feroxes/pytaichenko/site/assets/photo.jpg

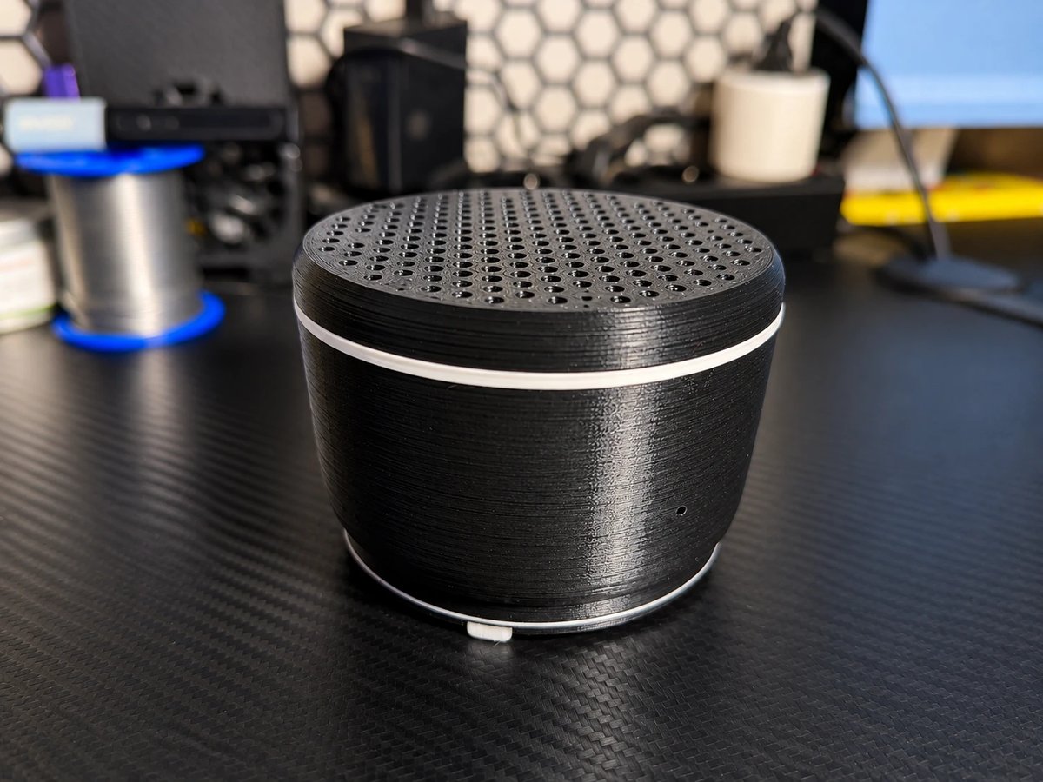
site/assets/photo.jpg
