feroxes/pytaichenko/site/assets/photos-v2/inside.jpg

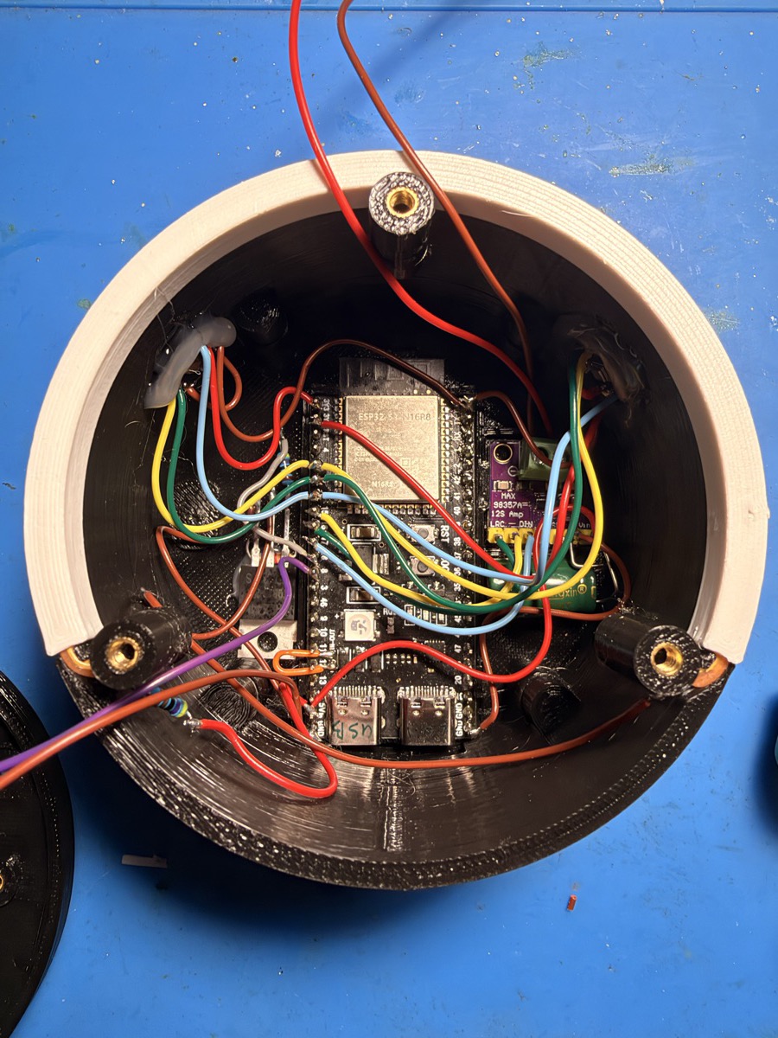
site/assets/photos-v2/inside.jpg
