feroxes/pytaichenko/site/assets/photos-v2/pytaichenko.jpg

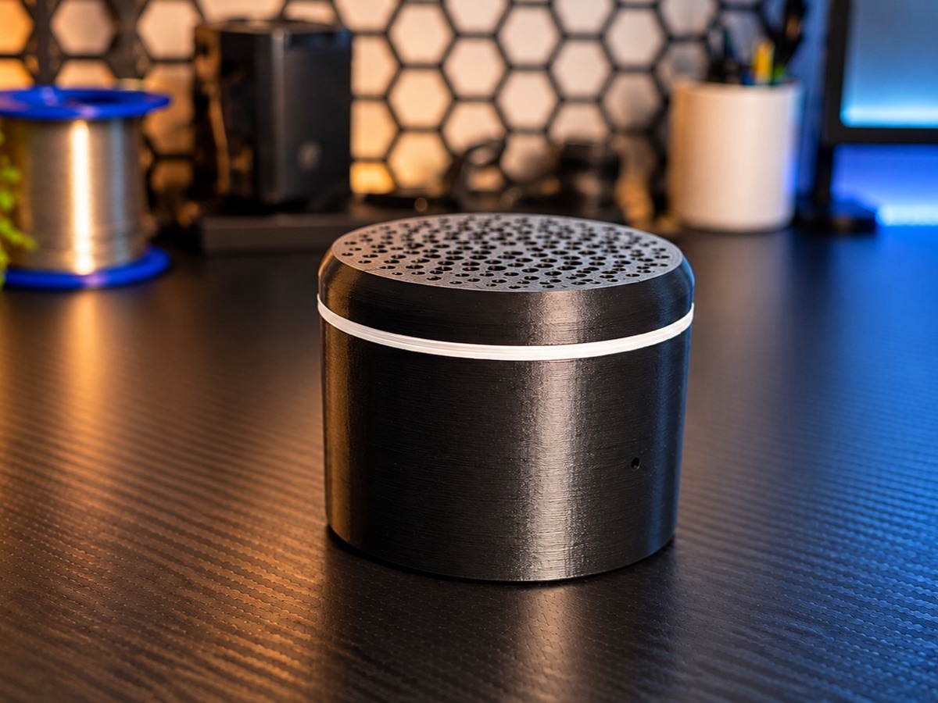
site/assets/photos-v2/pytaichenko.jpg
