feroxes/pytaichenko/site/assets/renders/v2/hero.png

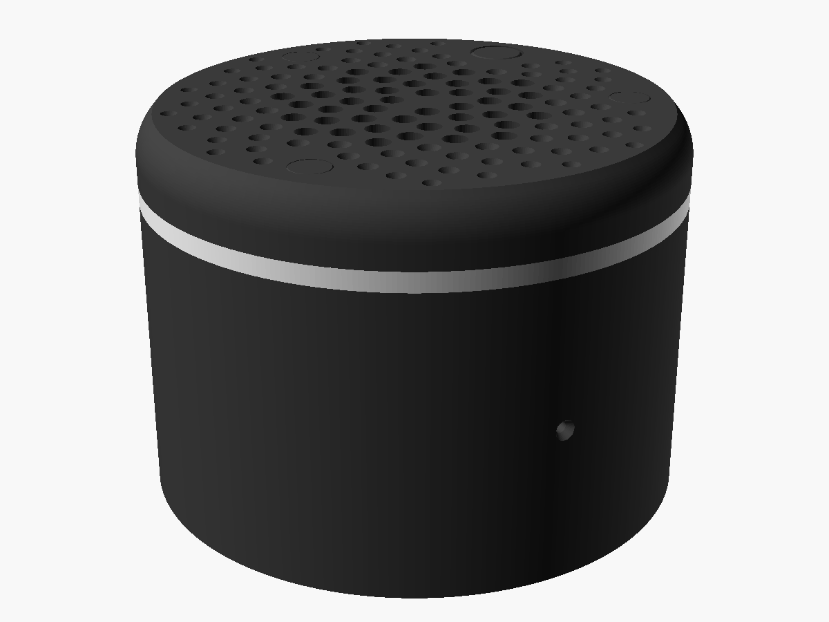
site/assets/renders/v2/hero.png
