feroxes/pytaichenko/v2/case/stl/PETG-black_tray.stl

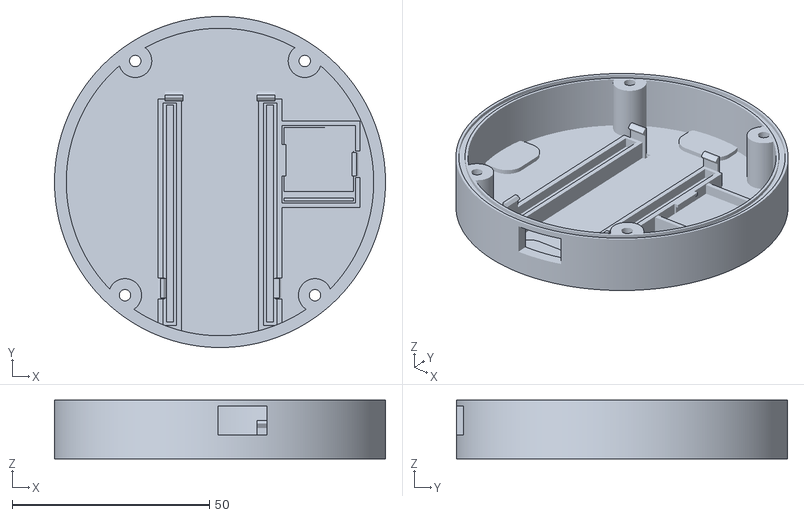
[picture p6: CAD file, 2026-11-10]
v2/case/stl/PETG-black_tray.stl
84.0 x 84.0 x 14.9
