feroxes/pytaichenko/v2/case/stl/TPU_top_gasket.stl

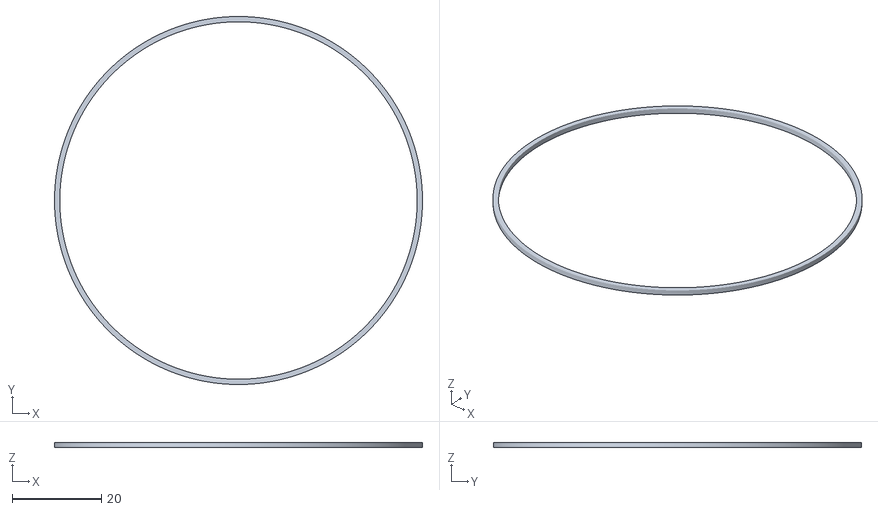
[picture p7: CAD file, 2026-11-10]
v2/case/stl/TPU_top_gasket.stl
82.5 x 82.5 x 1.20
