feroxes/pytaichenko/v2/case/stl/TPU_com_bushing.stl

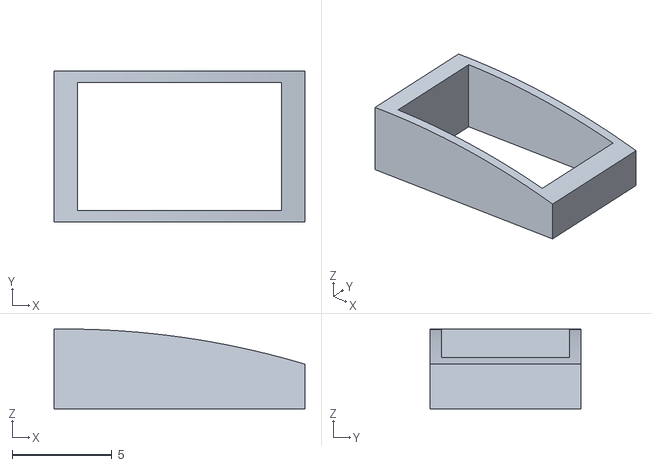
[picture p8: CAD file, 2026-11-10]
v2/case/stl/TPU_com_bushing.stl
12.6 x 7.55 x 4.00
