feroxes/pytaichenko/v2/case/stl/PETG-white_ring_arc.stl

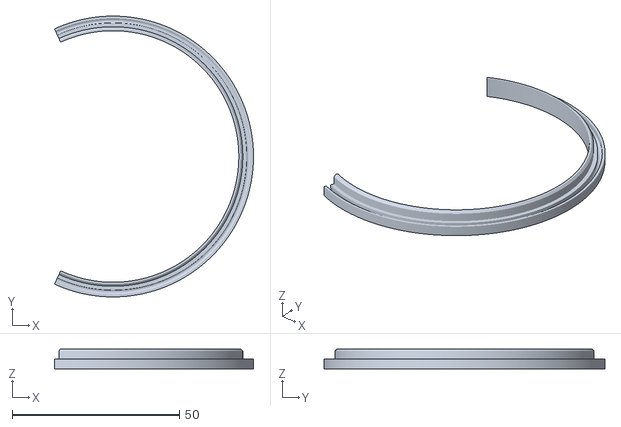
[picture p9: CAD file, 2026-11-10]
v2/case/stl/PETG-white_ring_arc.stl
59.5 x 84.0 x 5.88
