feroxes/pytaichenko/v2/case/stl/PETG-black_body.stl

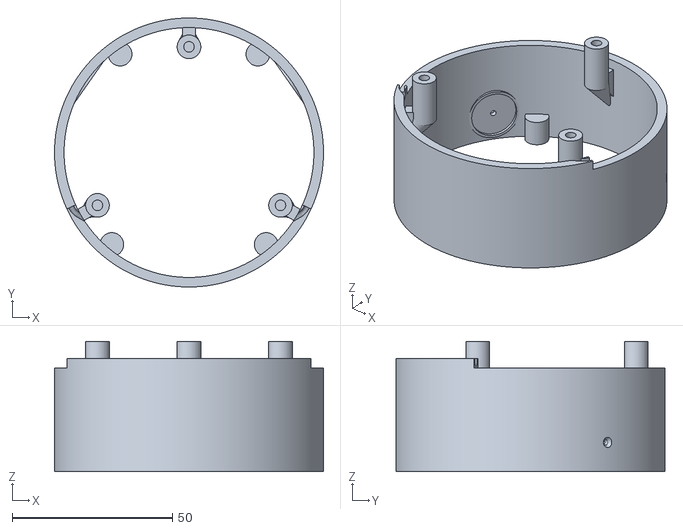
[picture p10: CAD file, 2026-11-10]
v2/case/stl/PETG-black_body.stl
84.0 x 84.0 x 40.6
