feroxes/pytaichenko/v2/case/stl/PETG-black_top.stl

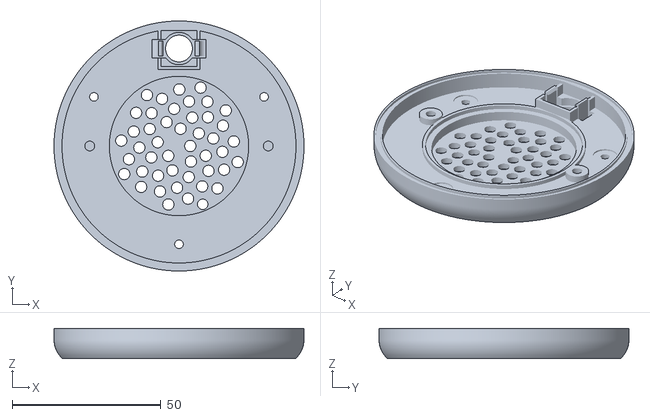
[picture p11: CAD file, 2026-11-10]
v2/case/stl/PETG-black_top.stl
84.0 x 84.0 x 10.2
