feroxes/pytaichenko/v2/case/stl/PETG-black_top_plug_x3.stl

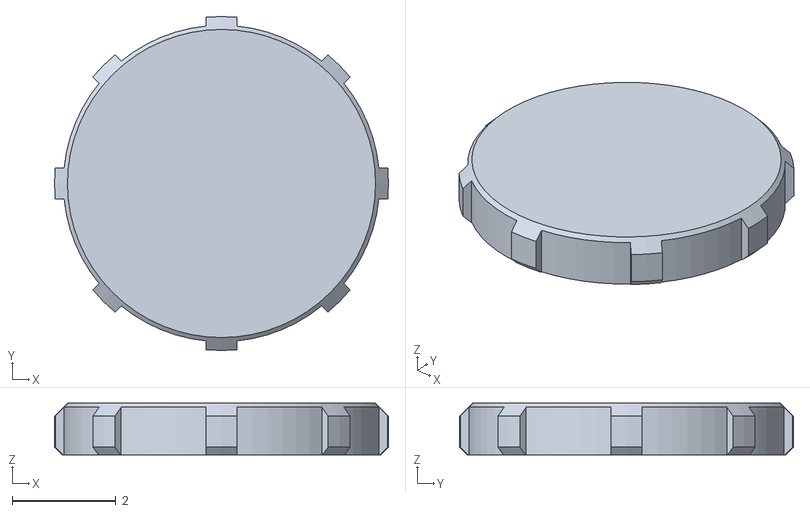
[picture p12: CAD file, 2026-11-10]
v2/case/stl/PETG-black_top_plug_x3.stl
6.44 x 6.44 x 1.00
