feroxes/pytaichenko/v2/case/stl/TPU_speaker_gasket.stl

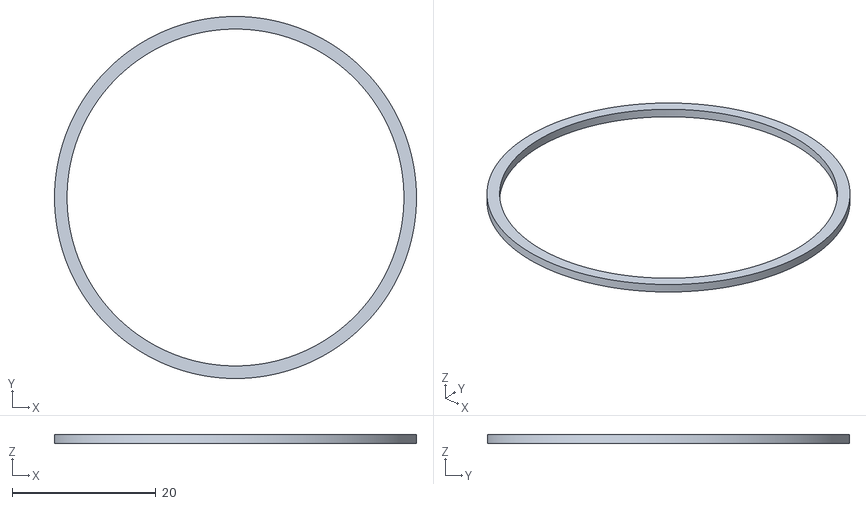
[picture p13: CAD file, 2026-11-10]
v2/case/stl/TPU_speaker_gasket.stl
50.3 x 50.3 x 1.20
