feroxes/pytaichenko/v2/case/stl/PETG-black_button_cap.stl

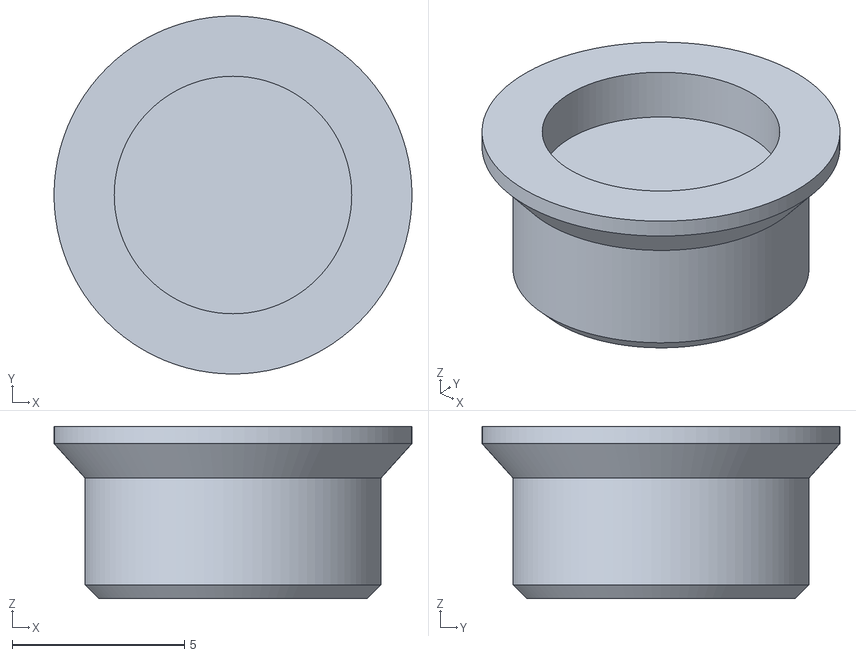
[picture p14: CAD file, 2026-11-10]
v2/case/stl/PETG-black_button_cap.stl
10.4 x 10.4 x 5.00
