feroxes/pytaichenko/v2/case/stl/TPU_foot_x4.stl

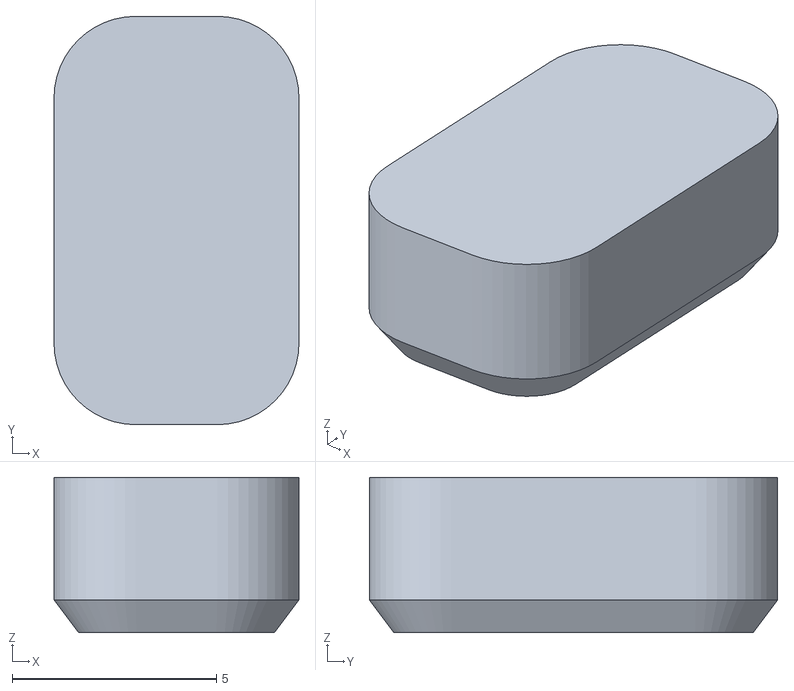
[picture p15: CAD file, 2026-11-02]
v2/case/stl/TPU_foot_x4.stl
6.00 x 10.0 x 3.80
