feroxes/pytaichenko/v1/case/stl/PETG-black_body.stl

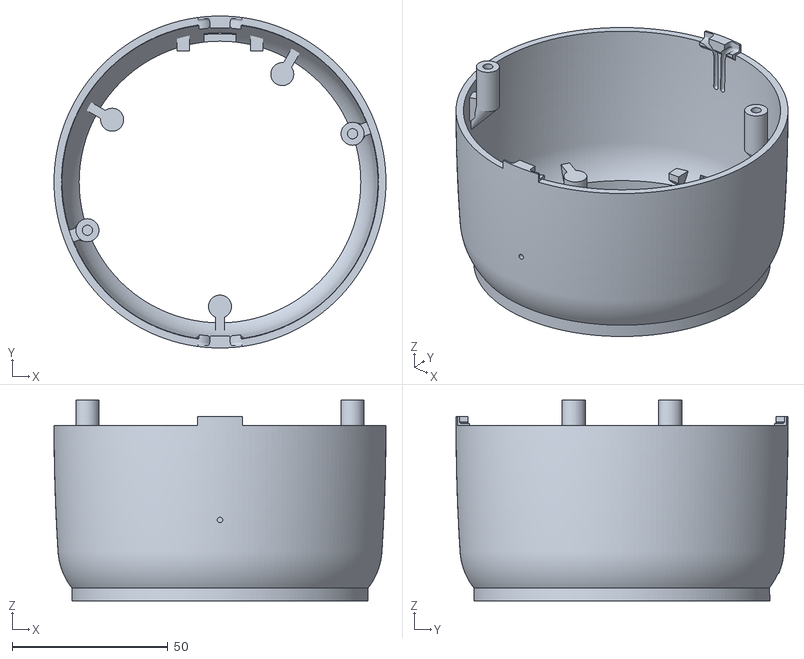
[picture p16: CAD file, 2026-11-02, an earlier design]
v1/case/stl/PETG-black_body.stl
106.6 x 106.6 x 64.5
