feroxes/pytaichenko/v1/case/stl/TPU_top_plug_x2.stl

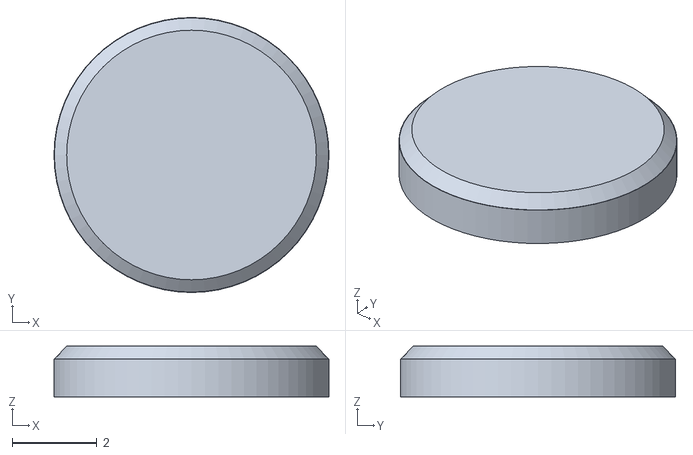
[picture p17: CAD file, 2026-11-02, an earlier design]
v1/case/stl/TPU_top_plug_x2.stl
6.50 x 6.50 x 1.20
