feroxes/pytaichenko/v1/case/stl/PETG-black_top.stl

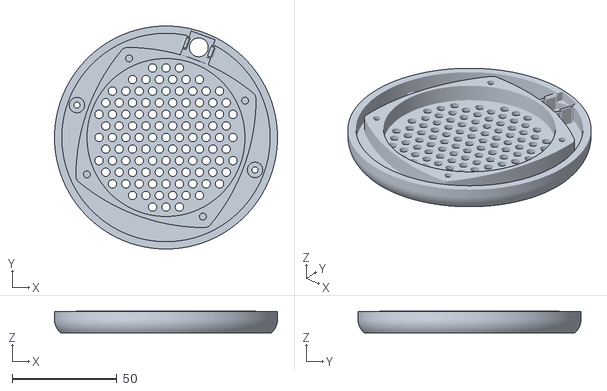
[picture p18: CAD file, 2026-11-02, an earlier design]
v1/case/stl/PETG-black_top.stl
106.6 x 106.6 x 10.3
