feroxes/pytaichenko/v1/case/stl/PETG-black_tray.stl

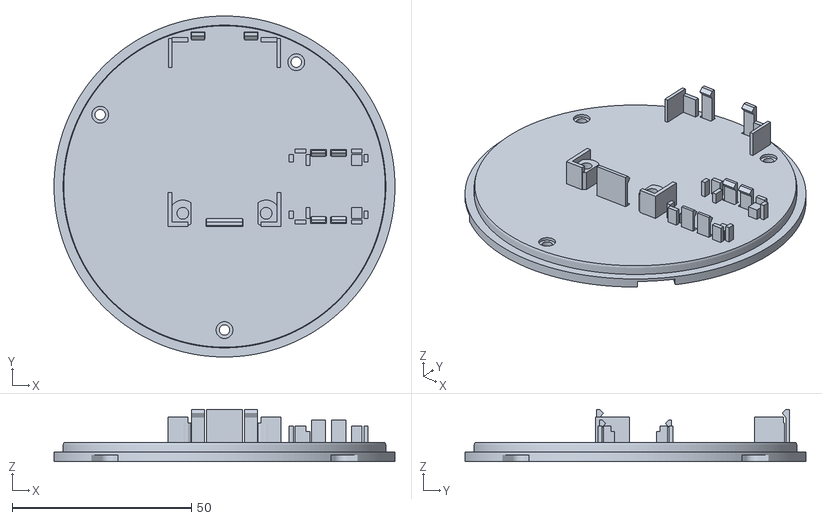
[picture p19: CAD file, 2026-11-02, an earlier design]
v1/case/stl/PETG-black_tray.stl
95.0 x 95.0 x 14.5
