feroxes/pytaichenko/v1/case/stl/TPU_tray_gasket.stl

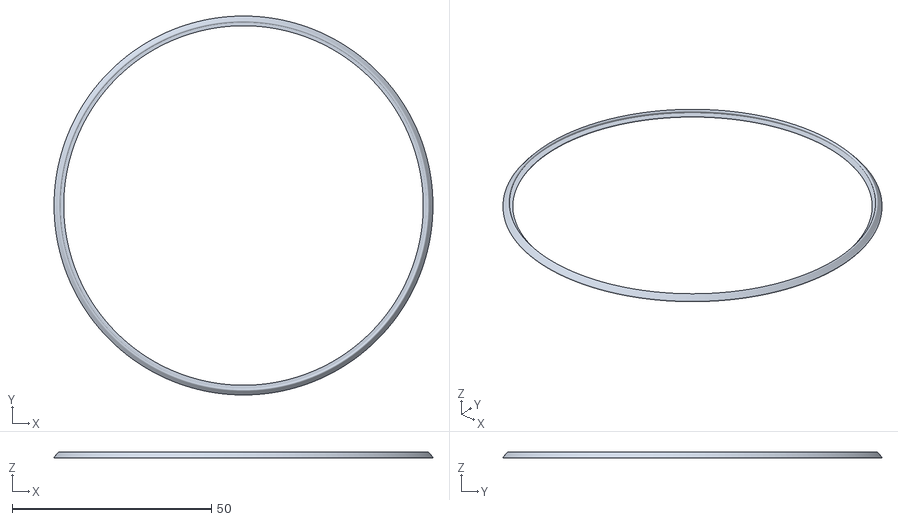
[picture p20: CAD file, 2026-11-02, an earlier design]
v1/case/stl/TPU_tray_gasket.stl
95.0 x 95.0 x 1.50
