feroxes/pytaichenko/v1/case/stl/PETG-white_ring_arc_x2.stl

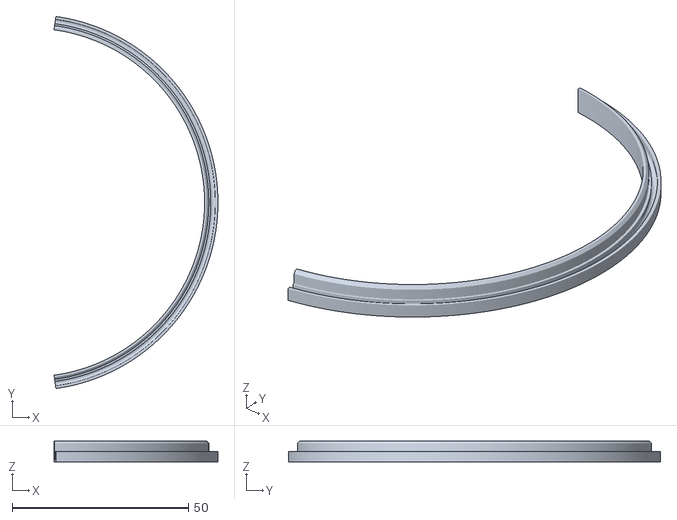
[picture p21: CAD file, 2026-11-02, an earlier design]
v1/case/stl/PETG-white_ring_arc_x2.stl
46.5 x 105.6 x 5.88
