feroxes/pytaichenko/(list of files, cad)

Other CAD files:
v2/case/stl/TPU_tray_gasket.stl
v1/case/stl/PETG-black_button_cap.stl
v1/case/body.scad
v1/case/dummies.scad
v1/case/lib.scad
v1/case/params.scad
v1/case/ring.scad
v1/case/small.scad
v1/case/steps.scad
v1/case/stl/TPU_speaker_gasket.stl
v1/case/top.scad
v1/case/tray.scad
v1/case/voice-case.scad
