feroxes/pytaichenko/site/assets/renders/assembly-27.png

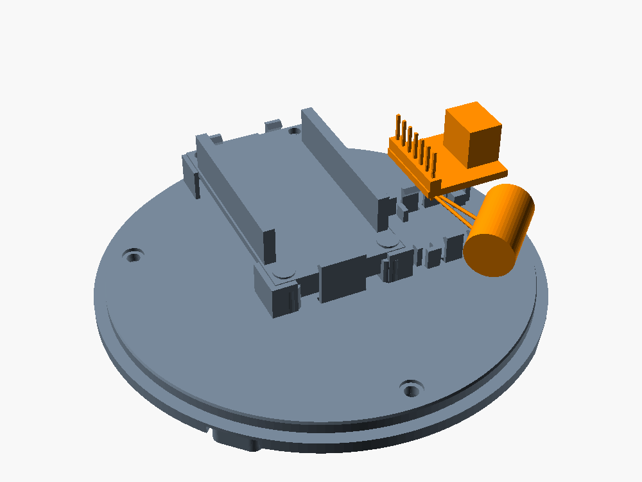
site/assets/renders/assembly-27.png
