feroxes/pytaichenko/site/assets/renders/assembly-28.png

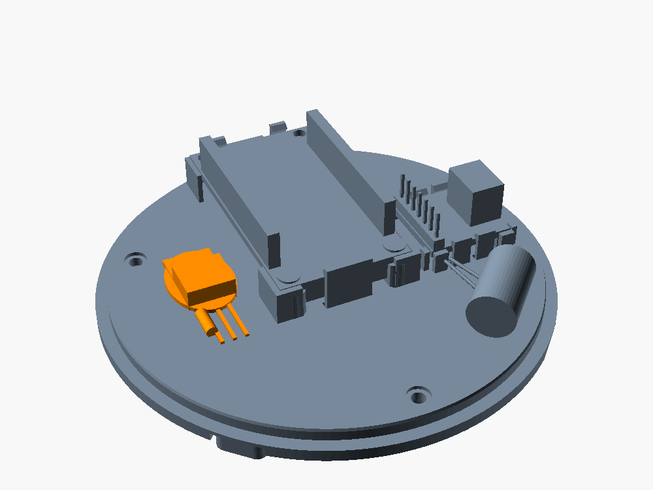
site/assets/renders/assembly-28.png
