feroxes/pytaichenko/site/assets/renders/assembly-32.png

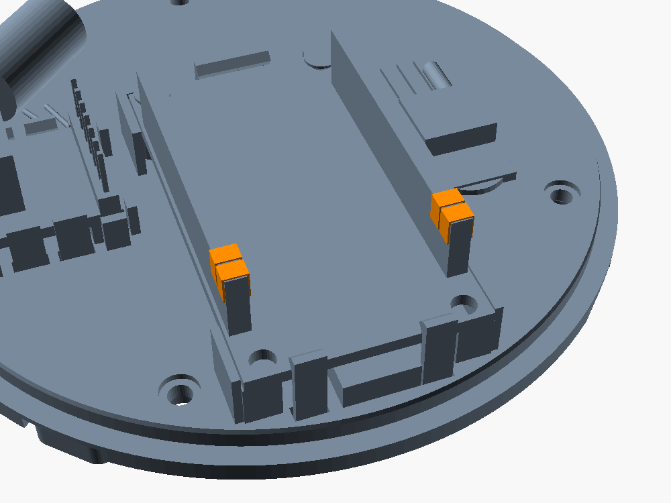
site/assets/renders/assembly-32.png
