feroxes/pytaichenko/site/assets/renders/assembly-33.png

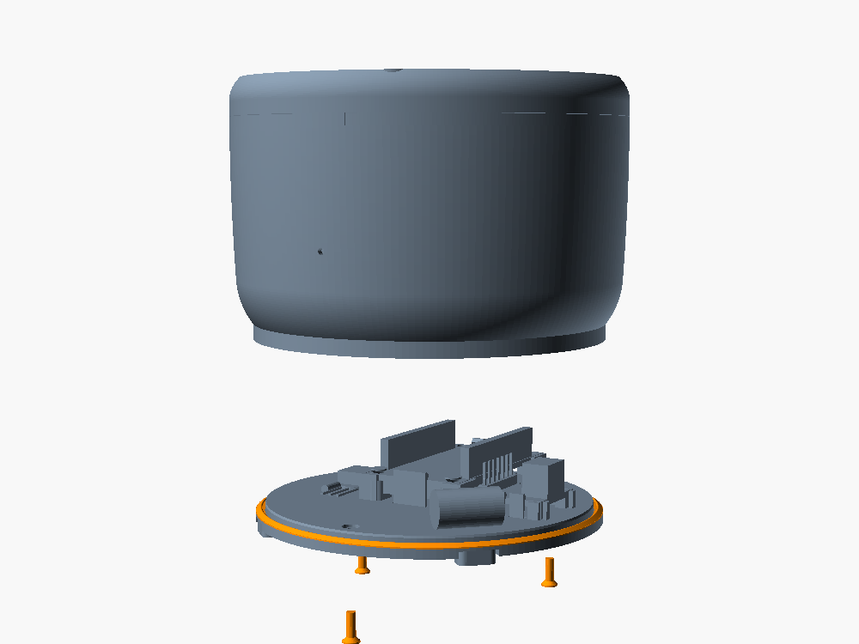
site/assets/renders/assembly-33.png
