feroxes/pytaichenko/site/assets/renders/v2/assembly-01.png

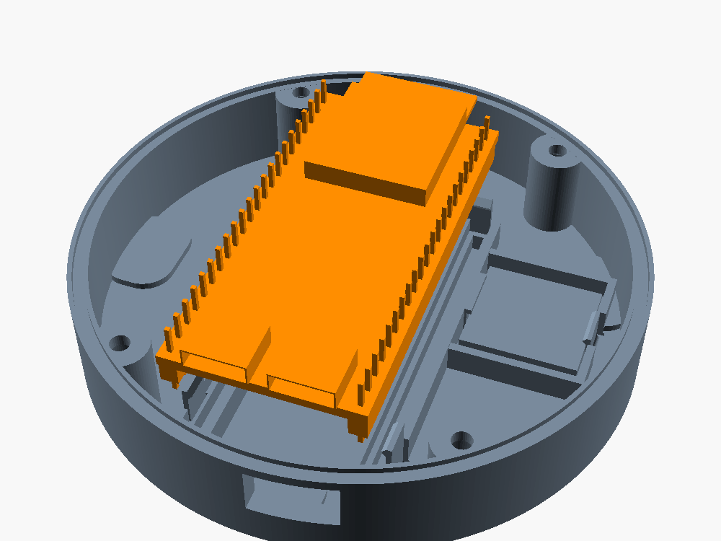
site/assets/renders/v2/assembly-01.png
