feroxes/pytaichenko/site/assets/renders/v2/assembly-02.png

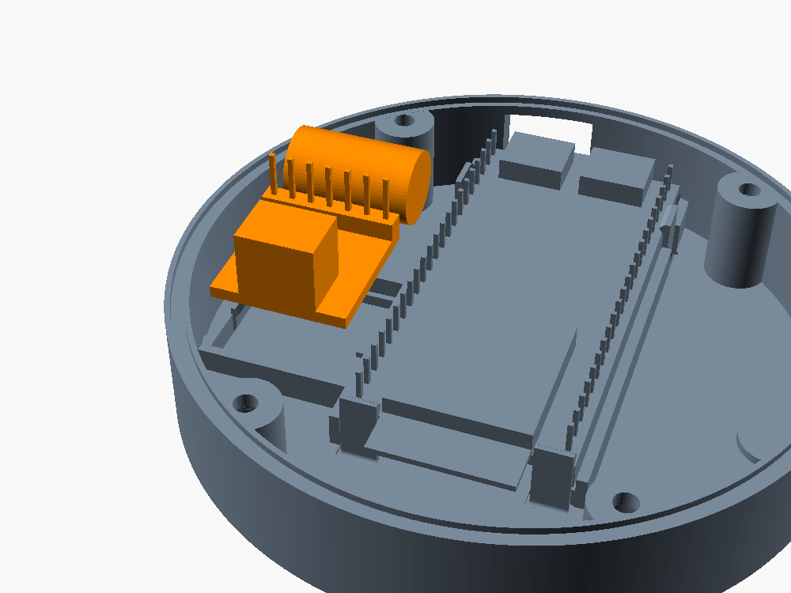
site/assets/renders/v2/assembly-02.png
