feroxes/pytaichenko/site/assets/renders/v2/assembly-03.png

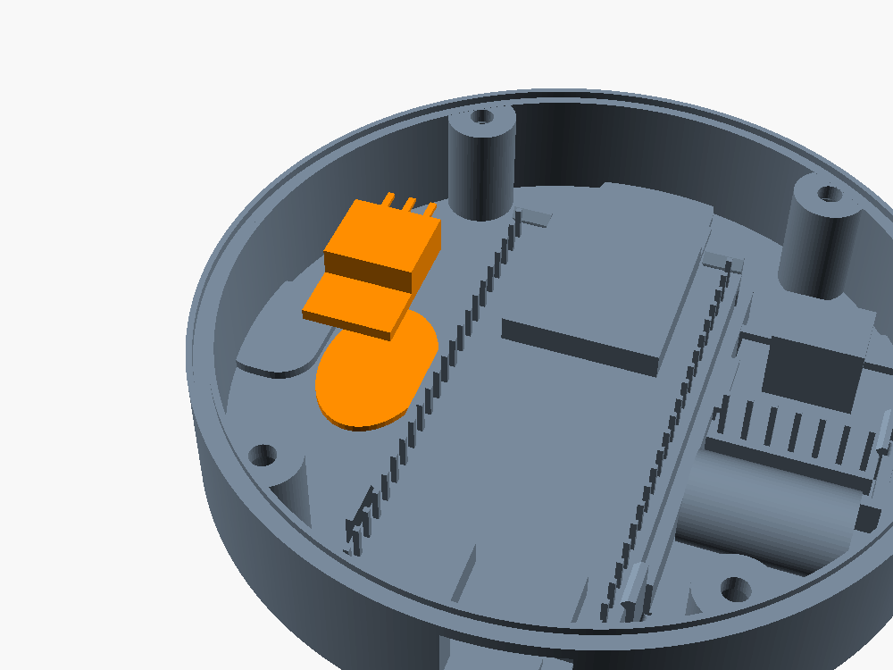
site/assets/renders/v2/assembly-03.png
