feroxes/pytaichenko/site/assets/renders/v2/assembly-04.png

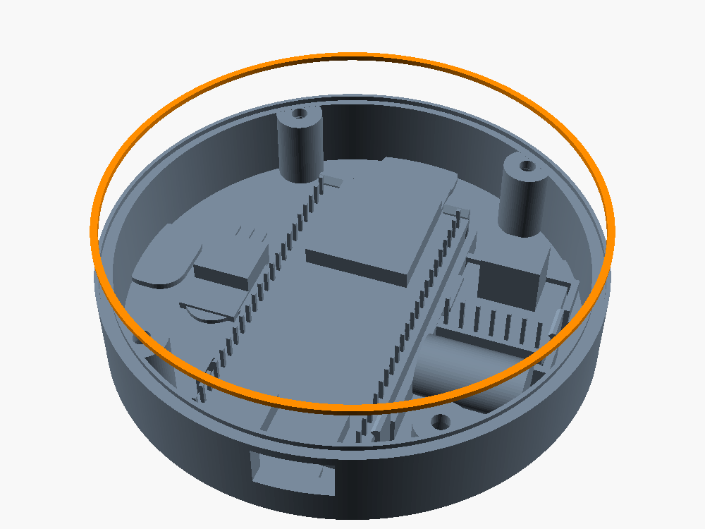
site/assets/renders/v2/assembly-04.png
