feroxes/pytaichenko/site/assets/renders/v2/assembly-05.png

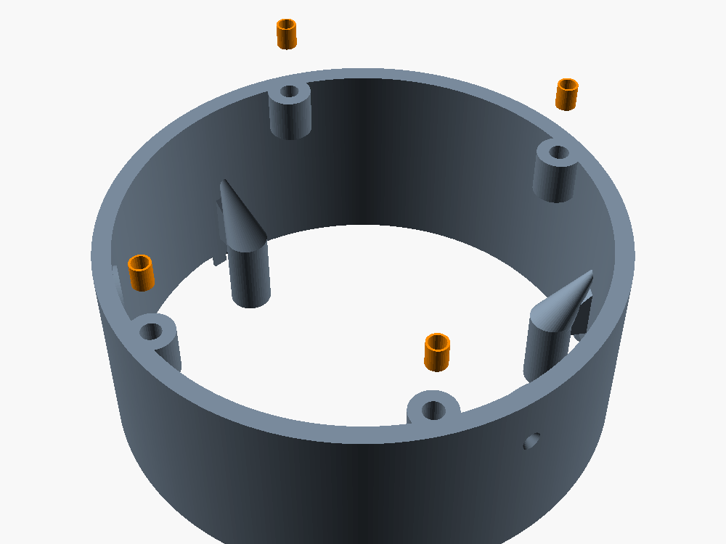
site/assets/renders/v2/assembly-05.png
