feroxes/pytaichenko/site/assets/renders/v2/assembly-06.png

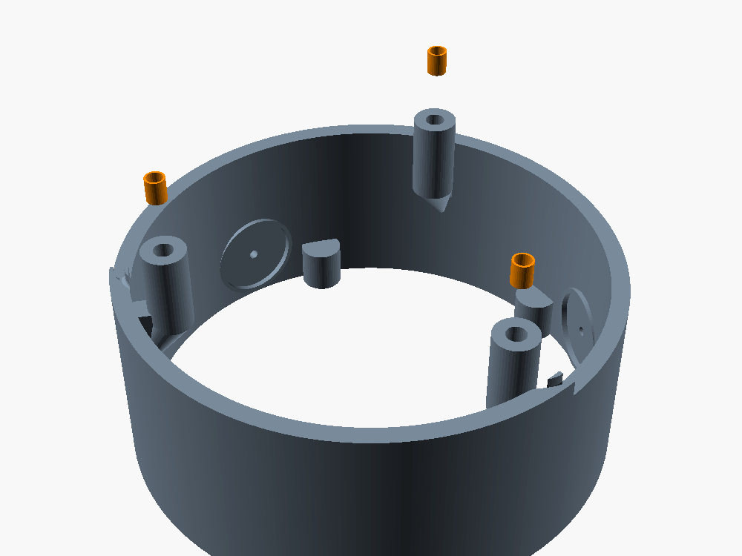
site/assets/renders/v2/assembly-06.png
