feroxes/pytaichenko/site/assets/renders/v2/assembly-07.png

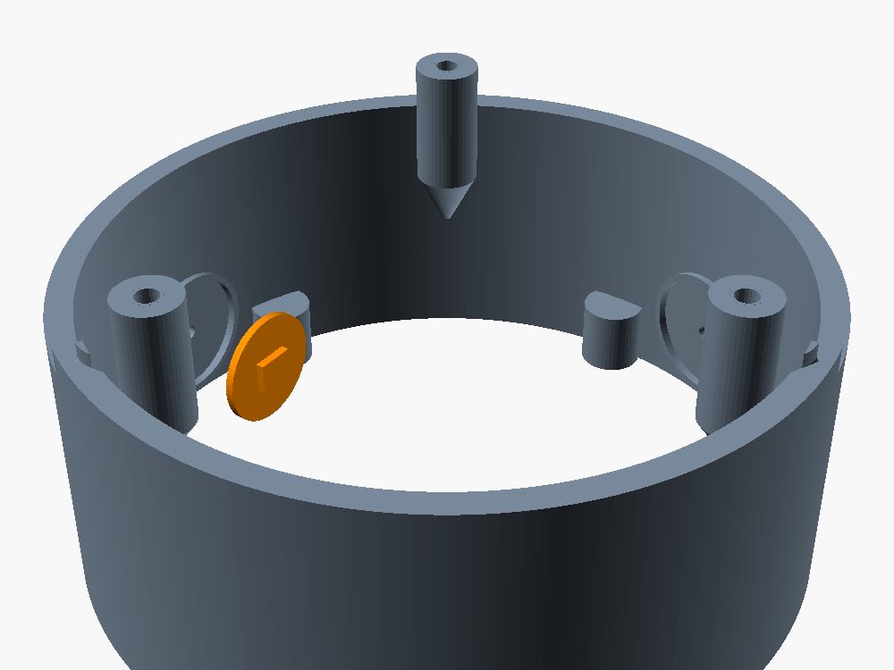
site/assets/renders/v2/assembly-07.png
