feroxes/pytaichenko/site/assets/renders/v2/assembly-09.png

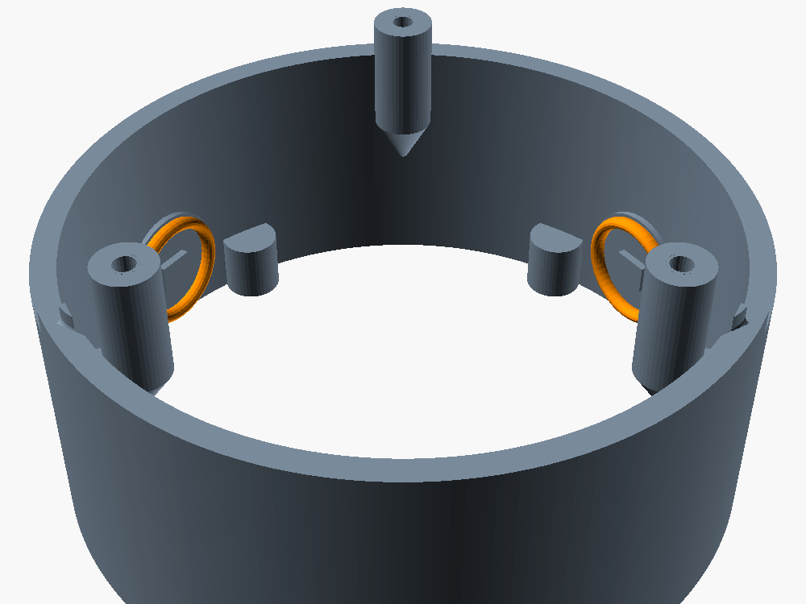
site/assets/renders/v2/assembly-09.png
