feroxes/pytaichenko/site/assets/renders/v2/assembly-10.png

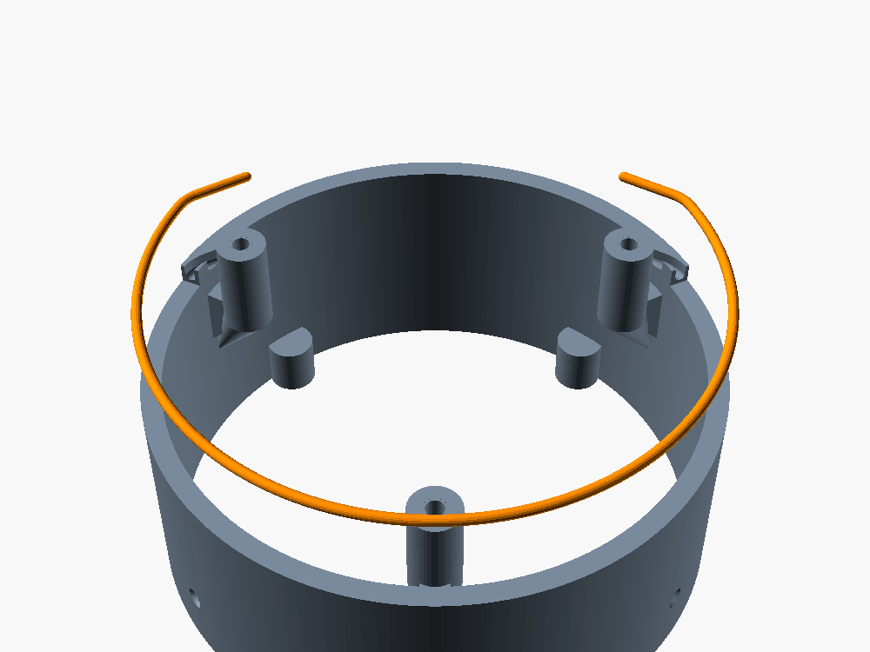
site/assets/renders/v2/assembly-10.png
