feroxes/pytaichenko/site/assets/renders/v2/assembly-11.png

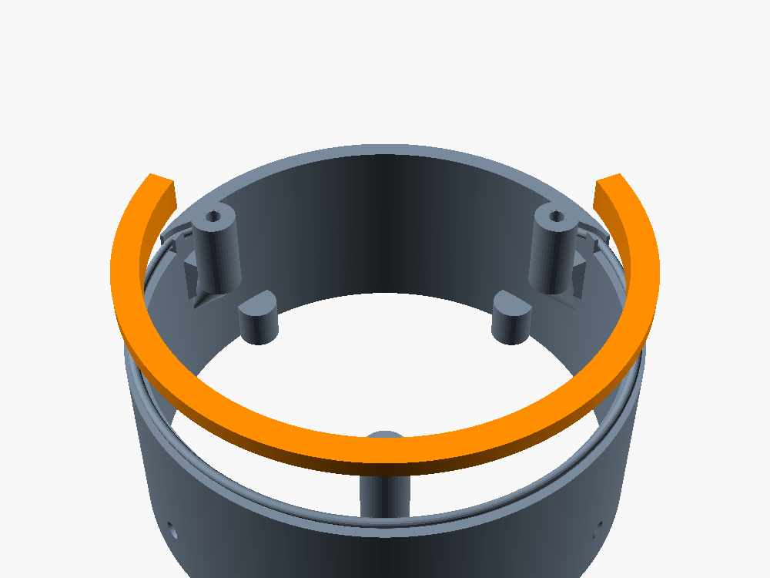
site/assets/renders/v2/assembly-11.png
