feroxes/pytaichenko/site/assets/renders/v2/assembly-12.png

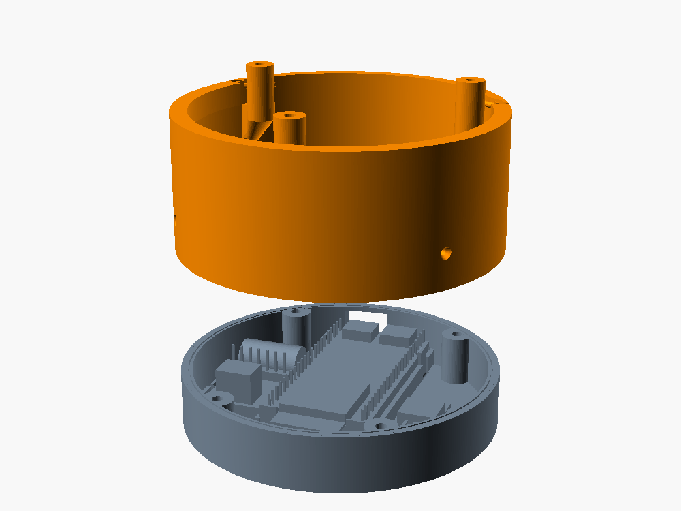
site/assets/renders/v2/assembly-12.png
