feroxes/pytaichenko/site/assets/renders/v2/assembly-13.png

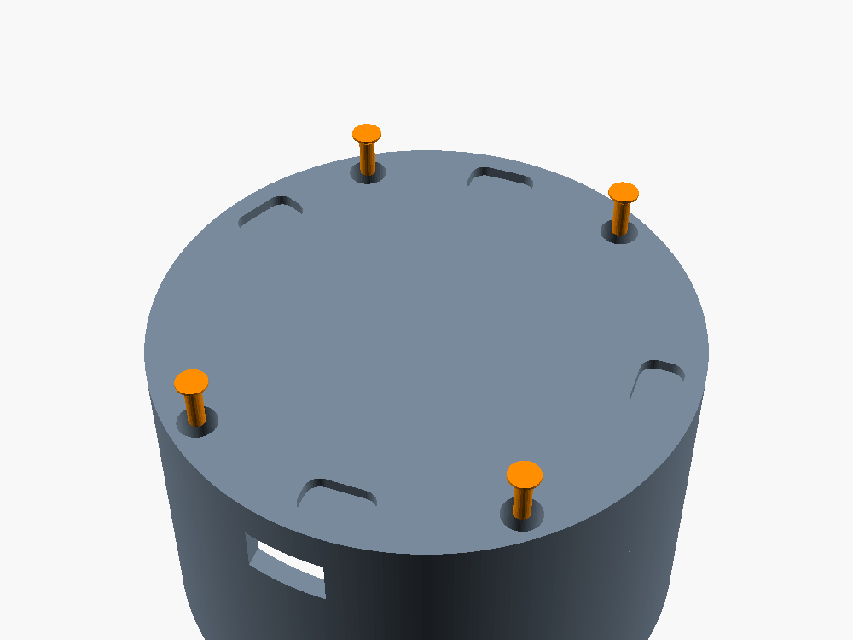
site/assets/renders/v2/assembly-13.png
