feroxes/pytaichenko/site/assets/renders/v2/assembly-14.png

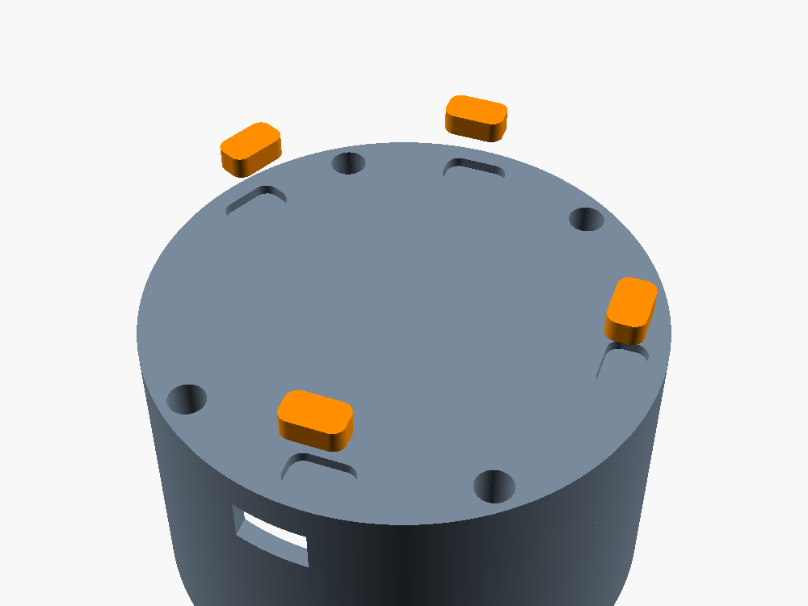
site/assets/renders/v2/assembly-14.png
