feroxes/pytaichenko/site/assets/renders/v2/assembly-15.png

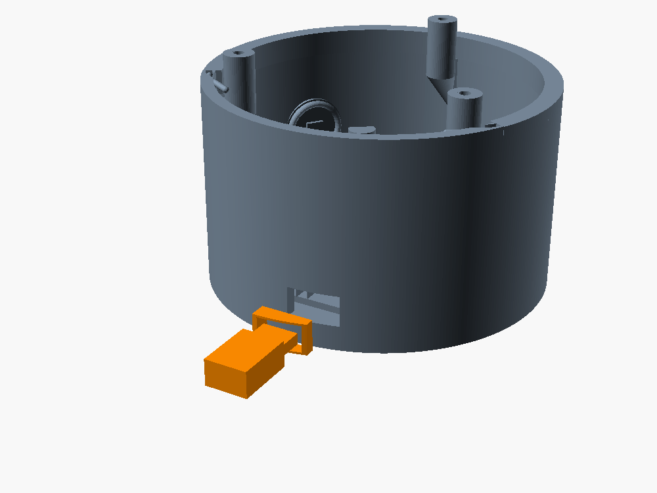
site/assets/renders/v2/assembly-15.png
