feroxes/pytaichenko/site/assets/renders/v2/assembly-16.png

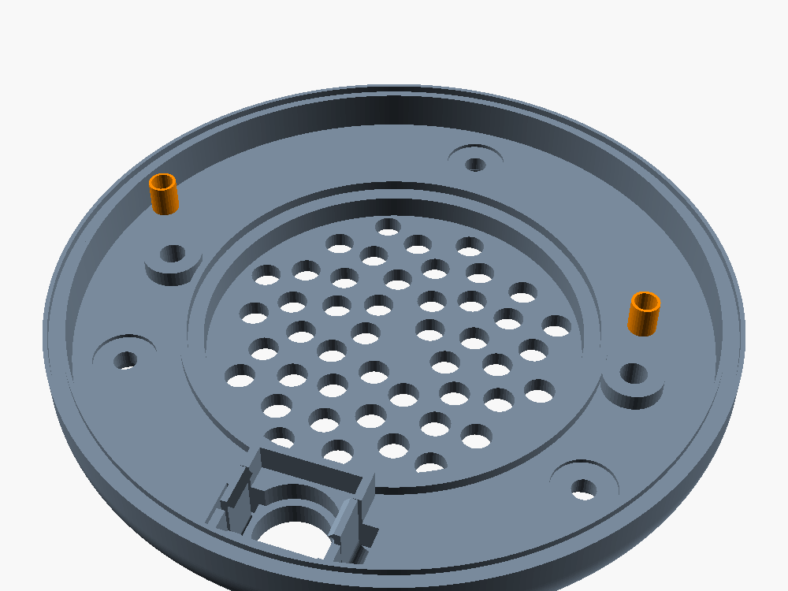
site/assets/renders/v2/assembly-16.png
