feroxes/pytaichenko/site/assets/renders/v2/assembly-17.png

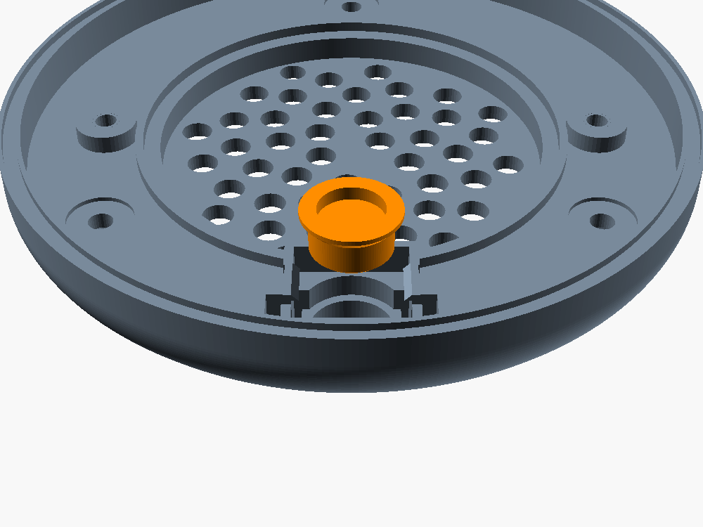
site/assets/renders/v2/assembly-17.png
