feroxes/pytaichenko/site/assets/renders/v2/assembly-18.png

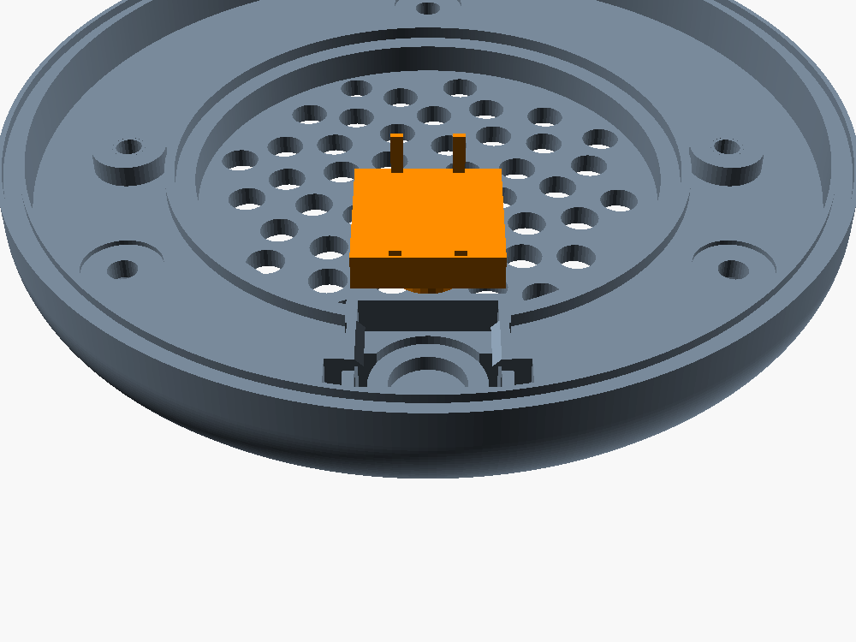
site/assets/renders/v2/assembly-18.png
