feroxes/pytaichenko/site/assets/renders/v2/assembly-19.png

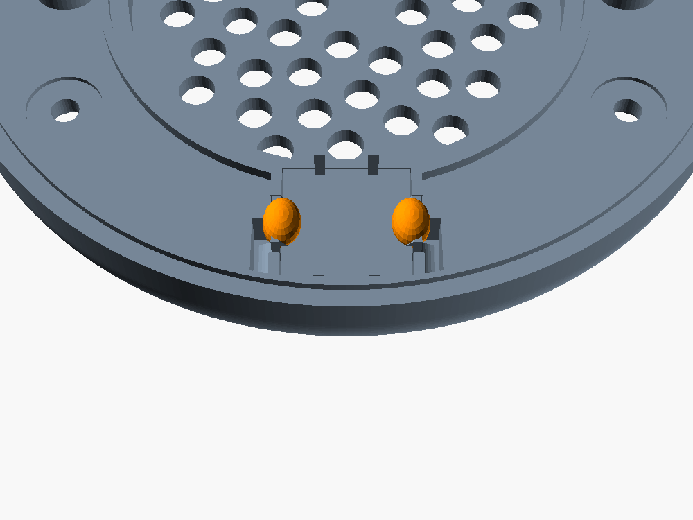
site/assets/renders/v2/assembly-19.png
