feroxes/pytaichenko/site/assets/renders/v2/assembly-20.png

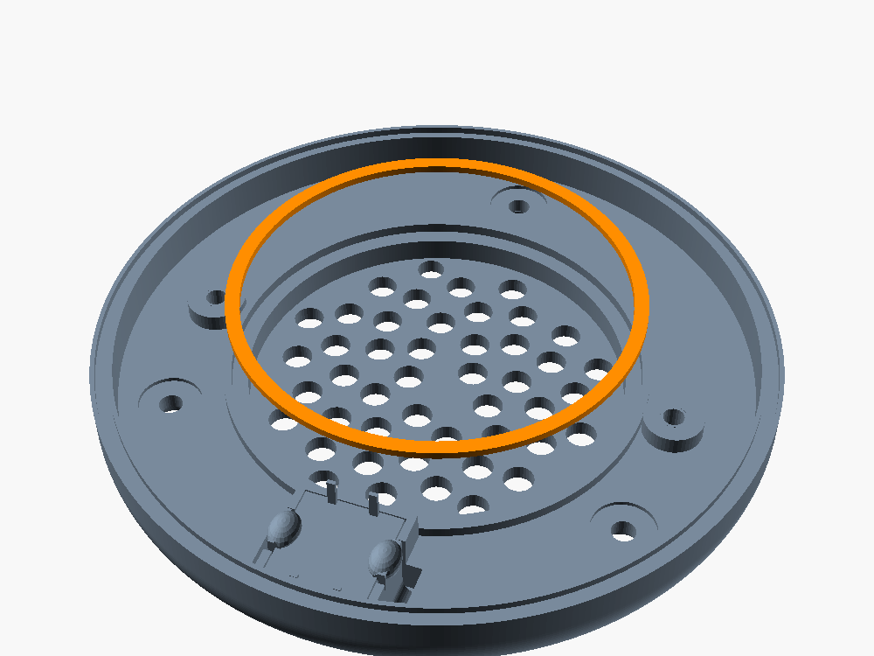
site/assets/renders/v2/assembly-20.png
