feroxes/pytaichenko/site/assets/renders/v2/assembly-21.png

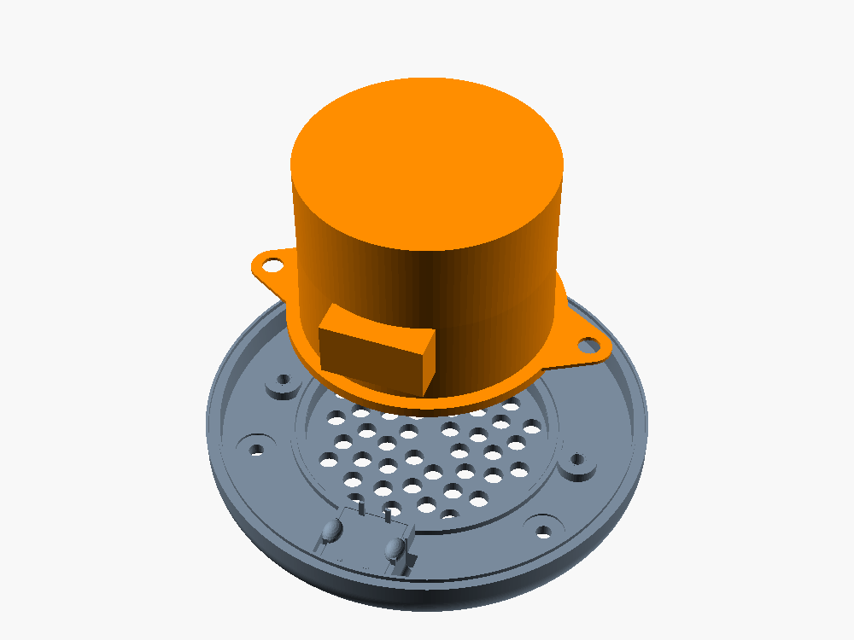
site/assets/renders/v2/assembly-21.png
