feroxes/pytaichenko/site/assets/renders/v2/assembly-22.png

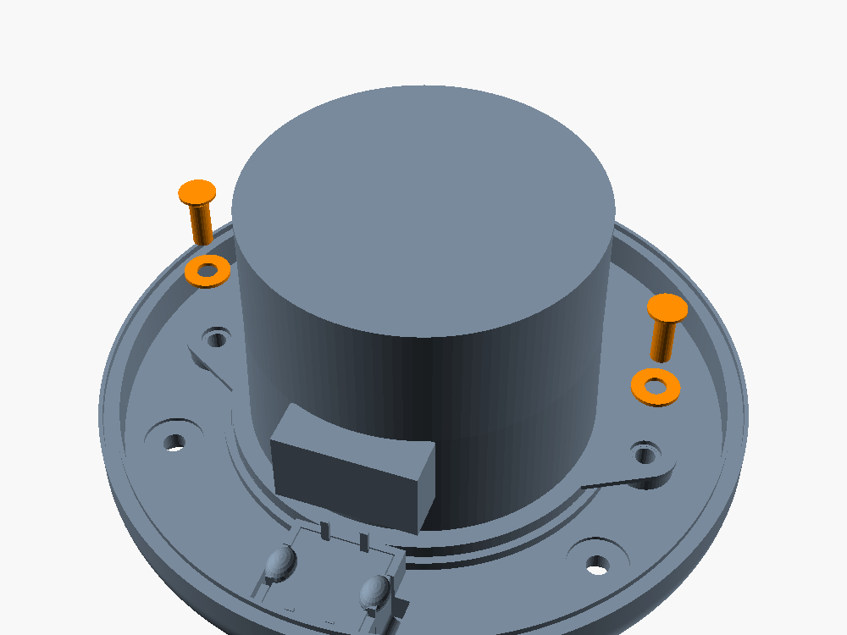
site/assets/renders/v2/assembly-22.png
