feroxes/pytaichenko/site/assets/renders/v2/assembly-23.png

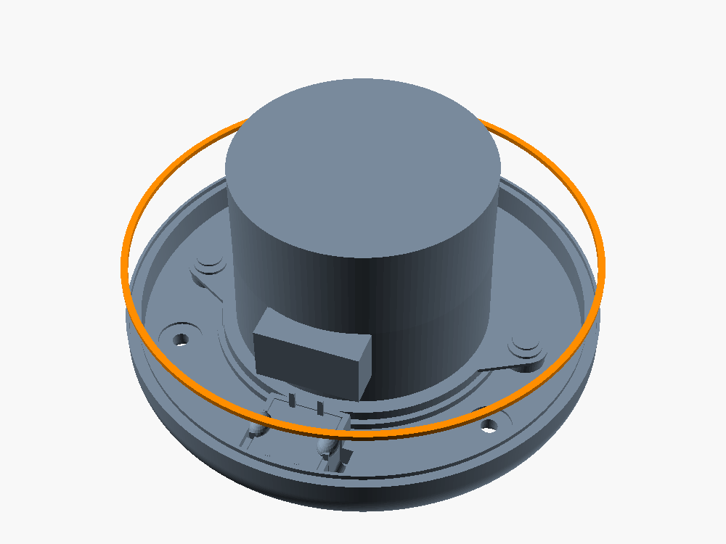
site/assets/renders/v2/assembly-23.png
