feroxes/pytaichenko/site/assets/renders/v2/assembly-24.png

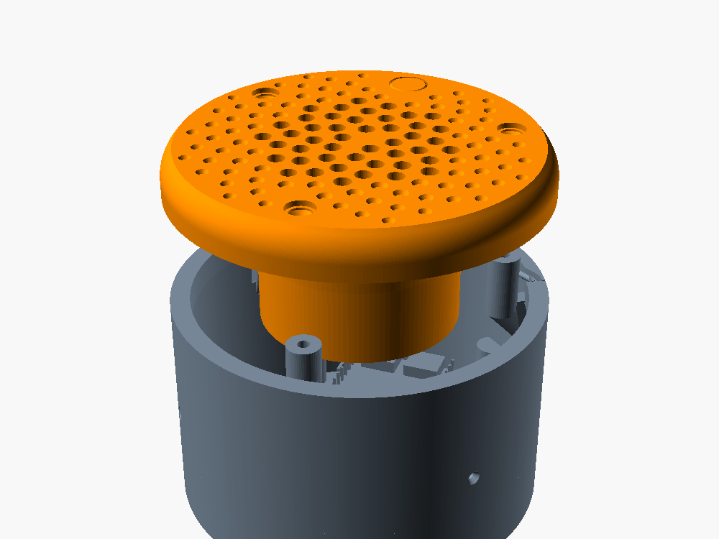
site/assets/renders/v2/assembly-24.png
