feroxes/pytaichenko/site/assets/renders/v2/assembly-25.png

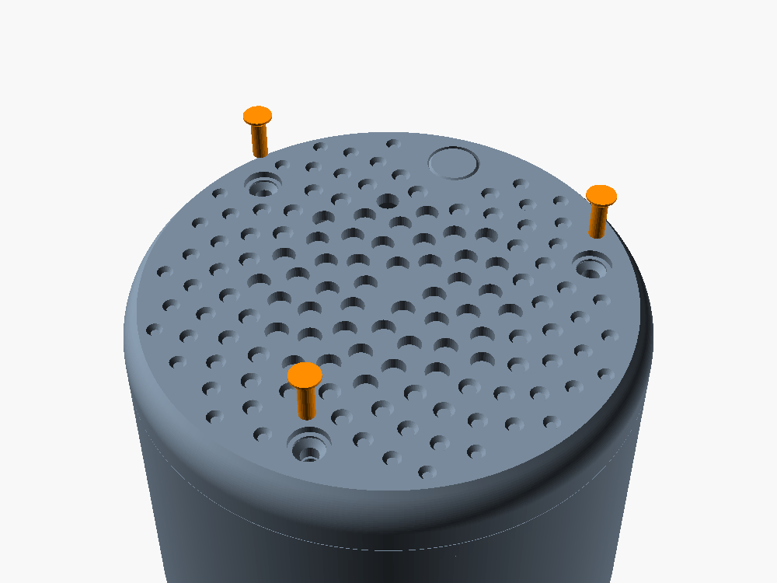
site/assets/renders/v2/assembly-25.png
