feroxes/pytaichenko/CHANGELOG.md

# Changelog

Notable changes to Pytaichenko, newest first. The format follows [Keep a Changelog](https://keepachangelog.com/en/1.1.0/). There are two speakers, each with its own line of versions: 1.x is version 1 (with a home server), 2.x is version 2 (on its own). Within a line, a new middle number means new features and a new last number fixes.

Помітні зміни «Питайченка», найновіші зверху. Колонок дві, у кожної своя лінія версій: 1.x — версія 1 (з домашнім сервером), 2.x — версія 2 (сама по собі). У межах лінії нове середнє число означає нові можливості, останнє — виправлення.

## [2.1.0] - 2026-11-13

### Added

- Speaker: it can now talk through OpenAI GPT-Live (`gpt-live-1`). Choose it in the “Model” field on the speaker's settings page: the conversation is faster and more natural. GPT-Live is billed at $0.05 per minute of conversation plus a small charge for the helper model that carries out actions such as changing the volume or ending the conversation. The realtime models (`gpt-realtime-2.1-mini`, the default, and `gpt-realtime-2.1`) work as before.
- With GPT-Live the speaker keeps a ready connection to OpenAI between conversations (it costs nothing until you speak), so the start of your question is not lost and the first answer comes sooner. If GPT-Live stays silent after you speak, for example after “thank you, that's all”, the conversation ends after 3 seconds.

### Changed

- The connection to OpenAI is steadier: the speaker uses larger network buffers and sends the microphone sound in fewer, larger pieces.
- The default instructions allow fuller answers: one sentence for a simple question, usually three to five sentences when an explanation or advice is needed (before, the limit was one or two short sentences). A speaker that already has instructions keeps them: to get the new text, press “Restore defaults” under the instructions on its settings page.

### Українською

- Колонка тепер може говорити через OpenAI GPT-Live (`gpt-live-1`). Оберіть його в полі «Модель» на сторінці налаштувань колонки: розмова швидша й природніша. GPT-Live оплачується по 0,05 $ за хвилину розмови плюс невелика плата за допоміжну модель, яка виконує дії, як-от зміну гучності чи завершення розмови. Моделі реального часу (`gpt-realtime-2.1-mini`, типова, і `gpt-realtime-2.1`) працюють як і раніше.
- З GPT-Live колонка між розмовами тримає готове з'єднання з OpenAI (поки ви не заговорите, воно нічого не коштує), тож початок питання не губиться, а перша відповідь приходить швидше. Якщо після ваших слів GPT-Live мовчить, наприклад після «дякую, все», розмова закінчується за 3 секунди.
- З'єднання з OpenAI стабільніше: колонка використовує більші мережеві буфери й надсилає звук мікрофона рідше, більшими шматками.
- Типові інструкції дозволяють повніші відповіді: на просте питання — одне речення, а коли потрібні пояснення чи порада — зазвичай три-п'ять речень (раніше межа була одне-два коротких речення). Колонка, у якої інструкції вже є, зберігає їх: щоб отримати новий текст, натисніть «Повернути типові» під інструкціями на її сторінці налаштувань.

## [2.0.1] - 2026-11-10

### Fixed

- Updates from GitHub on the speaker's settings page stopped with “the firmware file could not be downloaded”: GitHub hands the file out from a long address that did not fit into the speaker's request. A speaker on 2.0.0 cannot update itself from GitHub, so install 2.0.1 once by hand: on its settings page under “Firmware from a file” with `pytaichenko-2.0.1.ota.bin` from this release, or with “Update” in the installer on the site. Later updates from GitHub work again.

### Changed

- Site: counts page views with Cloudflare Web Analytics, which sets no cookies.

### Українською

- Оновлення з GitHub на сторінці налаштувань колонки зупинялось з «the firmware file could not be downloaded»: GitHub віддає файл із довгої адреси, яка не вміщалась у запит колонки. Колонка на 2.0.0 не може сама оновитися з GitHub, тож 2.0.1 треба один раз встановити вручну: на її сторінці налаштувань у «Прошивка з файлу» з `pytaichenko-2.0.1.ota.bin` з цього релізу або кнопкою «Update» в установнику на сайті. Далі оновлення з GitHub знову працюють.
- Сайт рахує перегляди сторінок через Cloudflare Web Analytics, яка не ставить cookies.

## [2.0.0] - 2026-11-10

Version 2: a new speaker that talks with OpenAI by itself. Version 1 stays as it is.

### Added

- Speaker: an ESP32-S3-DevKitC N16R8 board, two INMP441 microphones, a MAX98357A amplifier with a Visaton FRS 5 X driver, a light ring of one LED filament and a button on top. The wiring, step-by-step soldering with the wire lengths and the pin map are on the site.
- Firmware: written for ESP-IDF. The speaker hears the wake phrase itself (Hey Jarvis, Okay Nabu or Hey Mycroft), cleans the sound of its two microphones and holds the conversation with the OpenAI Realtime API using your own key. It answers in one of ten languages, keeps listening for a follow-up, ends on “thank you, that’s all” and changes the volume by voice.
- Settings page on the speaker itself, in Ukrainian and English: password, OpenAI key and connection check, conversation language and instructions, wake phrase, volume with a sound test, timings, log and updates from GitHub or from a file. Holding the top button for 10 seconds resets the page password.
- Case: a compact round case (Ø84 mm) for 3D printing, with the OpenSCAD model, ready STL files for PETG and TPU and step-by-step assembly pictures.
- Site: a version switch; the version 2 pages cover the parts, printing, soldering, assembly, installing the firmware from the browser and troubleshooting.

### Українською

Версія 2: нова колонка, яка сама розмовляє з OpenAI. Версія 1 лишається як є.

- Колонка: плата ESP32-S3-DevKitC N16R8, два мікрофони INMP441, підсилювач MAX98357A з динаміком Visaton FRS 5 X, кільце світла з однієї світлодіодної нитки й кнопка зверху. Схема підключення, покрокова пайка з довжинами дротів і карта виводів — на сайті.
- Прошивка: написана на ESP-IDF. Колонка сама чує ключову фразу (Hey Jarvis, Okay Nabu або Hey Mycroft), очищує звук двох мікрофонів і веде розмову через OpenAI Realtime API з вашим власним ключем. Відповідає однією з десяти мов, після відповіді слухає продовження, завершує розмову на «дякую, все» й міняє гучність голосом.
- Сторінка налаштувань на самій колонці, українською й англійською: пароль, ключ OpenAI і перевірка з'єднання, мова й інструкції розмови, ключова фраза, гучність із тестом звуку, часи, журнал і оновлення з GitHub або з файлу. Якщо затиснути верхню кнопку на 10 секунд, пароль сторінки скидається.
- Корпус: компактний круглий корпус (Ø84 мм) для 3D-друку — модель OpenSCAD, готові STL-файли для PETG і TPU та покрокові малюнки збирання.
- Сайт: перемикач версій; сторінки версії 2 — деталі, друк, пайка, збирання, встановлення прошивки з браузера й «Якщо щось не так».

## [1.0.0] - 2026-11-02

The first public release: everything needed to build the speaker and run it at home.

### Added

- Speaker: an ESP32 DevKit V1 board with an INMP441 microphone, a MAX98357A amplifier and a speaker, a light ring of two LED filaments and a button on top. The wiring, the soldering steps and the wire lengths are on the site.
- Case: a round case for 3D printing, with the OpenSCAD model, ready STL files for PETG and TPU and step-by-step assembly pictures.
- Firmware: the speaker hears the wake phrase by itself (Hey Jarvis, Okay Nabu or Hey Mycroft), keeps listening for a follow-up after an answer and shows what it is doing with the light ring and short sounds. It installs from the browser on the site, and later versions install the same way without erasing the speaker.
- Server: `voice-hub` runs in Docker on a computer in the home network and holds the conversation with the OpenAI Realtime API using your own key. Its settings page, in Ukrainian and English, sets the password, the OpenAI key, the conversation language and instructions and the timings, finds and adopts speakers and picks their wake phrase.
- Site: the project page in Ukrainian and English with the parts and where to buy them, tools, printing, soldering, assembly, firmware install, server setup and troubleshooting.

### Українською

Перший публічний випуск: усе, що потрібно, щоб зібрати колонку й запустити її вдома.

- Колонка: плата ESP32 DevKit V1, мікрофон INMP441, підсилювач MAX98357A і динамік, кільце світла з двох світлодіодних ниток і кнопка зверху. Схема підключення, кроки пайки й довжини дротів — на сайті.
- Корпус: круглий корпус для 3D-друку — модель OpenSCAD, готові STL-файли для PETG і TPU та покрокові малюнки збирання.
- Прошивка: колонка сама чує ключову фразу (Hey Jarvis, Okay Nabu або Hey Mycroft), після відповіді слухає продовження без фрази й показує, що робить, кільцем світла й короткими звуками. Її ставлять з браузера на сайті, а наступні версії ставляться так само, без стирання колонки.
- Сервер: `voice-hub` працює в Docker на комп'ютері в домашній мережі й веде розмову через OpenAI Realtime API з вашим власним ключем. На його сторінці налаштувань, українською й англійською, задають пароль, ключ OpenAI, мову й інструкції розмови та часи, знаходять і забирають колонки, обирають їм ключову фразу.
- Сайт: сторінка проєкту українською й англійською — деталі й де їх купити, інструменти, друк, пайка, збирання, встановлення прошивки, запуск сервера й «Якщо щось не так».

[2.1.0]: https://github.com/feroxes/pytaichenko/releases/tag/v2.1.0
[2.0.1]: https://github.com/feroxes/pytaichenko/releases/tag/v2.0.1
[2.0.0]: https://github.com/feroxes/pytaichenko/releases/tag/v2.0.0
[1.0.0]: https://github.com/feroxes/pytaichenko/releases/tag/v1.0.0
