feroxes/pytaichenko/site/assets/text.js

(function (window) {
  'use strict';

  var P = (window.PYTAICHENKO = window.PYTAICHENKO || {});

  P.TEXT = {
    uk: {
      'meta.title': 'Питайченко — голосова колонка для розмови з GPT',
      'meta.description': 'Питайченко — голосова колонка з готових плат у надрукованому корпусі: як її зроблено і як повторити.',

      'header.name': 'Питайченко',
      'header.repo': 'GitHub',
      'header.donate': 'Donate',
      'header.repo_soon': 'посилання ще не додано',
      'header.lang_label': 'Мова',
      'header.theme_label': 'Світла тема',
      'header.version_label': 'Версія колонки',
      'header.version_2': 'Версія 2',
      'header.version_1': 'Версія 1',

      'hero.title': 'Голосова колонка для розмови з GPT',
      'hero.lead': 'Колонка зібрана з готових плат, а корпус надрукований на 3D-принтері. Ця версія працює разом із домашнім сервером, який веде розмову з OpenAI. Тут описано, як вона зроблена і як її повторити.',
      'hero.image': 'Питайченко на столі: круглий чорний корпус із решіткою динаміка зверху й білою смужкою кільця під кришкою',

      'toc.title': 'Зміст',
      'toc.about': 'Про колонку',
      'can.title': 'Що вміє',
      'can.item1': 'Вмикається ключовою фразою або кнопкою',
      'can.wake': 'Ключову фразу можна обрати з трьох: Hey Jarvis, Okay Nabu або Hey Mycroft',
      'can.item2': 'Відповідає голосом',
      'can.item3': 'Кільце світлом показує стан',
      'can.item4': 'Після відповіді можна питати далі без фрази',
      'can.item5': '«Дякую, все» завершує розмову',
      'can.item6': 'Гучність змінюється голосом',

      'need.title': 'Перед початком',
      'need.v1_server': 'Для цієї версії потрібен домашній сервер: комп\'ютер у домашній мережі, який працює постійно, з Docker. На ньому працює служба voice-hub, що веде розмову з OpenAI; як її запустити, описано в розділі «Сервер».',
      'need.time_label': 'Орієнтовний час друку',
      'need.time_value': 'близько 7–8 годин',
      'need.cost_label': 'Орієнтовна вартість деталей',
      'need.cost_pending': 'Уточнюється',

      'parts.title': 'Деталі',
      'parts.col.part': 'Деталь',
      'parts.col.qty': 'К-сть',
      'parts.col.price': 'Ціна',
      'parts.col.link': 'Де взяти',
      'parts.caption': 'Кількість вказано на один пристрій.',
      'parts.footnote': 'Ціни — як їх показано на сторінках магазинів {date}; вони можуть змінитися. Ціну в доларах переведено в гривні за курсом НБУ на {rate_date}: 1 $ = {rate} ₴.',
      'parts.no_link': 'посилання ще не додано',
      'parts.generic': 'будь-який постачальник',
      'parts.price_missing': 'ціни ще немає',
      'parts.per_pack': 'за {n} шт.',
      'parts.qty_set': 'набір',
      'parts.qty_kit': '{n} набір',
      'parts.shop.arduino': 'arduino.ua',
      'parts.shop.menstudio': 'MENstudio',
      'parts.shop.rcs': 'RCS Components',
      'parts.shop.aliexpress': 'AliExpress',
      'parts.shop.imrad': 'IMRAD',
      'parts.name.devkit': 'Плата ESP32 DevKit V1, 30 виводів, USB-C',
      'parts.name.mic': 'Модуль мікрофона INMP441',
      'parts.name.amp': 'Модуль підсилювача MAX98357A',
      'parts.name.speaker': 'Динамік 3″ широкосмуговий, 78 мм, 4 Ом, 10 Вт',
      'parts.name.filament': 'Світлодіодна нитка (LED filament)',
      'parts.name.mosfet': 'Транзистор IRLZ44N',
      'parts.name.res47': 'Резистор 47 Ом',
      'parts.name.res62k': 'Резистор 6,2 кОм',
      'parts.name.cap': 'Конденсатор 1000 мкФ, 16 В',
      'parts.name.button': 'Тактова кнопка 12×12 мм',
      'parts.name.inserts': 'Латунні різьбові вставки M2.5',
      'parts.name.screws': 'Гвинти M2.5×8 мм з потайною головкою',
      'parts.name.washers': 'Металеві шайби M2.5 (DIN 125, Ø6 мм)',
      'parts.name.wires': 'Монтажні дроти',
      'parts.name.charger': 'Зарядний пристрій USB-C 5 В 2 А з кабелем',
      'parts.name.petg_black': 'PETG чорний',
      'parts.name.petg_white': 'PETG білий',
      'parts.name.tpu': 'TPU',
      'parts.note.devkit': 'Потрібна плата ESP32 DevKit V1 на 30 виводів саме з роз\'ємом USB-C (Type-C): проріз у корпусі намальований під USB-C. Перед замовленням звірте роз\'єм на сторінці товару.',
      'parts.note.mic': 'Потрібен круглий модуль INMP441 діаметром близько 14 мм: ложе в корпусі зроблене саме під нього. Перед замовленням звірте форму плати на сторінці товару.',
      'parts.note.amp': 'Корпус розрахований на плату 18,7 × 17,7 мм, гребінка вгору, клемник на протилежному краю. Перед замовленням звірте розмір і розташування виводів зі сторінкою товару.',
      'parts.note.speaker': 'Корпус підігнано під цей динамік: квадратний фланець 78 мм, магніт Ø60 мм.',
      'parts.note.filament': 'Потрібні дві нитки Ø1,5 мм у такому варіанті: 3 В, близько 185 мм, 100 мА. Колір світіння — на ваш смак. Резистор 47 Ом від 5 В розраховано саме на нитку на 3 В, тож звірте варіант на сторінці товару.',
      'parts.note.res47': 'Три штуки: по одному на кожну нитку й один на затворі транзистора.',
      'parts.note.inserts': 'Потрібно 11 вставок M2.5 (довжина 4 мм, Ø3,5 мм): 3 у тіло, 2 у стійки тіла, 4 у верх, 2 у лоток. Вплавляються звичайним жалом паяльника. За посиланням продається набір M2–M5 на 220 шт., з нього знадобляться лише M2.5.',
      'parts.note.screws': 'Потрібно 11 гвинтів: 3 для лотка, 2 для верху, 4 для динаміка й 2 для DevKit. За посиланням продається набір M2 і M2.5 на 500 шт., з нього знадобляться лише M2.5×8.',
      'parts.note.washers': 'Під головки гвинтів динаміка.',
      'parts.note.wires': 'Кілька кольорів. Підійдуть і жили мережевого кабелю „кручена пара“. Довжини в таблиці розділу «Пайка».',
      'parts.note.charger': 'Кабель із передаванням даних, не лише для заряджання. Корпус штекера USB-C має бути тонким, не більше приблизно 10 × 6,2 мм, інакше він не пройде в проріз корпусу.',
      'parts.note.petg_black': 'Тіло, верх, лоток, ковпачок кнопки. Іде частина котушки.',
      'parts.note.petg_white': 'Дві дуги кільця.',
      'parts.note.tpu': 'Ніжки, дві прокладки, заглушки.',
      'tools.title': 'Інструменти',
      'tools.item.printer': '3D-принтер, що друкує PETG і TPU',
      'tools.item.iron': 'Паяльник',
      'tools.item.solder': 'Припій і флюс',
      'tools.item.insert_tip': 'Насадка до паяльника для вплавлення вставок (бажано, але можна й звичайним жалом)',
      'tools.item.multimeter': 'Мультиметр із прозвонкою',
      'tools.item.cutters': 'Бокорізи',
      'tools.item.glue_gun': 'Термоклеєвий пістолет',
      'tools.item.feet_glue': 'Суперклей або двосторонній скотч для ніжок',
      'tools.item.screwdriver': 'Хрестова викрутка для гвинтів M2.5',
      'tools.item.flat_screwdriver': 'Маленька пласка викрутка для клемника підсилювача',
      'tools.item.battery': 'Батарейка CR2032 для перевірки полярності ниток',
      'tools.item.marker': 'Маркер',
      'tools.item.tape': 'Малярний скотч',
      'cost.value': 'від {uah} ₴ без {left}',
      'cost.exact': 'близько {uah} ₴',
      'cost.left.devkit': 'плати DevKit',
      'cost.left.mic': 'мікрофона',
      'cost.left.filament': 'ниток',
      'cost.left.charger': 'зарядки',
      'cost.left.small': 'дрібниць',
      'cost.left.plastic': 'пластику',
      'cost.and': ' і ',
      'cost.and_vowel': ' й ',
      'print.title': 'Друк корпусу',
      'print.intro': 'Корпус друкується з PETG і TPU. Назва деталі — посилання на її STL-файл; у кожному файлі одна деталь, а число в назві файлу (_x2, _x4) показує, скільки копій друкувати.',
      'print.common': 'Деталі надруковано на Bambu Lab X1 Carbon (стіл 256 × 256 мм): сопло 0,4 мм, перший шар 0,2 мм, стінки Arachne. Підійде будь-який принтер, що друкує PETG і TPU.',
      'print.archive': 'Усі файли одним архівом (ZIP)',
      'print.archive_note': 'Архів збирається під час публікації сайту, тож у клонованому репозиторії його немає: там ці самі файли лежать у папці v1/case/stl.',
      'print.col.part': 'Деталь',
      'print.col.qty': 'К-сть',
      'print.name.body': 'Тіло',
      'print.name.top': 'Верх (решітка, кнопка, бобишки під гвинти)',
      'print.name.tray': 'Лоток (дно з електронікою)',
      'print.name.ring_arc': 'Дуга кільця',
      'print.name.button_cap': 'Ковпачок кнопки',
      'print.name.top_plug': 'Заглушка над гвинтом верху',
      'print.name.foot': 'Ніжка',
      'print.name.tray_gasket': 'Прокладка лотка',
      'print.name.speaker_gasket': 'Прокладка під динамік',
      'print.plastic.petg_black': 'PETG чорний',
      'print.plastic.petg_white': 'PETG білий',
      'print.plastic.tpu': 'TPU',
      'print.settings.petg': 'шар 0,16 мм, стінки 4–5, без опор, крім тіла',
      'print.settings.arc': 'шар 0,16 мм, від 2 стінок, без опор',
      'print.settings.tpu': 'шар 0,1 мм, заповнення 100 %, без опор',
      'print.note.body': 'опори лише під трьома бобишками всередині',
      'print.optional': 'не обов\'язково',
      'print.download_label': '{name}: завантажити {file}',
      'print.estimate': 'Оцінка слайсера Bambu Studio на X1 Carbon з цими налаштуваннями, без опор під трьома бобишками тіла: PETG близько 7 годин і 120 г, TPU близько пів години і 4 г. Справжній час залежить від принтера й швидкостей.',
      'print.how.title': 'Як друкувати',
      'print.how.orient': 'Усі файли вже лежать у правильному положенні, у слайсері нічого повертати не треба: дугу друкують пласким боком на столі, ковпачок кнопки догори дном, верх лицем на стіл.',
      'print.how.supports': 'Опори (підтримки) потрібні лише в тілі. У Bambu Studio намалюйте їх вручну («Paint-on supports») під трьома бобишками для гвинтів дна: це виступи на внутрішній стінці біля дна. Місця, які принтер перекриває «мостами», підпирати не треба.',
      'print.how.layer': 'PETG-деталі друкуйте шаром 0,16 мм: висоту дуг кільця підігнано під тіло, надруковане таким шаром. З тоншим шаром (наприклад, 0,12 мм) дуги вийдуть нижчими за перемички на 0,04 мм: верх ляже на перемички, а дуги матимуть люфт.',
      'print.how.walls': 'Arachne — режим генерації стінок у Bambu Studio, у стандартному профілі стоїть Classic. Для дуги перемкніть на Arachne: стінка перед ниткою лише 0,6 мм, і слайсер має покласти її однією-двома лініями.',
      'print.how.tpu': 'TPU-деталі друкуйте шаром 0,1 мм із заповненням 100 %: основа прокладки лотка завтовшки 0,3 мм виходить рівно у два шари.',
      'solder.title': 'Пайка',
      'solder.intro': 'Мікрофон, підсилювач із конденсатором, джгут транзистора з нитками кільця й кнопку паяють на столі, лишаючи другі кінці дротів вільними, а дроти на DevKit паяють уже на етапі 4 збирання, коли плати лежать у лотку.',
      'assembly.title': 'Збирання',
      'firmware.title': 'Прошивка',
      'server.title': 'Сервер',
      'trouble.title': 'Якщо щось не так',
      'firmware.intro': 'Кнопка нижче записує прошивку в колонку прямо з браузера через кабель USB, а в тому ж вікні ви передаєте колонці назву й пароль своєї мережі Wi-Fi.',
      'firmware.button': 'Встановити прошивку',
      'firmware.unsupported': 'Цей браузер не вміє працювати з USB-портами, тож встановити прошивку з нього не вийде. Відкрийте цю сторінку в Chrome або Edge на комп\'ютері.',
      'firmware.not_allowed': 'Браузер дозволяє встановлювати прошивку лише зі сторінки, адреса якої починається з https://, або з localhost. Відкрийте цю сторінку за такою адресою.',
      'firmware.load_failed': 'Не вдалося завантажити кнопку встановлення: вона приходить із сайту unpkg.com. Перевірте, чи є з\'єднання з інтернетом і чи не блокує цей сайт розширення браузера, а потім оновіть сторінку.',
      'firmware.need.title': 'Що потрібно',
      'firmware.need.browser': 'Комп\'ютер (Windows, macOS чи Linux) із браузером Chrome або Edge.',
      'firmware.need.cable': 'Кабель USB-C, що передає дані: кабель лише для заряджання не підійде.',
      'firmware.need.wifi': 'Мережа Wi-Fi на 2,4 ГГц: мереж на 5 ГГц плата не бачить.',
      'firmware.need.driver': 'На Windows, можливо, знадобиться драйвер для USB-чипа плати DevKit: CH340 або CP210x, залежно від плати. Якщо не знаєте, який чип на вашій, встановіть обидва.',
      'firmware.need.ch340': 'Драйвер CH340 (сайт WCH)',
      'firmware.need.cp210x': 'Драйвер CP210x (сайт Silicon Labs)',
      'firmware.steps.title': 'Як встановити',
      'firmware.step1': 'Під\'єднайте колонку до комп\'ютера кабелем USB-C: роз\'єм ззаду корпусу. Колонка живиться від цього ж кабелю, окремий блок живлення не потрібен.',
      'firmware.step2': 'Натисніть «Встановити прошивку». Браузер покаже список портів: виберіть той, що з\'явився після під\'єднання колонки, і підтвердіть вибір.',
      'firmware.step3': 'Відкриється англомовне вікно встановлення. Натисніть у ньому «Install Pytaichenko.Speaker», поставте галочку «Erase device», щоб стерти з плати старі дані, і натисніть «Next», а потім «Install».',
      'firmware.step4': 'Дочекайтеся кінця запису: це триває близько двох хвилин. Тим часом не закривайте сторінку й не перемикайтеся на іншу вкладку. Коли з\'явиться «Installation complete!», натисніть «Next».',
      'firmware.step5': 'У вікні «Configure Wi-Fi» виберіть свою мережу в списку «Network», впишіть пароль у поле «Password» і натисніть «Connect». Якщо мережі немає в списку, виберіть «Join other…» і впишіть її назву. Коли з\'явиться «Device connected to the network!», натисніть «Continue» і закрийте вікно. Якщо замість цього вікна відкрилося меню, виберіть у ньому «Connect to Wi-Fi». Якщо такого пункту в меню немає, закрийте вікно, натисніть «Встановити прошивку» ще раз і виберіть порт: тепер він з\'явиться.',
      'firmware.next.title': 'Що далі',
      'firmware.next.ring': 'Поки колонка не з\'єднана із сервером, кільце повільно «дихає»: розгоряється й гасне раз на 4 с. Так і має бути: колонка працює й чекає на сервер.',
      'firmware.next.server': 'З\'єднайте колонку із сервером одразу після прошивки, як описано в розділі «Сервер»: доти колонка не має власного ключа шифрування, і під\'єднатися до неї може будь-який пристрій у вашій мережі.',
      'firmware.next.window': 'Перше з\'єднання із сервером колонка приймає протягом доби після ввімкнення. Якщо доба минула, а колонку ще не з\'єднано, від\'єднайте її від живлення й під\'єднайте знову. Уже з\'єднана колонка, яка цілу добу після ввімкнення не могла під\'єднатися до Wi-Fi, перезапускається сама.',
      'firmware.update.title': 'Оновлення прошивки',
      'firmware.update.text': 'Нову версію ставлять тією ж кнопкою «Встановити прошивку»: під\'єднайте колонку кабелем, натисніть кнопку й виберіть порт. У вікні натисніть «Update Pytaichenko.Speaker», а потім «Install». Коли з\'явиться «Installation complete!», натисніть «Next» і закрийте вікно. Колонка збереже ключ сервера, мережу Wi-Fi, вибрану фразу й гучність.',
      'firmware.update.erase': 'Якщо замість «Update Pytaichenko.Speaker» у вікні є лише «Install Pytaichenko.Speaker» і далі воно питає про «Erase device», галочку не ставте: стирання видаляє ключ сервера, Wi-Fi і фразу. Якщо немає жодного з цих пунктів, на колонці вже ця версія й оновлювати нічого не треба: просто закрийте вікно. Червоний пункт «Erase User Data» тоді не натискайте, якщо не хочете з\'єднувати колонку із сервером заново: він стирає ключ, Wi-Fi і фразу, а наступне вікно має лише кнопку підтвердження.',
      'firmware.trouble.title': 'Якщо не вийшло',
      'firmware.trouble.port.symptom': 'Колонки немає в списку портів',
      'firmware.trouble.port.fix': 'Спробуйте інший кабель: чимало кабелів USB-C лише заряджають і не передають даних. На Windows встановіть драйвер CH340 або CP210x з посилань вище, а потім від\'єднайте й знову під\'єднайте колонку. На Linux, якщо порт у списку є, але не відкривається, додайте свого користувача до групи dialout командою нижче, а потім вийдіть із системи й увійдіть знову.',
      'firmware.trouble.boot.symptom': 'Встановлення зависає на «Preparing installation» або пише «Failed to initialize»',
      'firmware.trouble.boot.fix': 'Деякі плати DevKit не переходять у режим запису самі, і тоді допомагає кнопка BOOT біля роз\'єму USB-C на платі. Від\'єднайте кабель, відкрутіть три гвинти лотка й вийміть лоток із корпусу, не від\'єднуючи дротів. DevKit лежить у лотку деталями донизу, тож кнопка BOOT на нижньому боці плати: відкрутіть два гвинти біля антени й обережно підніміть плату із защіпок. Під\'єднайте кабель просто до DevKit, тримайте кнопку BOOT натиснутою, коли натискаєте «Install», і відпустіть її, коли з\'явиться відсоток запису. Потім поверніть плату й лоток на місце.',
      'firmware.trouble.wifi.symptom': 'Треба змінити мережу Wi-Fi або пароль',
      'firmware.trouble.wifi.fix': 'Прошивку вдруге записувати не треба. Під\'єднайте колонку кабелем, натисніть «Встановити прошивку», виберіть порт, а у вікні виберіть «Change Wi-Fi» (або «Connect to Wi-Fi», якщо колонка зараз не в мережі).',
      'server.intro': 'Сервер — це служба розмови на комп\'ютері у вашій домашній мережі: колонка надсилає їй ваше питання, а служба розмовляє з OpenAI й повертає колонці відповідь голосом.',
      'server.need.title': 'Що потрібно',
      'server.need.computer': 'Комп\'ютер на Linux, що працює постійно, у тій самій мережі, що й колонки: міні-ПК, Raspberry Pi 4 чи 5 із 64-бітною системою або NAS, який уміє запускати Docker.',
      'server.need.docker': 'Docker із Docker Compose і git на цьому комп\'ютері.',
      'server.need.key': 'Ключ API OpenAI. Розмови оплачуються окремо, за тарифами OpenAI.',
      'server.need.key_link': 'Ключі API на сайті OpenAI',
      'server.run.title': 'Як запустити',
      'server.run.text': 'На сервері відкрийте термінал і виконайте три команди: перша завантажує проєкт, друга переходить у його папку, третя збирає й запускає службу.',
      'server.run.perm': 'Якщо Docker відповідає «permission denied», вашого користувача ще немає в групі docker: додайте його командою нижче, вийдіть із системи, увійдіть знову й повторіть три команди. Або виконайте ці команди з sudo.',
      'server.run.after': 'Перший запуск триває кілька хвилин, поки Docker збирає службу. Далі вона запускається сама разом із комп\'ютером, а все, що ви налаштуєте, зберігається в папці data всередині папки проєкту.',
      'server.setup.title': 'Як налаштувати',
      'server.setup.open': 'На будь-якому пристрої у вашій мережі відкрийте в браузері сторінку налаштувань за адресою нижче. Адресу сервера видно в налаштуваннях роутера, у списку пристроїв.',
      'server.setup.address': 'адреса сервера',
      'server.setup.password': 'Сторінка попросить створити пароль: придумайте його, впишіть двічі й натисніть «Створити пароль». Далі налаштування відкриваються лише з цим паролем.',
      'server.setup.key': 'У розділі «Розмова» вставте ключ у поле «Ключ OpenAI» і натисніть «Зберегти». Ключ зберігається лише на сервері, і сторінка його назад не показує.',
      'server.setup.adopt': 'Одразу після прошивки відкрийте розділ «Колонки»: увімкнена колонка приблизно за хвилину з\'явиться в списку «Знайдено в мережі». Натисніть «Забрати»: сервер видасть колонці її власний ключ шифрування й під\'єднається до неї. Коли колонка на зв\'язку, кільце гасне й колонка чекає ключову фразу.',
      'server.setup.wake': 'У картці колонки оберіть фразу в полі «Ключова фраза»: Hey Jarvis, Okay Nabu або Hey Mycroft. Колонка запам\'ятовує вибір і одразу слухає нову фразу.',
      'server.setup.language': 'Асистент слухає й відповідає мовою, якою була сторінка налаштувань, коли ви створили пароль. Щоб обрати іншу, у розділі «Розмова» змініть поле «Мова розмови» й натисніть «Зберегти» в тому ж блоці. Після цього колонка готова до розмови.',
      'server.first.title': 'Перша розмова',
      'server.first.say': 'Скажіть обрану ключову фразу або коротко натисніть кнопку зверху. Колонка подасть м\'який сигнал із двох нот угору, а кільце засвітиться повністю: вона вас слухає.',
      'server.first.ask': 'Почніть говорити трохи після сигналу й задайте питання вголос. Коли ви замовкли, кільце «дихає», то яскравіше, то тьмяніше: колонка думає. Коли вона відповідає, кільце світиться трохи тьмяніше, ніж під час слухання.',
      'server.first.more': 'Після відповіді кілька секунд можна питати далі без ключової фрази: кільце тоді світиться слабко.',
      'server.first.stop': 'Щоб завершити, скажіть «Дякую, все»: прозвучить сигнал із двох нот униз, і кільце згасне. Кнопка зверху так само зупиняє розмову, коли колонка слухає чи відповідає, а коли колонка мовчить, кнопка її починає.',
      'server.first.ring.caption': 'Що показує кільце',
      'server.first.col.ring': 'Кільце',
      'server.first.col.meaning': 'Що це означає',
      'server.first.r1.look': 'повільно «дихає», раз на 4 с',
      'server.first.r1.mean': 'сервер не під\'єднаний до колонки: див. «Якщо не вийшло» нижче',
      'server.first.r2.look': 'не світиться',
      'server.first.r2.mean': 'колонка чекає ключову фразу',
      'server.first.r3.look': 'світиться повністю',
      'server.first.r3.mean': 'колонка вас слухає',
      'server.first.r4.look': '«дихає» швидше й яскравіше',
      'server.first.r4.mean': 'колонка думає над відповіддю',
      'server.first.r5.look': 'світиться трохи тьмяніше',
      'server.first.r5.mean': 'колонка відповідає',
      'server.first.r6.look': 'світиться слабко',
      'server.first.r6.mean': 'колонка чекає продовження без ключової фрази',
      'server.first.r7.look': 'три м\'які спалахи',
      'server.first.r7.mean': 'сталася помилка; за мить колонка знову чекає ключову фразу',
      'server.update.title': 'Оновлення сервера',
      'server.update.text': 'Щоб поставити нову версію сервера, у папці проєкту виконайте команду нижче: вона завантажить зміни, збере службу заново й перезапустить її. Усе, що ви налаштували, лишається в папці data.',
      'server.env.title': 'Змінні середовища',
      'server.env.text': 'Усі вони необов\'язкові. Їх пишуть у файл .env у папці проєкту, кожну окремим рядком у вигляді НАЗВА=значення. Значення, у якому є $, #, пробіли чи лапки, беріть в одинарні лапки; самої одинарної лапки в ньому бути не може.',
      'server.env.key': 'Ключ OpenAI лише для першого запуску; далі його міняють на сторінці налаштувань.',
      'server.env.password': 'Пароль сторінки налаштувань. Тоді сторінка не просить створити пароль, а змінити його можна лише цією змінною; так само відновлюють доступ, якщо пароль забули. Мова розмови тоді спершу українська, іншу обирають у розділі «Розмова».',
      'server.env.hosts': 'Інші імена, за якими відкривають сторінку налаштувань, через кому; див. «Якщо не вийшло».',
      'server.env.port': 'Інший порт сторінки й звуку, від 1024 до 65535, коли 8080 зайнятий; він має перевагу над портом зі сторінки налаштувань.',
      'server.env.restart': 'Після зміни файлу .env перезапустіть службу командою нижче.',
      'server.trouble.title': 'Якщо не вийшло',
      'server.trouble.found.symptom': 'Колонки немає в списку «Знайдено в мережі»',
      'server.trouble.found.fix': 'Додайте її за адресою. Знайдіть колонку в налаштуваннях роутера, у списку пристроїв: її ім\'я починається з pytaichenko. На сторінці налаштувань у блоці «Додати вручну» впишіть цю адресу в поле «Адреса колонки», поле ключа залиште порожнім і натисніть «Додати».',
      'server.trouble.desktop.symptom': 'Сервер працює в Docker Desktop на macOS чи Windows',
      'server.trouble.desktop.fix': 'Сервер розраховано на мережу хоста (host), а Docker Desktop її повноцінно не підтримує: сторінка може не відкритися, а пошук колонок може не спрацювати. Щоб запустити сервер без неї, створіть у папці проєкту файл compose.override.yaml із текстом нижче (сам compose.yaml не міняйте) і знову запустіть службу.',
      'server.trouble.desktop.after': 'Далі на сторінці налаштувань у розділі «Доступ» впишіть у поле «Адреса сервера для колонок» адресу комп\'ютера в домашній мережі, лише ім\'я або IP без http:// і порту, натисніть «Зберегти» й перезапустіть службу командою нижче. Колонку тоді додають вручну за адресою, як описано вище. Порт у такому режимі міняють лише рядком VOICE_HUB_PORT у файлі .env, а не на сторінці.',
      'server.trouble.hosts.symptom': 'Сторінка пише «Сервер не приймає цю адресу»',
      'server.trouble.hosts.fix': 'Сторінка налаштувань відкривається лише за IP-адресою сервера або за домашнім ім\'ям, наприклад із закінченням .local чи .lan. Щоб відкривати її за іншим ім\'ям, наприклад за власним доменом, допишіть це ім\'я у файл .env у папці проєкту й перезапустіть службу командами нижче. Кілька імен пишуть в одному рядку через кому, тож якщо рядок VOICE_HUB_HOSTS у .env уже є, допишіть нове ім\'я в нього, а не додавайте ще один.',
      'server.trouble.port.symptom': 'Служба не запускається, бо порт 8080 зайнятий',
      'server.trouble.port.fix': 'Оберіть інший порт: впишіть його в рядок VOICE_HUB_PORT у файлі .env у папці проєкту (від 1024 до 65535) і перезапустіть службу командами нижче. Порт із .env має перевагу над портом, збереженим на сторінці налаштувань, а сторінка далі відкривається за новим портом. Якщо рядок VOICE_HUB_PORT у .env уже є, змініть його, а не додавайте ще один.',
      'server.trouble.firewall.symptom': 'Сторінка налаштувань відкривається на самому сервері, а з інших пристроїв ні, або колонка вас чує й кільце «дихає», але відповіді не чути',
      'server.trouble.firewall.fix': 'Найімовірніше, брандмауер сервера не пускає до порту служби: за замовчуванням це 8080 (TCP), а якщо ви задали VOICE_HUB_PORT, то ваш порт. Через цей порт відкривається сторінка налаштувань, і через нього ж колонка бере звук відповіді. Дозвольте цей порт для домашньої мережі: нижче спершу команда для ufw, а потім дві команди для firewalld. У них замініть 192.168.1.0/24 на адреси вашої мережі, а 8080 — на ваш порт, якщо він інший. Не відкривайте порт для всього інтернету.',
      'server.trouble.ring.symptom': 'Кільце й далі повільно «дихає» раз на 4 с',
      'server.trouble.ring.fix': 'Так колонка показує, що сервер до неї не під\'єднаний. Перевірте, що колонку забрано і вона є в розділі «Колонки», що сервер і колонка в одній мережі (а не, наприклад, колонка в гостьовій мережі Wi-Fi) і що служба працює: у папці проєкту її стан показує команда нижче. Якщо роутер видав колонці нову адресу, змініть її кнопкою «Змінити адресу» в картці колонки.',
      'server.trouble.removed.symptom': 'Колонку прибрали, а тепер її треба додати знову',
      'server.trouble.removed.fix': 'Прибираючи колонку, сервер забуває її ключ, а колонка свій ключ пам\'ятає, тож забрати її вдруге не вийде. Зітріть колонку тією ж кнопкою, що в розділі «Прошивка»: під\'єднайте її кабелем, натисніть «Встановити прошивку» й виберіть порт. У вікні натисніть червоний пункт «Erase User Data» і підтвердіть кнопкою «Erase User Data». Якщо такого пункту немає, а є «Update Pytaichenko.Speaker», спершу оновіть прошивку: «Update Pytaichenko.Speaker», потім «Install», а коли запис закінчиться, «Next»; тоді «Erase User Data» з\'явиться в тому ж вікні. Якщо є лише «Install Pytaichenko.Speaker», натисніть його, поставте галочку «Erase device» і натисніть «Next», а потім «Install». Після стирання вікно попросить мережу Wi-Fi, як під час першого встановлення, а колонка знову з\'явиться в списку «Знайдено в мережі», і її можна забрати.',
      'trouble.mic.symptom': 'Перше слово після сигналу «слухаю» обрізається',
      'trouble.mic.fix': 'Мікрофон на старті щоразу дає короткий удар, тож служба розмови відкидає перші 0,4 с звуку, і слово, сказане в ту саму мить, губиться. Це не поломка: почніть говорити трохи після сигналу «слухаю».',
      'trouble.wake.symptom': 'Ключова фраза іноді не спрацьовує з першого разу',
      'trouble.wake.fix': 'Скажіть її ще раз: трохи ближче до колонки й чіткіше. Розмову можна почати й кнопкою зверху.',
      'trouble.volume.symptom': 'Звук занадто гучний або занадто тихий',
      'trouble.volume.fix': 'Нова колонка починається з гучності 70 %. Скажіть «гучніше» або «тихіше»: кожне слово змінює гучність на 15 %; точний рівень теж можна назвати, наприклад «гучність 80 відсотків». Шкала гучності лінійна в децибелах (дБ), тож навіть невеликий крок добре чутно, а зручний рівень залежить від динаміка й корпусу: підберіть його на слух.',
      'trouble.capacitor.symptom': 'Конденсатор біля підсилювача гріється',
      'trouble.capacitor.fix': 'Вимкніть живлення й гляньте на смужку з мінусами («−») на корпусі конденсатора: вона має бути з боку GND, а довга ніжка «+» на VIN. Якщо конденсатор увімкнено навпаки, перепаяйте його правильно; якщо він здувся чи потік, замініть його.',
      'trouble.button.symptom': 'Перемикач кнопки вискакує з верху, коли сильно натиснути',
      'trouble.button.fix': 'Без клею його тримають лише гачки, тож при сильному натиску він виходить. Приклейте перемикач краплею термоклею з двох боків, як у кроці збирання верху; клей не має потрапити на штовхач і в щілину ковпачка.',
      'trouble.arc.symptom': 'Над перемичками тіла видно щілину, або дуги кільця деренчать',
      'trouble.arc.fix': 'Дуги підігнано під тіло, надруковане шаром 0,16 мм: верх притискає дуги, і ледь помітна щілина над перемичками, до 0,04 мм, це нормально. Дуги, надруковані тоншим шаром (наприклад, 0,12 мм), виходять нижчими за перемички на 0,04 мм: верх лягає на перемички, а дуги можуть деренчати, тож передрукуйте їх шаром 0,16 мм.',

      'solder.ring.title': 'Транзистор кільця',
      'solder.button.title': 'Кнопка зверху',
      'solder.capacitor.title': 'Підсилювач і конденсатор',
      'solder.mic.title': 'Мікрофон',
      'solder.devkit.title': 'Дроти на DevKit (етап 4 збирання)',
      'solder.pinmap.title': 'Карта штирів DevKit',
      'solder.wires.title': 'Довжини дротів',

      'steps.prev': 'Назад',
      'steps.next': 'Далі',
      'steps.restart': 'Спочатку',
      'steps.count': 'Крок {n} з {m}',
      'steps.scroll_hint': 'Малюнок гортається вбік →',

      'steps.ring.alt': 'Покрокова пайка транзистора й ниток кільця: полярність ниток батарейкою CR2032, ніжки G, D, S, резистори 6,2 кОм і 47 Ом, дроти на D4, GND і VIN плати ESP32, сині дроти до контактів «−» і червоні з резисторами 47 Ом до контактів «+» обох ниток.',
      'steps.ring.1': 'Спершу знайдіть «+» кожної нитки: притисніть її кінці до двох боків батарейки CR2032. Нитка світиться лише в одному положенні, і кінець, що торкається «+» батарейки, позначте маркером «+».',
      'steps.ring.2': 'Візьміть транзистор написом до себе, ніжками донизу. Зліва направо: G, D, S.',
      'steps.ring.3': 'Між ніжками G і S припаяйте резистор 6,2 кОм. Мультиметр на ньому має показати близько 6,2 кОм.',
      'steps.ring.4': 'На кінець ніжки G припаяйте резистор 47 Ом (мультиметр: близько 47 Ом).',
      'steps.ring.5': 'Від вільного кінця цього резистора жовтий дріт іде на штир з написом D4 на платі ESP32.',
      'steps.ring.6': 'Від ніжки S сірий дріт іде на штир GND на платі ESP32 (будь-який з двох GND).',
      'steps.ring.7': 'До середньої ніжки D припаяйте два сині дроти, а їхні другі кінці — до контактів «−» обох ниток. Паяйте лише до металевого контакту 5 мм на кінці нитки, ніколи до світної частини, і швидко, бо нитка не любить нагрівання.',
      'steps.ring.8': 'У кожен із двох червоних дротів «+» впаяйте свій резистор 47 Ом і так само, швидко й лише до металу, припаяйте один кінець дроту до позначеного контакту «+» своєї нитки. Другі кінці обох червоних дротів разом підуть на штир VIN на платі ESP32 на етапі 4 збирання.',
      'steps.ring.9': 'Металева пластина транзистора з\'єднана з D, тож вона не має торкатися інших пайок і ніжок.',
      'steps.ring.res_gs': '6,2 кОм',
      'steps.ring.res_47': '47 Ом',
      'steps.ring.fil1': 'нитка 1',
      'steps.ring.fil2': 'нитка 2',
      'steps.ring.each_47': 'по 47 Ом',
      'steps.ring.tab': 'пластина з\'єднана з D',
      'steps.ring.battery': 'CR2032, «+» зверху',
      'steps.ring.lights': 'світиться лише так',
      'steps.ring.mark_plus': 'позначте «+» маркером',

      'steps.button.alt': 'Покрокова пайка кнопки 12 на 12: знайти внутрішні ніжки, перевірити мультиметром, обрізати зовнішні, припаяти дроти на D19 і GND плати ESP32.',
      'steps.button.1': 'Кнопка 12 × 12, вигляд згори. З двох боків по дві ніжки, 5 мм одна від одної. Внутрішні ніжки з того боку, що в корпусі буде ближче до центру.',
      'steps.button.2': 'Перевірка: мультиметр у режимі прозвонки на дві внутрішні ніжки. Не натиснуто — тиша, натиснули — пищить. Якщо пищить завжди або не пищить ніколи, нічого не обрізайте: знайдіть мультиметром пару ніжок, яка замикається лише під час натискання, і далі працюйте з нею.',
      'steps.button.3': 'Кусачками обріжте дві ніжки, які не входять до цієї пари, до 0,5 мм або коротше. Зазвичай це зовнішні ніжки, як на малюнку. Пара, що замикається, лишається цілою. Якщо замикається пара зовнішніх ніжок, нічого не обрізайте: розверніть перемикач на 180°, щоб ці ніжки стали внутрішніми, і перевірте ще раз. Якщо замикаються внутрішня й зовнішня ніжки, обріжте дві інші, а зовнішню ніжку з пари вкоротіть, наскільки дозволяє пайка: поруч металевий край фланця (крок 6).',
      'steps.button.4': 'До однієї ніжки з пари, що замикається (зазвичай внутрішньої), припаяйте жовтий дріт, він іде на штир D19 на платі ESP32.',
      'steps.button.5': 'До другої ніжки цієї пари припаяйте сірий дріт на штир GND на платі ESP32. Яку ніжку куди, неважливо.',
      'steps.button.6': 'Пайку тримайте маленькою й плоскою, а дроти відводьте вбік: у корпусі поруч із ніжками, лише за 1,15 мм, буде металевий край фланця динаміка.',
      'steps.button.outer': 'зовнішні',
      'steps.button.outer_note': '(до стінки)',
      'steps.button.inner': 'внутрішні',
      'steps.button.inner_note': '(до центру)',
      'steps.button.centre': 'центр корпусу',
      'steps.button.press': 'натисніть',
      'steps.button.beep': 'пік',
      'steps.button.cut': 'різати тут',
      'steps.button.flange': 'край фланця динаміка: 1,15 мм',

      'steps.capacitor.alt': 'Покрокова пайка підсилювача MAX98357A: гребінка й клемник, пропаяні знизу, хвости врівень з платою, конденсатор 1000 мкФ на штирі VIN і GND, дроти до кінчиків штирів і перевірка мультиметром.',
      'steps.capacitor.1': 'Семипінову гребінку вставте з верхнього боку вздовж краю з написами LRC … VIN: чорний пластик лежить на платі, довгі штирі дивляться вгору. Пропаяйте кожен штир знизу.',
      'steps.capacitor.2': 'Гвинтовий клемник поставте на той самий верхній бік уздовж протилежного краю, отворами для дротів назовні, і так само пропаяйте його знизу.',
      'steps.capacitor.3': 'Бокорізами зріжте хвости штирів і клемника під платою врівень з нею: у лотку плата має лягти у своє ложе рівно.',
      'steps.capacitor.4': 'Підсилювач лежить штирями вгору. За написами на платі знайдіть GND і VIN: вони поруч, на одному кінці гребінки.',
      'steps.capacitor.5': 'Конденсатор 1000 мкФ. Довга ніжка — «+». Коротка ніжка з боку світлої смужки з мінусами — «−».',
      'steps.capacitor.6': 'Довгу ніжку «+» припаяйте до VIN, коротку «−» до GND, ближче до основи штирів: кінчики лишаються для дротів на DevKit. Не переплутайте: перевернутий конденсатор гріється й може луснути.',
      'steps.capacitor.7': 'Ніжки загніть так, щоб вони не торкалися одна одної. Конденсатор лягає набік поруч із підсилювачем і тримається на ніжках, не вище кінчиків штирів. Клей не потрібен.',
      'steps.capacitor.8': 'До кінчиків штирів LRC, BCLK, DIN, GND і VIN припаяйте по дроту й одразу відведіть його вбік, довжини вказано на малюнку. Другі кінці лишаються вільними до етапу 4 збирання.',
      'steps.capacitor.9': 'Перевірка: прозвонка на VIN і GND. Має бути тиша; короткий писк на самому початку — теж нормально, так заряджається конденсатор. Безперервний писк означає замикання.',
      'steps.capacitor.to_speaker': 'до динаміка',
      'steps.capacitor.stripe': '−  −  −  −',
      'steps.capacitor.value': '1000 мкФ',
      'steps.capacitor.stripe_note': 'смужка = «−», коротка ніжка',
      'steps.capacitor.long_leg': 'довга ніжка = «+»',
      'steps.capacitor.on_side': 'лежить на боці, не вище штирів',
      'steps.capacitor.silence': 'тиша',
      'steps.capacitor.beep_ok': 'короткий пік на початку — теж норма',
      'steps.capacitor.side': 'підсилювач збоку',
      'steps.capacitor.labels_edge': 'край з написами LRC … VIN',
      'steps.capacitor.header': 'гребінка: пластик зверху, довгі штирі вгору',
      'steps.capacitor.solder_below': 'пайка знизу',
      'steps.capacitor.terminal': 'клемник: той самий бік, отвори назовні',
      'steps.capacitor.trim': 'хвости врівень з платою',
      'steps.capacitor.w_lrc': 'LRC · 7 см',
      'steps.capacitor.w_bclk': 'BCLK · 7 см',
      'steps.capacitor.w_din': 'DIN · 3,5 см',
      'steps.capacitor.w_gnd': 'GND · 7 см',
      'steps.capacitor.w_vin': 'VIN · 8 см',

      'steps.mic.alt': 'Покрокова пайка мікрофона INMP441: дротик L/R–GND, дроти VDD, GND, SD, WS і SCK з боку чипа, хвости зрізані з боку отвору для звуку.',
      'steps.mic.1': 'Плата INMP441 без впаяних штирів, вигляд з боку чипа: дроти паяються прямо на її шість контактів. Другий бік з отвором для звуку лишається рівним, бо піде до стінки корпусу.',
      'steps.mic.2': 'Спершу коротким відрізком дроту з\'єднайте L/R із GND з боку чипа: GND стоїть навпроти L/R, в іншому ряду. Не робіть цього краплею припою на боці з отвором: той бік має лишитися рівним.',
      'steps.mic.3': 'Припаяйте GND і VDD: вставте кінець дроту в отвір контакту з боку чипа й паяйте з цього ж боку. Довжини вказано на малюнку й у таблиці нижче.',
      'steps.mic.4': 'Так само припаяйте SD, WS і SCK. Кольори на малюнку умовні, головне не переплутати контакти.',
      'steps.mic.5': 'Переверніть плату й на боці з отвором зріжте виступи дротів врівень з платою. Нічим не тицяйте в отвір: під ним мембрана.',
      'steps.mic.chip': 'чип',
      'steps.mic.side_chip': 'з боку чипа',
      'steps.mic.order_note': 'так на поширеній платі; паяйте за написами на своїй',
      'steps.mic.jumper': 'дротик L/R — GND',
      'steps.mic.w_vdd': 'VDD · 11 см',
      'steps.mic.w_gnd': 'GND · 11,5 см',
      'steps.mic.w_sd': 'SD · 6,5 см',
      'steps.mic.w_ws': 'WS · 8 см',
      'steps.mic.w_sck': 'SCK · 6 см',
      'steps.mic.flip': 'переверніть',
      'steps.mic.flat_title': 'бік з отвором',
      'steps.mic.flat_hole': 'отвір для звуку',
      'steps.mic.flat_trim': 'хвости врівень з платою',
      'steps.mic.flat_poke': 'не тицяти в отвір',
      'steps.devkit.alt': 'Покрокові дроти на DevKit на етапі 4 збирання: паяти до кінчиків штирів, ще до лотка знайти потрібні штирі за написами й позначити їх маркером на гребінці з протилежного боку плати, плата в лотку штирями вгору, дроти підсилювача, мікрофона, кільця й кнопки, прозвонка VIN–GND і 3V3–GND.',
      'steps.devkit.1': 'Ці дроти паяють на етапі 4 збирання, коли DevKit і підсилювач уже в лотку: паяйте до кінчика штиря й відразу відводьте дріт убік, бо над кінчиками до дна динаміка лише 5 мм. Пайку тримайте маленькою.',
      'steps.devkit.2': 'Ще до лотка. Написи й модуль ESP32 лежать з одного боку плати, а чорна пластмасова гребінка штирів — з іншого. Знайдіть за написами дванадцять потрібних штирів: D4, D19, D22, D25, D26, D27, D32, D33, VIN, 3V3 і обидва GND. Переверніть плату гребінкою догори, антеною до себе, і маркером позначте ці самі штирі на чорній гребінці: ряд з D22, D4, D19 і 3V3 лишається праворуч, але порядок штирів у кожному ряду тепер іде з іншого кінця: VIN і 3V3 найдалі від вас, біля USB-C. Біля кожної позначки коротко підпишіть штир.',
      'steps.devkit.3': 'У лотку плата лежить штирями вгору, антеною до вас, USB-C ззаду. Написів не видно, тож працюйте за позначками: ряд з D22, D4, D19 і 3V3 з боку підсилювача, ряд з D26, D27 і VIN з боку транзистора.',
      'steps.devkit.4': 'Дроти підсилювача: DIN на D22, BCLK на D26, LRC на D27, GND і VIN на свої штирі. Довжини вказано біля кожного дроту.',
      'steps.devkit.5': 'Дроти мікрофона: VDD на 3V3, GND на штир GND поруч із 3V3, SD на D33, WS на D25, SCK на D32.',
      'steps.devkit.6': 'Дроти кільця: G (через резистор 47 Ом) на D4, S на GND (будь-який із двох), обидва «+» ниток (кожен через свій резистор 47 Ом) на VIN. Довжини «+» орієнтовні.',
      'steps.devkit.7': 'Дроти кнопки: одна ніжка на D19, друга на GND.',
      'steps.devkit.8': 'Перевірка без живлення, USB не підключайте: прозвонка між VIN і GND. Має бути тиша; короткий писк на самому початку — теж нормально, так заряджається конденсатор. Безперервний писк означає замикання.',
      'steps.devkit.9': 'Прозвонка між 3V3 і GND: має бути тиша. Якщо пищить, шукайте замикання між цими штирями.',
      'steps.devkit.board': 'ESP32 DevKit',
      'steps.devkit.t_antenna': 'антена',
      'steps.devkit.t_usb': 'USB-C',
      'steps.devkit.t_marker': 'позначка маркером',
      'steps.devkit.t_labels_up': 'написами догори',
      'steps.devkit.t_header_up': 'гребінкою догори',
      'steps.devkit.t_flip': 'переверніть',
      'steps.devkit.t_usb_back': 'USB-C, ззаду',
      'steps.devkit.t_antenna_front': 'антена, спереду',
      'steps.devkit.t_side_tr': 'бік транзистора',
      'steps.devkit.t_row_tr': 'ряд з D26, D27, VIN',
      'steps.devkit.t_side_amp': 'бік підсилювача',
      'steps.devkit.t_row_amp': 'ряд з D22, D4, D19, 3V3',
      'steps.devkit.t_speaker': 'дно динаміка',
      'steps.devkit.t_gap': 'лише 5 мм',
      'steps.devkit.t_tip': 'пайка на кінчику штиря',
      'steps.devkit.t_wire': 'дріт одразу вбік',
      'steps.devkit.t_wrong': 'не вгору: дріт упреться в динамік',
      'steps.devkit.t_board': 'плата, написами вниз',
      'steps.devkit.t_tray': 'лоток',
      'steps.devkit.w_amp_din': 'підсилювач DIN · 3,5 см',
      'steps.devkit.w_amp_bclk': 'підсилювач BCLK · 7 см',
      'steps.devkit.w_amp_lrc': 'підсилювач LRC · 7 см',
      'steps.devkit.w_amp_gnd': 'підсилювач GND · 7 см',
      'steps.devkit.w_amp_vin': 'підсилювач VIN · 8 см',
      'steps.devkit.w_mic_vdd': 'мікрофон VDD · 11 см',
      'steps.devkit.w_mic_gnd': 'мікрофон GND · 11,5 см',
      'steps.devkit.w_mic_sd': 'мікрофон SD · 6,5 см',
      'steps.devkit.w_mic_ws': 'мікрофон WS · 8 см',
      'steps.devkit.w_mic_sck': 'мікрофон SCK · 6 см',
      'steps.devkit.w_ring_g': 'кільце G (47 Ом) · 7 см',
      'steps.devkit.w_ring_s': 'кільце S · 8 см',
      'steps.devkit.w_ring_plus': 'кільце «+» ×2 · ≈9 см',
      'steps.devkit.w_btn_d19': 'кнопка, ніжка 1 · 8 см',
      'steps.devkit.w_btn_gnd': 'кнопка, ніжка 2 · 8 см',
      'steps.devkit.beep_ok': 'короткий пік на початку — теж норма',
      'steps.devkit.silence': 'тиша',

      'steps.common.irlz': 'IRLZ44N',
      'steps.common.g': 'G',
      'steps.common.d': 'D',
      'steps.common.s': 'S',
      'steps.common.d4_esp': 'D4 на ESP32',
      'steps.common.gnd_esp': 'GND на ESP32',
      'steps.common.vin_esp': 'VIN на ESP32',
      'steps.common.d19_esp': 'D19 на ESP32',
      'steps.common.minus': '−',
      'steps.common.plus': '+',
      'steps.common.max': 'MAX98357A',
      'steps.common.lrc': 'LRC',
      'steps.common.bclk': 'BCLK',
      'steps.common.din': 'DIN',
      'steps.common.gain': 'GAIN',
      'steps.common.sd': 'SD',
      'steps.common.gnd': 'GND',
      'steps.common.vin': 'VIN',
      'steps.common.vdd': 'VDD',
      'steps.common.lr': 'L/R',
      'steps.common.ws': 'WS',
      'steps.common.sck': 'SCK',

      'assembly.intro': 'Усе вже надруковане, а мікрофон, підсилювач, джгут транзистора з нитками кільця й кнопка спаяні з дротами за розділом «Пайка»; дроти на DevKit паяють на етапі 4. Малюнки — знімки 3D-моделі корпусу: деталь, яку ставлять на цьому кроці, виділено помаранчевим, решта сіра, а нитки жовті; лише на кроках, де нитка сама є новою деталлю, вона помаранчева. Деякі деталі для наочності підняті над своїм місцем. Збирання йде чотирма етапами: тіло, верх, верх на тіло й лоток.',
      'assembly.body.title': 'Тіло',
      'assembly.stage_1': 'Етап 1 з 4',
      'assembly.top.title': 'Верх',
      'assembly.stage_2': 'Етап 2 з 4',
      'assembly.join.title': 'Верх на тіло',
      'assembly.stage_3': 'Етап 3 з 4',
      'assembly.tray.title': 'Лоток',
      'assembly.stage_4': 'Етап 4 з 4',
      'steps.asm_body.1': 'Переверніть тіло відкритим низом догори й вплавте по вставці в кожну з трьох бобишок: нагрійте латунну вставку M2.5 паяльником з насадкою, поставте рівно над отвором і повільно вдавіть до рівня краю.',
      'steps.asm_body.2': 'Поставте тіло як зазвичай і так само вплавте по вставці зверху в дві стійки, праворуч і ліворуч, до рівня верху стійки.',
      'steps.asm_body.3': 'Плату мікрофона з припаяними дротами покладіть у ложе на передній стінці зсередини боком без чипа до отвору й притисніть: отвір плати має збігтися з отвором у стінці. Дроти лишіть довгими.',
      'steps.asm_body.4': 'Закріпіть плату термоклеєм лише по краю, навколо неї. Під плату й до отвору клей потрапити не має, бо закриє шлях звуку.',
      'steps.asm_body.5': 'Покладіть дугу на стіл так, як вона друкувалась, бортиком і пазом догори, і вдавіть нитку з уже припаяними дротами в паз до клацання; дроти вільно звисають з контактів, на малюнках їх показано лише з кроку 8. Нитка має виступати з обох кінців однаково: по 13 мм світної частини й по 5 мм контакту.',
      'steps.asm_body.6': 'Переверніть дугу з ниткою й поставте на обідок тіла між двома перемичками: бортик іде всередину стінки, плаский бік дивиться вгору, кінці «−» із синіми дротами біля передньої перемички, а позначені кінці «+» з червоними біля задньої. До етапу 3 дуги лише лежать на обідку, тож не штовхайте тіло й не перевертайте його.',
      'steps.asm_body.7': 'Відтягніть кінець дуги на 2–3 мм до центру, зігніть хвіст нитки вниз радіусом не менше 5 мм, покладіть його разом із дротом у жолоб каналу й відпустіть кінець дуги. Так з усіма чотирма кінцями; хвіст ніколи не гніть убік біля дуги.',
      'steps.asm_body.8': 'Проведіть дроти: у кожному з чотирьох каналів дріт виходить з контакту в жолоб, відкритий у бік центру, і йде далі вниз у корпус. Перевірте, що сині дроти («−») лежать біля передньої перемички, а червоні з резистором 47 Ом («+») біля задньої.',
      'steps.asm_body.9': 'Закріпіть дріт і метал контакту невеликою краплею термоклею до стінки в кожному з чотирьох каналів. Клей кладіть лише на дріт і контакт, ніколи на світну частину нитки.',
      'steps.asm_body.alt_1': 'Тіло корпусу, перевернуте відкритим низом догори: над трьома бобишками зависли помаранчеві вставки.',
      'steps.asm_body.alt_2': 'Тіло корпусу зверху: над двома стійками біля краю зависли помаранчеві вставки.',
      'steps.asm_body.alt_3': 'Тіло корпусу зсередини: помаранчева плата мікрофона відсунена від ложа на передній стінці.',
      'steps.asm_body.alt_4': 'Плата мікрофона в ложі, навколо її краю помаранчева смужка термоклею.',
      'steps.asm_body.alt_5': 'Дуга лежить пазом догори, над нею зависла помаранчева нитка, що виступає за кінець дуги.',
      'steps.asm_body.alt_6': 'Дві помаранчеві дуги з жовтими нитками підняті над обідком тіла, жовті хвости ниток звисають до каналів.',
      'steps.asm_body.alt_7': 'Помаранчеві хвости ниток лежать у двох каналах стінки під передньою перемичкою, над мікрофоном.',
      'steps.asm_body.alt_8': 'Від контактів двох ниток у каналах під передньою перемичкою помаранчеві дроти відходять до центру й ідуть униз у корпус повз мікрофон.',
      'steps.asm_body.alt_9': 'Помаранчева крапля термоклею накриває дроти й контакти ниток у каналах стінки.',
      'steps.asm_top.1': 'Покладіть верх лицем донизу й вплавте чотири вставки в бобишки під гвинти динаміка, до рівня краю бобишки.',
      'steps.asm_top.2': 'Вставте в отвір кнопки ковпачок з тильного боку верху, тобто зсередини.',
      'steps.asm_top.3': 'Підніміть перемикач із припаяними дротами з внутрішнього боку в тримач до упору й перевірте мультиметром на внутрішніх ніжках, що без натиску тиша. Якщо пищить, ковпачок постійно тисне на перемикач, і клеїти ще рано.',
      'steps.asm_top.4': 'Приклейте перемикач краплею термоклею з двох боків, де гачок сходиться з нижнім краєм; клей не має потрапити на штовхач і в щілину ковпачка. Коли клей застигне, натисніть ковпачок кілька разів, і сильно теж: мультиметр має пищати лише під час натиску.',
      'steps.asm_top.5': 'Покладіть у гніздо верху TPU-прокладку динаміка так, щоб вона лягла рівно по контуру гнізда.',
      'steps.asm_top.6': 'Покладіть на прокладку динамік лицем донизу, клемами навпроти кнопки, і відцентруйте його за зовнішнім краєм: опорне кільце верху має виступати за фланець скрізь однаково, приблизно на 0,8 мм.',
      'steps.asm_top.7': 'Покладіть на кожен із чотирьох кутових отворів фланця з тильного боку звичайну металеву шайбу M2.5 (DIN 125, Ø6 мм).',
      'steps.asm_top.8': 'Хрестовою викруткою закрутіть чотири гвинти M2.5 × 8 навхрест, по півоберта по діагоналі, притримуючи шайбу пальцем, поки гвинт не схопиться. Потім обережно натисніть на дифузор крізь вікна в кошику й перевірте, що підвіс ніде не шкрябає.',
      'steps.asm_top.9': 'Лише тепер підготуйте два дроти для динаміка: виміряйте відстань від клем динаміка через тіло до клемника підсилювача в лотку, що лежить поруч із тілом, додайте близько 3 см і відріжте дроти такої довжини. Припаяйте по дроту до кожної з двох клем динаміка, а другі кінці вставте в клемник підсилювача пізніше, у лотку.',
      'steps.asm_top.10': 'Пройдіть термоклеєм або нейтральним силіконом (не оцтовим) суцільним валиком по всьому периметру фланця, де він сходиться з опорним кільцем верху, включно з кутами й місцем біля клем. Дайте застигнути: щоб потім зняти динамік, цей валик доведеться розрізати ножем.',
      'steps.asm_top.alt_1': 'Верх лежить лицем донизу, над чотирма бобишками зависли помаранчеві вставки.',
      'steps.asm_top.alt_2': 'Верх лицем донизу, над отвором кнопки завис помаранчевий ковпачок.',
      'steps.asm_top.alt_3': 'Помаранчевий перемикач кнопки стоїть у тримачі верху, ніжки з припаяними дротами дивляться вгору.',
      'steps.asm_top.alt_4': 'Дві помаранчеві краплі клею по боках перемикача в тримачі верху.',
      'steps.asm_top.alt_5': 'Верх лицем донизу, над гніздом динаміка завис помаранчевий контур TPU-прокладки.',
      'steps.asm_top.alt_6': 'Помаранчевий динамік завис над прокладкою в гнізді верху, магнітом догори.',
      'steps.asm_top.alt_7': 'Динамік на місці, над кутовими отворами його фланця зависли помаранчеві металеві шайби.',
      'steps.asm_top.alt_8': 'Над чотирма шайбами зависли помаранчеві гвинти.',
      'steps.asm_top.alt_9': 'Два помаранчеві дроти відходять від клем динаміка.',
      'steps.asm_top.alt_10': 'Помаранчевий валик клею йде по всьому периметру фланця динаміка.',
      'steps.asm_join.1': 'Покладіть верх на дуги кнопкою на боці мікрофона, праворуч від нього, а дроти динаміка й кнопки пропустіть у корпус, щоб їх не защемило. Верх сідає й повернутим на 180°, тож звіртеся перед гвинтами.',
      'steps.asm_join.2': 'Закрутіть зверху хрестовою викруткою два гвинти M2.5 × 8 у вставки стійок, праворуч і ліворуч. Не перетягуйте: головки мають сісти нижче лиця.',
      'steps.asm_join.3': 'Вдавіть над головками дві TPU-заглушки фаскою вниз, щоб вони стали врівень з лицем. Щоб потім зняти верх, заглушку підчіпляють голкою.',
      'steps.asm_join.alt_1': 'Помаранчевий верх з динаміком завис над тілом з дугами.',
      'steps.asm_join.alt_2': 'Над зібраним корпусом, біля краю верху, зависли два помаранчеві гвинти.',
      'steps.asm_join.alt_3': 'Над головками гвинтів зависли дві помаранчеві TPU-заглушки.',
      'steps.asm_tray.1': 'Покладіть лоток дном догори й вклейте в чотири ніші чотири TPU-ніжки: ніжка ковзає в нішу з боку краю, плаский кінець у нішу, скошений до столу. Підійде суперклей або двосторонній скотч.',
      'steps.asm_tray.2': 'Покладіть лоток дном донизу й вплавте дві вставки зверху в стійки біля переднього, антенного кінця ложа DevKit, поки на лотку ще немає плати.',
      'steps.asm_tray.3': 'Покладіть DevKit, на якому вже позначено штирі (крок 2 «Дроти на DevKit»), деталями вниз, штирями вгору, USB-C до заднього краю лотка, де буде проріз, і натисніть донизу до клацання защіпок.',
      'steps.asm_tray.4': 'Хрестовою викруткою закрутіть два гвинти M2.5 × 8 просто крізь отвори плати біля антени у вставки стійок. Затягуйте помірно, щоб не тріснула плата.',
      'steps.asm_tray.5': 'Поставте підсилювач із напаяним конденсатором і дротами праворуч, якщо стати перед пристроєм: штирями роз\'єму догори, роз\'ємом до центру, клемником до стінки. Він тримається на друкованих фіксаторах, гвинтів не треба.',
      'steps.asm_tray.6': 'Приклейте термоклеєм джгут транзистора з резисторами до дна лотка ліворуч від DevKit, уздовж нього.',
      'steps.asm_tray.7': 'Перевірте конденсатор, напаяний на столі на штирі GND і VIN: він лежить набік, не вище кінчиків штирів, а ніжки не торкаються одна одної. Якщо треба, обережно підігніть ніжки.',
      'steps.asm_tray.8': 'Припаяйте вільні кінці дротів від підсилювача, мікрофона, транзистора, ниток і кнопки до кінчиків штирів DevKit, як у кроках 1 і 3–7 схеми «Дроти на DevKit» у розділі «Пайка».',
      'steps.asm_tray.9': 'Вставте дроти динаміка в гвинтовий клемник підсилювача, «+» до «+», і затягніть гвинти маленькою пласкою викруткою.',
      'steps.asm_tray.10': 'Поки лоток лежить поруч із тілом, а USB-C не вставлено, зробіть обидві перевірки мультиметром з кроків 8 і 9 схеми «Дроти на DevKit» і огляньте кожну пайку.',
      'steps.asm_tray.11': 'Покладіть на фланець лотка TPU-прокладку губою догори й притримайте краплями клею чи скотчем, вставте лоток знизу в тіло так, щоб USB-C стояв проти прорізу, і закрутіть хрестовою викруткою три гвинти. Не затягуйте до упору: губа прокладки має трохи зігнутися, а підлога лотка й так зупинить лоток.',
      'steps.asm_tray.alt_1': 'Лоток дном догори, над нішами зависли чотири помаранчеві TPU-ніжки.',
      'steps.asm_tray.alt_2': 'Лоток зверху, над двома стійками біля антенного кінця зависли помаранчеві вставки.',
      'steps.asm_tray.alt_3': 'Помаранчевий DevKit завис над ложем у лотку штирями вгору, USB-C до заднього краю.',
      'steps.asm_tray.alt_4': 'Над двома отворами DevKit біля антени зависли помаранчеві гвинти.',
      'steps.asm_tray.alt_5': 'Помаранчевий підсилювач із напаяним конденсатором завис над своїми фіксаторами праворуч у лотку.',
      'steps.asm_tray.alt_6': 'Помаранчевий транзистор лежить на краплі клею на дні лотка ліворуч від DevKit, уздовж нього.',
      'steps.asm_tray.alt_7': 'Помаранчевий конденсатор лежить набік на ніжках, що йдуть до штирів підсилювача.',
      'steps.asm_tray.alt_8': 'Лоток з платами: помаранчеві дроти відходять убік від кінчиків штирів DevKit.',
      'steps.asm_tray.alt_9': 'Лоток з платами: помаранчеві дроти динаміка йдуть від клемника підсилювача, а сірі дроти відходять убік від штирів DevKit.',
      'steps.asm_tray.alt_10': 'Лоток з платами крупним планом: помаранчевим виділено кінчики штирів VIN, GND і 3V3 на DevKit.',
      'steps.asm_tray.alt_11': 'Тіло з верхом, під ним лоток з помаранчевою прокладкою на фланці, а ще нижче три помаранчеві гвинти.',

      'solder.pinmap.alt': 'Карта штирів ESP32 DevKit V1, вигляд з боку написів (деталей), антена вгорі: зайняті штирі виділено й підписано, куди йде кожен дріт.',
      'solder.pinmap.caption': 'Вигляд з боку написів (деталей), антена вгорі. У лотку плата лежить навпаки, штирями вгору, тож написів там не видно: ряд з D22, D4, D19 і 3V3 лежить з боку підсилювача, ряд з D26, D27 і VIN з боку транзистора. Два штирі GND приймають чотири дроти, на VIN сходяться три.',
      'pinmap.board': 'ESP32 DevKit',
      'pinmap.usb': 'USB-C',
      'pinmap.antenna': 'антена',
      'pinmap.row_tr': 'бік транзистора в лотку',
      'pinmap.row_amp': 'бік підсилювача в лотку',
      'pinmap.mic_sck': 'мікрофон SCK',
      'pinmap.mic_sd': 'мікрофон SD',
      'pinmap.mic_ws': 'мікрофон WS',
      'pinmap.amp_bclk': 'підсилювач BCLK',
      'pinmap.amp_lrc': 'підсилювач LRC',
      'pinmap.amp_gnd': 'підсилювач GND',
      'pinmap.vin': 'підсилювач VIN, кільце «+» ×2',
      'pinmap.amp_din': 'підсилювач DIN',
      'pinmap.button': 'кнопка',
      'pinmap.ring_g': 'кільце G, через 47 Ом',
      'pinmap.mic_gnd': 'мікрофон GND',
      'pinmap.mic_vdd': 'мікрофон VDD',
      'pinmap.gnd_any': 'S кільця й GND кнопки: на будь-який GND',
      'wires.caption': 'Усі довжини рекомендовані й узяті із запасом. Позначка «≈» — орієнтовна довжина.',
      'wires.col.from': 'Звідки',
      'wires.col.to': 'Куди',
      'wires.col.len': 'Довжина',
      'wires.from.mic_vdd': 'мікрофон VDD',
      'wires.from.mic_gnd': 'мікрофон GND',
      'wires.from.mic_sd': 'мікрофон SD',
      'wires.from.mic_ws': 'мікрофон WS',
      'wires.from.mic_sck': 'мікрофон SCK',
      'wires.from.amp_vin': 'підсилювач VIN',
      'wires.from.amp_gnd': 'підсилювач GND',
      'wires.from.amp_din': 'підсилювач DIN',
      'wires.from.amp_bclk': 'підсилювач BCLK',
      'wires.from.amp_lrc': 'підсилювач LRC',
      'wires.from.ring_g': 'транзистор G (ліва ніжка), через 47 Ом',
      'wires.from.ring_d': 'транзистор D (середня ніжка), 2 дроти',
      'wires.from.ring_s': 'транзистор S (права ніжка)',
      'wires.from.ring_plus': '«+» кожної нитки, через 47 Ом',
      'wires.from.btn_1': 'кнопка, внутрішня ніжка 1',
      'wires.from.btn_2': 'кнопка, внутрішня ніжка 2',
      'wires.to.gnd_3v3': 'GND (ряд з 3V3)',
      'wires.to.fil_minus': '«−» нитки 1 і «−» нитки 2',
      'wires.to.gnd_any': 'GND (будь-який із двох)',
      'wires.len': '{n} см',
      'wires.len_each': 'по {n} см',
      'wires.len_approx': '≈{n} см, орієнтовно',
      'wires.decimal': ',',
      'pins.EN': 'EN',
      'pins.VP': 'VP',
      'pins.VN': 'VN',
      'pins.D34': 'D34',
      'pins.D35': 'D35',
      'pins.D32': 'D32',
      'pins.D33': 'D33',
      'pins.D25': 'D25',
      'pins.D26': 'D26',
      'pins.D27': 'D27',
      'pins.D14': 'D14',
      'pins.D12': 'D12',
      'pins.D13': 'D13',
      'pins.GND': 'GND',
      'pins.VIN': 'VIN',
      'pins.D23': 'D23',
      'pins.D22': 'D22',
      'pins.TX0': 'TX0',
      'pins.RX0': 'RX0',
      'pins.D21': 'D21',
      'pins.D19': 'D19',
      'pins.D18': 'D18',
      'pins.D5': 'D5',
      'pins.TX2': 'TX2',
      'pins.RX2': 'RX2',
      'pins.D4': 'D4',
      'pins.D2': 'D2',
      'pins.D15': 'D15',
      'pins.3V3': '3V3',

      'support.title': 'Підтримати проєкт',
      'support.text': 'Якщо проєкт став у пригоді, можна підтримати автора.',
      'support.donate': 'Donate',

      'footer.code': 'Код',
      'footer.case': 'корпус і тексти',
      'footer.version': 'Версія',

      'v2.hero.title': 'Голосова колонка для розмови з GPT',
      'v2.hero.lead': 'Колонка розмовляє з OpenAI через Wi-Fi, а тут описано, як вона зроблена і як її повторити.',
      'v2.hero.image': 'Питайченко на столі: невисокий круглий чорний корпус, верх у дрібних отворах, під ним тонка біла смужка кільця, збоку маленький отвір мікрофона',
      'v2.can.button': 'Вмикається ключовою фразою або кнопкою',
      'v2.can.wake': 'Ключову фразу можна обрати з трьох: Hey Jarvis, Okay Nabu або Hey Mycroft',
      'v2.can.voice': 'Відповідає голосом',
      'v2.can.ring': 'Кільце світлом показує стан',
      'v2.can.follow': 'Після відповіді можна питати далі без фрази',
      'v2.can.stop': '«Дякую, все» завершує розмову',
      'v2.can.volume': 'Гучність змінюється голосом',
      'v2.can.settings': 'Налаштування — на сторінці самої колонки, яку відкривають у браузері: ключ OpenAI, модель (звичайна розмова в реальному часі або GPT-Live), мова розмови, голос, гучність, ключова фраза',
      'v2.can.update': 'Оновлюється зі сторінки налаштувань, без кабелю: нову прошивку колонка бере з GitHub або з файлу на комп\'ютері',
      'v2.need.time_label': 'Орієнтовний час друку',
      'v2.need.time_value': 'близько 5–6 годин',
      'v2.need.cost_label': 'Орієнтовна вартість деталей',
      'v2.need.cost_pending': 'Уточнюється',
      'v2.parts.caption': 'Кількість вказано на один пристрій.',
      'v2.parts.col.part': 'Деталь',
      'v2.parts.col.qty': 'К-сть',
      'v2.parts.col.price': 'Ціна',
      'v2.parts.col.link': 'Де взяти',
      'v2.parts.name.devkit': 'Плата ESP32-S3-DevKitC N16R8, два роз\'єми USB-C',
      'v2.parts.name.mic': 'Модуль мікрофона INMP441',
      'v2.parts.name.amp': 'Модуль підсилювача MAX98357A',
      'v2.parts.name.speaker': 'Динамік Visaton FRS 5 X, 8 Ом',
      'v2.parts.name.filament': 'Світлодіодна нитка (LED filament)',
      'v2.parts.name.mosfet': 'Транзистор IRLZ44N',
      'v2.parts.name.res47': 'Резистор 47 Ом',
      'v2.parts.name.res62k': 'Резистор 6,2 кОм',
      'v2.parts.name.cap': 'Конденсатор 1000 мкФ, 16 В',
      'v2.parts.name.button': 'Тактова кнопка 12×12 мм',
      'v2.parts.name.inserts': 'Латунні різьбові вставки M2.5',
      'v2.parts.name.screws': 'Гвинти M2.5×8 мм з потайною головкою',
      'v2.parts.name.washers': 'Металеві шайби M2.5 (DIN 125, Ø6 мм)',
      'v2.parts.name.wires': 'Монтажні дроти',
      'v2.parts.name.charger': 'Зарядний пристрій USB-C 5 В 2 А з кабелем',
      'v2.parts.name.petg_black': 'PETG чорний',
      'v2.parts.name.petg_white': 'PETG білий',
      'v2.parts.name.tpu': 'TPU',
      'v2.parts.note.devkit': 'Потрібна саме версія N16R8 (16 МБ флеш-пам\'яті, 8 МБ PSRAM) з двома роз\'ємами USB-C: прошивка розрахована на цю пам\'ять, а лоток — на цю плату. Перед замовленням звірте плату на сторінці товару.',
      'v2.parts.note.mic': 'Два круглі модулі діаметром близько 14 мм, без впаяних штирів.',
      'v2.parts.note.amp': 'Плата з гребінкою на 7 виводів і гвинтовим клемником для динаміка.',
      'v2.parts.note.speaker': 'Корпус підігнано саме під цей динамік. Потрібен варіант на 8 Ом.',
      'v2.parts.note.filament': 'Потрібна одна нитка Ø1,5 мм у такому варіанті: 3 В, близько 185 мм, 100 мА. Колір світіння — на ваш смак. Резистор 47 Ом від 5 В розраховано саме на нитку на 3 В, тож звірте варіант на сторінці товару.',
      'v2.parts.note.inserts': 'Потрібно 9 вставок M2.5 (довжина 4 мм, Ø3,5 мм).',
      'v2.parts.note.screws': 'Потрібно 9 гвинтів під хрестову викрутку.',
      'v2.parts.note.wires': 'Тонкий багатожильний дріт 26–30 AWG дев\'яти кольорів.',
      'v2.parts.note.charger': 'Кабель із передаванням даних, не лише для заряджання. Втулка в отворі корпусу розрахована на штекер USB-C з корпусом 10 × 6,2 мм; для товщого штекера (до 12 × 7 мм) втулку не ставлять.',
      'v2.parts.note.petg_black': 'Тіло, верх, лоток, ковпачок кнопки, три заглушки. Іде частина котушки.',
      'v2.parts.note.petg_white': 'Дуга кільця.',
      'v2.parts.note.tpu': 'Три прокладки, чотири ніжки, втулка кабелю.',
      'v2.tools.item.printer': '3D-принтер, що друкує PETG і TPU',
      'v2.tools.item.iron': 'Паяльник',
      'v2.tools.item.solder': 'Припій і флюс',
      'v2.tools.item.insert_tip': 'Насадка до паяльника для вплавлення вставок (бажано, але можна й звичайним жалом)',
      'v2.tools.item.multimeter': 'Мультиметр із прозвонкою',
      'v2.tools.item.cutters': 'Бокорізи',
      'v2.tools.item.glue_gun': 'Термоклеєвий пістолет',
      'v2.tools.item.screwdriver': 'Хрестова викрутка для гвинтів M2.5',
      'v2.tools.item.flat_screwdriver': 'Маленька пласка викрутка для клемника підсилювача',
      'v2.tools.item.battery': 'Батарейка CR2032 для перевірки полярності нитки',
      'v2.tools.item.marker': 'Маркер',
      'v2.tools.item.tape': 'Малярний скотч для позначок L і R на дротах мікрофонів і для резистора нитки (або термоусадка)',
      'v2.print.intro': 'Корпус друкується з PETG і TPU. Назва деталі — посилання на її STL-файл; у кожному файлі одна деталь, а число в назві файлу (_x3, _x4) показує, скільки копій друкувати.',
      'v2.print.common': 'Деталі надруковано на Bambu Lab X1 Carbon: сопло 0,4 мм, перший шар 0,2 мм, стінки Arachne. Підійде будь-який принтер, що друкує PETG і TPU.',
      'v2.print.archive': 'Усі файли одним архівом (ZIP)',
      'v2.print.archive_note': 'Архів збирається під час публікації сайту, тож у клонованому репозиторії його немає: там ці самі файли лежать у папці v2/case/stl.',
      'v2.print.name.top': 'Верх (решітка-соняшник, тримач кнопки, стійки динаміка)',
      'v2.print.name.body': 'Тіло',
      'v2.print.name.ring_arc': 'Дуга кільця',
      'v2.print.name.tray': 'Лоток (дно з DevKitC і підсилювачем)',
      'v2.print.name.button_cap': 'Ковпачок кнопки',
      'v2.print.name.speaker_gasket': 'Прокладка під динамік',
      'v2.print.name.top_gasket': 'Прокладка верху',
      'v2.print.name.tray_gasket': 'Прокладка лотка',
      'v2.print.name.top_plug': 'Заглушка над гвинтом верху',
      'v2.print.name.foot': 'Ніжка',
      'v2.print.name.com_bushing': 'Втулка під кабель USB-C',
      'v2.print.plastic.petg_black': 'PETG чорний',
      'v2.print.plastic.petg_white': 'PETG білий',
      'v2.print.plastic.tpu': 'TPU',
      'v2.print.settings.petg': 'шар 0,16 мм, стінки 4–5, зовнішня стінка 60 мм/с, внутрішня 100 мм/с при 5000 мм/с², без опор',
      'v2.print.settings.arc': 'шар 0,16 мм, від 2 стінок, без опор',
      'v2.print.settings.tpu': 'шар 0,16 мм, заповнення 100 % (zig-zag), без опор',
      'v2.print.note.body': 'у слайсері поверніть на 180°',
      'v2.print.note.tray': 'у слайсері поверніть на 180°',
      'v2.print.how.title': 'Як друкувати',
      'v2.print.how.orient': 'Усі файли вже лежать у правильному положенні: верх друкують лицем на стіл, ковпачок кнопки догори дном, дугу на її пласкому верхньому боці, заглушки лицем на стіл.',
      'v2.print.how.seam': 'Шов поставте ззаду («Back»). У слайсері тіло й лоток з\'являються передом (бік мікрофонів і антени) до заднього краю столу, тож перед нарізкою поверніть обидва на 180°: тоді шов ляже ззаду колонки, з боку кнопки й USB-C. Верх уже лежить правильно.',
      'v2.print.how.supports': 'Опори (підтримки) не потрібні ніде. Короткі «мости» так і задумані: над отвором USB-C у лотку, над нішами ніжок, на полицях гнізд заглушок і в гніздах під голівки гвинтів верху. Щоб вони не провисали волосінням, увімкніть у Bambu Studio «Thick bridges» (Якість → Мости) і висушіть PETG перед друком: 65 °C, 6–8 годин.',
      'v2.print.how.layer': 'Тіло й дугу друкуйте шаром 0,16 мм: висоту дуги (2,88 мм) підігнано під перемичку тіла, надруковану таким шаром. Дуга виходить на 0,04 мм вищою за перемичку, тож верх її злегка притискає й вона не бряжчить. Для іншого шару висоту треба перерахувати в моделі й заново зібрати файли.',
      'v2.print.how.walls': 'Arachne — режим генерації стінок у Bambu Studio; у стандартному профілі стоїть Classic, тож для всіх деталей увімкніть Arachne.',
      'v2.print.how.tpu': 'TPU-деталі друкуйте шаром 0,16 мм із заповненням 100 % (візерунок zig-zag), без опор.',
      'v2.solder.intro': 'Усе паяють на столі, ще до збирання: мікрофони, підсилювач із конденсатором, нитку кільця з транзистором, кнопку й динамік, а потім і всі дроти на DevKitC. Біля кожного дроту на малюнку підписано, куди він іде, і його довжину: відріжте дріт саме такої довжини, разом із зачищеними кінцями (близько 3 мм з кожного боку). Довжини взято з моделі корпусу із запасом. Порада: якщо спершу вставити DevKitC і підсилювач у лоток і приклеїти транзистор (етап «Лоток» розділу «Збирання», кроки 1–3), паяти зручніше, бо лоток тримає їх нерухомо.',
      'v2.solder.pinmap.title': 'Карта штирів DevKitC',
      'v2.solder.pinmap.intro': 'Плата лежить у лотку написами догори, антеною вперед, роз\'ємами USB-C назад. Перед колонки — бік з мікрофонами й антеною, зад — бік з роз\'ємом USB-C, а ліво й право — як видно ззаду. Ряд 1 — той, що з боку роз\'єму COM (праворуч), ряд 2 — з боку другого роз\'єму USB (ліворуч). Штирі рахують від кінця з антеною, від 1 до 22. Кожен дріт паяють до кінчика довгого штиря, на 4 мм над платою.',
      'v2.solder.pinmap.caption': 'Зайняті штирі: ряд, номер від антени, напис на платі, що робить штир і які дроти на нього йдуть.',
      'v2.solder.pinmap.col.row': 'Ряд',
      'v2.solder.pinmap.col.pin': 'Штир',
      'v2.solder.pinmap.col.label': 'Напис',
      'v2.solder.pinmap.col.fn': 'Що робить',
      'v2.solder.pinmap.col.wires': 'Звідки дроти',
      'v2.solder.pinmap.fn.mic_l_power': 'живлення мікрофона L',
      'v2.solder.pinmap.fn.mic_r_power': 'живлення мікрофона R',
      'v2.solder.pinmap.fn.mic_sck': 'тактовий сигнал мікрофонів (SCK)',
      'v2.solder.pinmap.fn.mic_ws': 'вибір каналу мікрофонів (WS)',
      'v2.solder.pinmap.fn.mic_sd': 'дані мікрофонів (SD)',
      'v2.solder.pinmap.fn.amp_bclk': 'тактовий сигнал підсилювача (BCLK)',
      'v2.solder.pinmap.fn.amp_lrc': 'вибір каналу підсилювача (LRC)',
      'v2.solder.pinmap.fn.amp_din': 'дані підсилювача (DIN)',
      'v2.solder.pinmap.fn.ring': 'кільце (затвор транзистора, через 47 Ом)',
      'v2.solder.pinmap.fn.button': 'кнопка зверху (натиснута — з\'єднана з GND)',
      'v2.solder.pinmap.fn.power': '5 В для підсилювача й нитки',
      'v2.solder.pinmap.fn.gnd_ring_button': 'земля кільця й кнопки',
      'v2.solder.pinmap.fn.gnd_mics': 'земля обох мікрофонів',
      'v2.solder.pinmap.fn.gnd_amp': 'земля підсилювача',
      'v2.solder.pinmap.button': 'Кнопка працює через внутрішню підтяжку чипа, тож їй потрібні лише два дроти: на GPIO8 і на GND.',
      'v2.solder.pinmap.apart': 'Живлення й земля мікрофонів ідуть на власні штирі, окремо від дротів підсилювача й кільця: так у звук мікрофонів менше потрапляє гул.',
      'v2.wires.from.mic_l_vdd': 'мікрофон L, VDD',
      'v2.wires.from.mic_l_gnd': 'мікрофон L, GND',
      'v2.wires.from.mic_l_sck': 'мікрофон L, SCK',
      'v2.wires.from.mic_l_ws': 'мікрофон L, WS',
      'v2.wires.from.mic_l_sd': 'мікрофон L, SD',
      'v2.wires.from.mic_r_vdd': 'мікрофон R, VDD',
      'v2.wires.from.mic_r_gnd': 'мікрофон R, GND',
      'v2.wires.from.mic_r_sck': 'мікрофон R, SCK',
      'v2.wires.from.mic_r_ws': 'мікрофон R, WS',
      'v2.wires.from.mic_r_sd': 'мікрофон R, SD',
      'v2.wires.from.amp_lrc': 'підсилювач, LRC',
      'v2.wires.from.amp_bclk': 'підсилювач, BCLK',
      'v2.wires.from.amp_din': 'підсилювач, DIN',
      'v2.wires.from.amp_gnd': 'підсилювач, GND',
      'v2.wires.from.amp_vin': 'підсилювач, Vin',
      'v2.wires.from.spk_plus': 'динамік, «+»',
      'v2.wires.from.spk_minus': 'динамік, «−»',
      'v2.wires.from.tr_g': 'транзистор, G (на ньому резистор 47 Ом)',
      'v2.wires.from.tr_s': 'транзистор, S',
      'v2.wires.from.fil_minus': 'нитка, «−» (правий кінець)',
      'v2.wires.from.fil_plus': 'нитка, «+» (лівий кінець, на ньому резистор 47 Ом)',
      'v2.wires.from.btn_a': 'кнопка, ніжка A',
      'v2.wires.from.btn_b': 'кнопка, ніжка B',
      'v2.wires.to.amp_plus': 'клема «+» підсилювача',
      'v2.wires.to.amp_minus': 'клема «−» підсилювача',
      'v2.wires.to.tr_d': 'транзистор, D (середня ніжка)',
      'v2.wires.colour.red': 'червоний',
      'v2.wires.colour.brown': 'коричневий',
      'v2.wires.colour.black': 'чорний',
      'v2.wires.colour.yellow': 'жовтий',
      'v2.wires.colour.green': 'зелений',
      'v2.wires.colour.blue': 'синій',
      'v2.wires.colour.white': 'білий',
      'v2.wires.colour.grey': 'сірий',
      'v2.wires.colour.purple': 'фіолетовий',
      'steps.v2_wire.M1': 'на 3V3 DevKitC · 4,5 см',
      'steps.v2_from.M1': 'мікрофон L · VDD · 4,5 см',
      'steps.v2_wire.M2': 'на GND DevKitC · 7 см',
      'steps.v2_from.M2': 'мікрофон L · GND · 7 см',
      'steps.v2_wire.M3': 'на GPIO5 DevKitC · 5 см',
      'steps.v2_from.M3': 'мікрофон L · SCK · 5 см',
      'steps.v2_wire.M4': 'на GPIO6 DevKitC · 5 см',
      'steps.v2_from.M4': 'мікрофон L · WS · 5 см',
      'steps.v2_wire.M5': 'на GPIO7 DevKitC · 5 см',
      'steps.v2_from.M5': 'мікрофон L · SD · 5 см',
      'steps.v2_wire.M6': 'на 3V3 DevKitC · 8,5 см',
      'steps.v2_from.M6': 'мікрофон R · VDD · 8,5 см',
      'steps.v2_wire.M7': 'на GND DevKitC · 9,5 см',
      'steps.v2_from.M7': 'мікрофон R · GND · 9,5 см',
      'steps.v2_wire.M8': 'на GPIO5 DevKitC · 9 см',
      'steps.v2_from.M8': 'мікрофон R · SCK · 9 см',
      'steps.v2_wire.M9': 'на GPIO6 DevKitC · 9,5 см',
      'steps.v2_from.M9': 'мікрофон R · WS · 9,5 см',
      'steps.v2_wire.M10': 'на GPIO7 DevKitC · 9,5 см',
      'steps.v2_from.M10': 'мікрофон R · SD · 9,5 см',
      'steps.v2_wire.A1': 'на GPIO16 DevKitC · 5 см',
      'steps.v2_from.A1': 'підсилювач · LRC · 5 см',
      'steps.v2_wire.A2': 'на GPIO15 DevKitC · 5,5 см',
      'steps.v2_from.A2': 'підсилювач · BCLK · 5,5 см',
      'steps.v2_wire.A3': 'на GPIO17 DevKitC · 6 см',
      'steps.v2_from.A3': 'підсилювач · DIN · 6 см',
      'steps.v2_wire.A4': 'на GND DevKitC · 5,5 см',
      'steps.v2_from.A4': 'підсилювач · GND · 5,5 см',
      'steps.v2_wire.A5': 'на 5Vin DevKitC · 8 см',
      'steps.v2_from.A5': 'підсилювач · Vin · 8 см',
      'steps.v2_wire.S1': 'у клему «+» підсилювача · 17,5 см',
      'steps.v2_from.S1': 'динамік «+» · 17,5 см',
      'steps.v2_wire.S2': 'у клему «−» підсилювача · 17,5 см',
      'steps.v2_from.S2': 'динамік «−» · 17,5 см',
      'steps.v2_wire.R1': 'на GPIO18 DevKitC · 4,5 см',
      'steps.v2_from.R1': 'транзистор · G (через 47 Ом) · 4,5 см',
      'steps.v2_wire.R2': 'на GND DevKitC · 9 см',
      'steps.v2_from.R2': 'транзистор · S · 9 см',
      'steps.v2_wire.R3': 'на ніжку D транзистора · 14 см',
      'steps.v2_wire.R4': 'на 5Vin DevKitC · 6 см',
      'steps.v2_from.R4': 'нитка «+» (через 47 Ом) · 6 см',
      'steps.v2_wire.B1': 'на GPIO8 DevKitC · 14 см',
      'steps.v2_from.B1': 'кнопка · 14 см',
      'steps.v2_wire.B2': 'на GND DevKitC · 15 см',
      'steps.v2_from.B2': 'кнопка · 15 см',
      'v2.solder.pinmap.w.r2p1': 'мікрофон L · VDD',
      'v2.solder.pinmap.w.r1p1': 'мікрофон L · GND; мікрофон R · GND',
      'v2.solder.pinmap.w.r2p5': 'мікрофон L · SCK; мікрофон R · SCK',
      'v2.solder.pinmap.w.r2p6': 'мікрофон L · WS; мікрофон R · WS',
      'v2.solder.pinmap.w.r2p7': 'мікрофон L · SD; мікрофон R · SD',
      'v2.solder.pinmap.w.r2p2': 'мікрофон R · VDD',
      'v2.solder.pinmap.w.r2p9': 'підсилювач · LRC',
      'v2.solder.pinmap.w.r2p8': 'підсилювач · BCLK',
      'v2.solder.pinmap.w.r2p10': 'підсилювач · DIN',
      'v2.solder.pinmap.w.r1p21': 'підсилювач · GND',
      'v2.solder.pinmap.w.r2p21': 'підсилювач · Vin; нитка «+» (через 47 Ом)',
      'v2.solder.pinmap.w.r2p11': 'транзистор · G (через 47 Ом)',
      'v2.solder.pinmap.w.r2p22': 'транзистор · S; кнопка',
      'v2.solder.pinmap.w.r2p12': 'кнопка',
      'steps.v2_mics.title_l': 'мікрофон L',
      'steps.v2_mics.title_r': 'мікрофон R',
      'steps.v2_mics.chip': 'чип',
      'steps.v2_mics.sck': 'SCK',
      'steps.v2_mics.ws': 'WS',
      'steps.v2_mics.lr': 'L/R',
      'steps.v2_mics.sd': 'SD',
      'steps.v2_mics.vdd': 'VDD',
      'steps.v2_mics.gnd': 'GND',
      'steps.v2_mics.order_note': 'так на поширеній платі; паяйте за написами на своїй',
      'steps.v2_mics.jumper_l': 'L/R — GND',
      'steps.v2_mics.jumper_r': 'L/R — VDD',
      'steps.v2_mics.flat_title': 'бік з отвором',
      'steps.v2_mics.flat_trim': 'хвости врівень з платою',
      'steps.v2_mics.flat_poke': 'не тицяти в отвір',
      'steps.v2_mics.tag_l': 'L',
      'steps.v2_mics.tag_r': 'R',
      'v2.solder.mics.title': 'Мікрофони',
      'steps.v2_mics.1': 'Дві плати INMP441 без впаяних штирів, вигляд з боку чипа: дроти паяють прямо на їхні шість контактів. Бік з отвором для звуку лишається рівним, бо піде до стінки корпусу.',
      'steps.v2_mics.2': 'Спершу перемичка L/R коротким відрізком дроту з боку чипа: на мікрофоні L з\'єднайте L/R із GND (вони навпроти одне одного), на мікрофоні R — L/R із VDD. Так прошивка розрізняє мікрофони: один звучить у лівому каналі, другий у правому. Не робіть перемичку краплею припою на боці з отвором.',
      'steps.v2_mics.3': 'П\'ять дротів мікрофона L. Біля кожного підписано, куди він піде на DevKitC, і його довжину: відріжте дріт такої довжини, вставте кінець в отвір контакту з боку чипа й паяйте з цього ж боку.',
      'steps.v2_mics.4': 'Так само п\'ять дротів мікрофона R. Вони довші, бо мікрофон R далі від DevKitC.',
      'steps.v2_mics.5': 'Переверніть плати й на боці з отвором зріжте виступи дротів врівень з платою. Нічим не тицяйте в отвір: під ним мембрана.',
      'steps.v2_mics.6': 'Обмотайте пучок дротів кожного мікрофона біля плати шматочком малярного скотчу й підпишіть «L» або «R»: при збиранні мікрофон L іде в ліве гніздо, R — у праве, а на DevKitC дроти теж треба розрізняти.',
      'steps.v2_mics.alt': 'Покрокова пайка двох мікрофонів INMP441: контакти з боку чипа, перемички L/R (на мікрофоні L до GND, на мікрофоні R до VDD), по п\'ять дротів на мікрофон із підписом, куди дріт іде, і його довжиною, хвости, зрізані з боку отвору, і позначки L та R на скотчі.',
      'steps.v2_amp.side': 'підсилювач збоку',
      'steps.v2_amp.labels_edge': 'край з написами LRC … Vin',
      'steps.v2_amp.header': 'гребінка: пластик зверху, довгі штирі вгору',
      'steps.v2_amp.terminal': 'клемник: той самий бік, отвори назовні',
      'steps.v2_amp.below': 'пайка знизу, хвости врівень з платою',
      'steps.v2_amp.max': 'MAX98357A',
      'steps.v2_amp.lrc': 'LRC',
      'steps.v2_amp.bclk': 'BCLK',
      'steps.v2_amp.din': 'DIN',
      'steps.v2_amp.gain': 'GAIN',
      'steps.v2_amp.sd': 'SD',
      'steps.v2_amp.gnd': 'GND',
      'steps.v2_amp.vin': 'Vin',
      'steps.v2_amp.to_speaker': 'до динаміка',
      'steps.v2_amp.stripe': '−  −  −  −',
      'steps.v2_amp.value': '1000 мкФ',
      'steps.v2_amp.stripe_note': 'смужка = «−», коротка ніжка',
      'steps.v2_amp.long_leg': 'довга ніжка = «+»',
      'steps.v2_amp.on_side': 'лежить набік, не вище штирів',
      'steps.v2_amp.silence': 'тиша',
      'steps.v2_amp.beep_ok': 'короткий пік на початку — теж норма',
      'v2.solder.amp.title': 'Підсилювач і конденсатор',
      'steps.v2_amp.1': 'Якщо гребінку й клемник ще не впаяно: гребінку із семи штирів вставте з верхнього боку вздовж краю з написами, довгими штирями вгору, а клемник — на той самий бік уздовж протилежного краю, отворами назовні. Пропаяйте обидва знизу й зріжте хвости під платою врівень з нею.',
      'steps.v2_amp.2': 'Підсилювач зверху. Штирі гребінки йдуть у порядку LRC, BCLK, DIN, GAIN, SD, GND, Vin: GND і Vin поруч, на кінці гребінки. Звірте з написами на своїй платі.',
      'steps.v2_amp.3': 'Конденсатор 1000 мкФ: довгу ніжку «+» припаяйте до Vin, коротку «−» (з боку світлої смужки) до GND, низько біля основи штирів, щоб кінчики лишилися вільними для дротів. Ніжки загніть так, щоб вони не торкалися одна одної, а конденсатор ліг набік не вище кінчиків штирів. Не переплутайте: перевернутий конденсатор гріється й може луснути.',
      'steps.v2_amp.4': 'До кінчиків штирів LRC, BCLK, DIN, GND і Vin припаяйте по дроту такої довжини, як підписано, і одразу відведіть їх убік. GAIN і SD лишаються вільними: тоді підсилення середнє (9 дБ), а підсилювач завжди ввімкнений.',
      'steps.v2_amp.5': 'Перевірка: мультиметр у режимі прозвонки на Vin і GND. Має бути тиша; короткий писк на самому початку — теж нормально, так заряджається конденсатор. Безперервний писк означає замикання.',
      'steps.v2_amp.alt': 'Покрокова пайка підсилювача MAX98357A: гребінка й клемник, пропаяні знизу, порядок виводів LRC, BCLK, DIN, GAIN, SD, GND, Vin, конденсатор 1000 мкФ на Vin і GND, п\'ять дротів до кінчиків штирів із підписом, куди дріт іде, і його довжиною, і перевірка мультиметром.',
      'steps.v2_ring.battery': 'CR2032, «+» зверху',
      'steps.v2_ring.lights': 'світиться лише так',
      'steps.v2_ring.mark_plus': 'позначте «+» маркером',
      'steps.v2_ring.plus': '+',
      'steps.v2_ring.minus': '−',
      'steps.v2_ring.filament': 'нитка',
      'steps.v2_ring.contact': 'лише металевий контакт, швидко',
      'steps.v2_ring.res_fil': '47 Ом',
      'steps.v2_ring.sleeve': 'термоусадка або скотч',
      'steps.v2_ring.irlz': 'IRLZ44N',
      'steps.v2_ring.g': 'G',
      'steps.v2_ring.d': 'D',
      'steps.v2_ring.s': 'S',
      'steps.v2_ring.res_gs': '6,2 кОм',
      'steps.v2_ring.res_47': '47 Ом',
      'steps.v2_ring.tab': 'пластина з\'єднана з D',
      'v2.solder.ring.title': 'Кільце: нитка й транзистор',
      'steps.v2_ring.1': 'Спершу знайдіть «+» нитки: притисніть її кінці до двох боків батарейки CR2032. Нитка світиться лише в одному положенні, і кінець, що торкається «+» батарейки, позначте маркером «+».',
      'steps.v2_ring.2': 'До контакту «−» припаяйте дріт, а до контакту «+» — резистор 47 Ом, з коротким виводом і в одну лінію з ниткою. Паяйте лише до металевого контакту 5 мм на кінці нитки, ніколи до світної частини, і швидко, бо нитка не любить нагрівання. Другий кінець дроту з «−» піде на ніжку D транзистора.',
      'steps.v2_ring.3': 'До вільного кінця резистора припаяйте дріт, він піде на 5Vin DevKitC. Порада: надягніть на резистор разом із пайкою термоусадку або обмотайте їх скотчем. У корпусі резистор лежить біля стінки, у продовження хвоста нитки, і так нічого не замкне. На малюнку «+» праворуч лише для зручності: у корпусі кінець «+» з резистором ляже ліворуч, якщо дивитися ззаду, з боку USB-C.',
      'steps.v2_ring.4': 'Візьміть транзистор написом до себе, ніжками донизу. Зліва направо: G, D, S.',
      'steps.v2_ring.5': 'Припаяйте резистор 6,2 кОм між ніжками G і S: поки плата запускається, він тримає транзистор закритим. Мультиметр на ньому має показати близько 6,2 кОм.',
      'steps.v2_ring.6': 'На кінець ніжки G припаяйте другий резистор 47 Ом. Його виводи лишайте короткими, щоб вони не торкалися сусідніх ніжок і пайок.',
      'steps.v2_ring.7': 'До вільного кінця цього резистора припаяйте дріт, він піде на GPIO18 DevKitC, а до ніжки S — дріт, що піде на GND. Дріт від резистора короткий, бо решту шляху додає сам резистор.',
      'steps.v2_ring.8': 'Металева пластина транзистора з\'єднана з D, тож вона не має торкатися інших пайок і ніжок.',
      'steps.v2_ring.9': 'Наостанок дріт від «−» нитки припаяйте до середньої ніжки D. Так з\'єднано все кільце: 5Vin DevKitC → дріт → 47 Ом → нитка → дріт → транзистор (D до S) → дріт → GND, а GPIO18 через дріт і 47 Ом на G відкриває транзистор, і нитка світиться.',
      'steps.v2_ring.alt': 'Покрокова пайка кільця: полярність нитки батарейкою CR2032, дріт на «−» нитки, резистор 47 Ом і дріт на 5Vin на «+», термоусадка, транзистор IRLZ44N з ніжками G, D, S, резистори 6,2 кОм і 47 Ом, дріт на GPIO18, дрій на GND і на останньому малюнку все кільце разом.',
      'steps.v2_button.size': 'кнопка 12 × 12, вигляд згори',
      'steps.v2_button.press': 'натисніть',
      'steps.v2_button.beep': 'пік',
      'steps.v2_button.cut': 'різати тут',
      'v2.solder.button.title': 'Кнопка зверху',
      'steps.v2_button.1': 'Кнопка 12 × 12, вигляд згори: з двох боків по дві ніжки, 5 мм одна від одної.',
      'steps.v2_button.2': 'Мультиметром у режимі прозвонки знайдіть пару ніжок, яка замикається лише під час натискання: не натиснуто — тиша, натиснули — пищить. Зазвичай це дві ніжки з одного боку, як на малюнку.',
      'steps.v2_button.3': 'Дві інші ніжки обріжте бокорізами до 0,5 мм або коротше. Пара, що замикається, лишається цілою.',
      'steps.v2_button.4': 'До однієї ніжки пари припаяйте дріт, що піде на GPIO8 DevKitC, до другої — дріт, що піде на GND. Яку куди, неважливо. Пайку тримайте маленькою й плоскою.',
      'steps.v2_button.alt': 'Покрокова пайка кнопки 12 на 12: знайти мультиметром пару ніжок, що замикається лише під час натискання, обрізати дві інші, припаяти дроти на GPIO8 і на GND.',
      'steps.v2_speaker.back': 'динамік ззаду',
      'steps.v2_speaker.magnet': 'магніт',
      'steps.v2_speaker.marks': 'позначки «+» і «−»',
      'steps.v2_speaker.plus': '+',
      'steps.v2_speaker.minus': '−',
      'v2.solder.speaker.title': 'Динамік',
      'steps.v2_speaker.1': 'Динамік ззаду: магніт і дві пелюстки для пайки, а біля пелюсток надруковано «+» і «−».',
      'steps.v2_speaker.2': 'Дріт, що піде в клему «+» підсилювача, припаяйте до пелюстки з позначкою «+», а дріт для клеми «−» — до пелюстки з позначкою «−». Полярність тут не критична: динамік грає за будь-якого підключення, але так легше не заплутатися.',
      'steps.v2_speaker.alt': 'Покрокова пайка динаміка: вигляд ззаду з двома пелюстками й позначками «+» і «−» біля них, дріт для клеми «+» на пелюстку «+», дріт для «−» на пелюстку «−», обидва йдуть у клемник підсилювача.',
      'steps.v2_devkit.row2': 'ряд 2 · ліворуч',
      'steps.v2_devkit.row1': 'ряд 1 · праворуч',
      'steps.v2_devkit.antenna': 'антена',
      'steps.v2_devkit.board1': 'ESP32-S3',
      'steps.v2_devkit.board2': 'DevKitC',
      'steps.v2_devkit.usb': 'USB',
      'steps.v2_devkit.uart': 'UART (COM)',
      'steps.v2_devkit.n1': '1',
      'steps.v2_devkit.n22': '22',
      'steps.v2_devkit.p_3v3': '3V3',
      'steps.v2_devkit.p_gpio5': 'GPIO5',
      'steps.v2_devkit.p_gpio6': 'GPIO6',
      'steps.v2_devkit.p_gpio7': 'GPIO7',
      'steps.v2_devkit.p_gpio15': 'GPIO15',
      'steps.v2_devkit.p_gpio16': 'GPIO16',
      'steps.v2_devkit.p_gpio17': 'GPIO17',
      'steps.v2_devkit.p_gpio18': 'GPIO18',
      'steps.v2_devkit.p_gpio8': 'GPIO8',
      'steps.v2_devkit.p_5vin': '5Vin',
      'steps.v2_devkit.p_gnd': 'GND',
      'steps.v2_devkit.pin21': '21-й штир, ряд 1',
      'steps.v2_devkit.pin22': 'останній штир ряду 2, GND',
      'steps.v2_devkit.beep': 'пік',
      'steps.v2_devkit.silence': 'тиша',
      'steps.v2_devkit.inout': 'IN-OUT',
      'steps.v2_devkit.inout_join': 'з\'єднайте дві площадки',
      'steps.v2_devkit.inout_how': 'дротиком або ніжкою резистора',
      'steps.v2_devkit.inout_where': 'біля GPIO11 і GPIO12, поруч із діодами',
      'steps.v2_devkit.beep_ok': 'короткий пік на початку — теж норма',
      'steps.v2_devkit.magnet': 'дно магніту',
      'steps.v2_devkit.gap': 'лише 7 мм',
      'steps.v2_devkit.side_board': 'плата',
      'steps.v2_devkit.wrong': 'не вгору',
      'steps.v2_devkit.tip': 'пайка на кінчику штиря',
      'steps.v2_devkit.sideways': 'дріт одразу вбік',
      'steps.v2_devkit.term_plus': '+',
      'steps.v2_devkit.term_minus': '−',
      'steps.v2_devkit.term_note': '«+» і «−» — за написами на платі',
      'steps.v2_devkit.all': 'усі дроти разом',
      'v2.solder.devkit.title': 'Дроти на DevKitC',
      'steps.v2_devkit.1': 'Покладіть DevKitC написами догори, роз\'ємами USB-C до себе: антена — у дальньому кінці. Праворуч ряд 1, з боку роз\'єму UART (він же COM), ліворуч ряд 2. Штирі рахують від антени: перший біля антени, двадцять другий біля USB-C. Так само плата лежить у лотку, якщо дивитися на колонку ззаду. Обведено штирі, на які йдуть дроти.',
      'steps.v2_devkit.3': 'Спершу перевірте один штир. Дріт землі підсилювача паяють на 21-й штир правого ряду (ряд 1), а на деяких платах напис біля нього схований під роз\'ємом USB. Увімкніть мультиметр у режим прозвонки, той, що пищить. Один щуп прикладіть до 21-го штиря правого ряду, рахуючи від антени, другий — до останнього штиря лівого ряду з написом GND. Має пищати: тоді це земля, і дріт іде туди. Якщо не пищить, цей штир не використовуйте: дріт землі підсилювача відріжте довжиною 8 см замість 5,5 см і паяйте його третім дротом на той самий останній штир лівого ряду (GND).',
      'steps.v2_devkit.4': 'Кожен дріт паяйте до кінчика довгого штиря й одразу відводьте вбік, а не вгору: у корпусі над кінчиками штирів лише 7 мм до дна магніту динаміка. Пайку тримайте маленькою. Порядок такий: дроти підсилювача, два дроти на 5Vin, дроти транзистора, мікрофонів і кнопки, а наостанок динамік у клемник. На малюнках біля кожного дроту підписано, звідки він іде, і його довжину.',
      'steps.v2_devkit.5': 'Дроти підсилювача: BCLK на GPIO15, LRC на GPIO16, DIN на GPIO17 (штирі 8, 9 і 10 ряду 2), GND на 21-й штир ряду 1.',
      'steps.v2_devkit.6': 'На 5Vin (штир 21 ряду 2) ідуть два дроти: від Vin підсилювача й від «+» нитки через її резистор 47 Ом. Скрутіть їхні зачищені кінці разом і паяйте на кінчик штиря одночасно.',
      'steps.v2_devkit.7': 'Дроти транзистора: від G (через 47 Ом) на GPIO18 (штир 11 ряду 2), від S на GND (штир 22 ряду 2).',
      'steps.v2_devkit.8': 'Дроти мікрофонів. Кожен мікрофон з\'єднано прямо з DevKitC, тож на GPIO5, GPIO6, GPIO7 і на перший штир ряду 1 іде по два дроти, по одному від мікрофона L і мікрофона R: скрутіть їхні зачищені кінці разом і тоді припаюйте до штиря. Живлення VDD кожного мікрофона йде на свій штир 3V3: L на перший, R на другий штир ряду 2.',
      'steps.v2_devkit.9': 'Дроти кнопки: один на GPIO8 (штир 12 ряду 2), другий на GND (штир 22 ряду 2), поруч із дротом від S транзистора.',
      'steps.v2_devkit.10': 'Наостанок закрутіть дроти динаміка в клемник підсилювача маленькою пласкою викруткою: дріт від пелюстки «+» у клему «+», другий у «−». Це можна зробити й пізніше, на етапі «Верх» збирання.',
      'steps.v2_devkit.2': 'Перемичка IN-OUT. На цій платі живлення з USB доходить до штиря 5Vin лише тоді, коли з\'єднано дві маленькі площадки з написом IN-OUT. Вони біля штирів GPIO11 і GPIO12 лівого ряду, поруч із трьома діодами. Без перемички плата запускається, але підсилювач і кільце лишаються без 5 В: кільце не світиться, а звук рветься й хрипить. Площадки стоять надто далеко, щоб їх з\'єднала крапля припою, тож покладіть між ними короткий дротик чи обрізок ніжки резистора й припаяйте обидва кінці. Пару з написом USB-OTG, якщо вона є, не чіпайте. Поки площадки з\'єднано, не подавайте на 5Vin живлення від іншого джерела, коли під\'єднано USB.',
      'steps.v2_devkit.11': 'Перевірка без живлення, USB не підключайте: прозвонка між 5Vin і GND. Має бути тиша; короткий писк на самому початку — теж нормально, так заряджається конденсатор. Безперервний писк означає замикання.',
      'steps.v2_devkit.12': 'Прозвонка між 3V3 і GND: теж тиша. Якщо пищить, шукайте замикання між цими штирями й сусідніми пайками.',
      'steps.v2_devkit.13': 'Усі дроти на DevKitC разом: звідки кожен іде й яка в нього довжина. За цим малюнком зручно звіряти пайку.',
      'steps.v2_devkit.alt': 'Покрокові дроти на DevKitC: плата написами догори, ряди 1 і 2, перемичка IN-OUT, перевірка 21-го штиря правого ряду мультиметром, пайка до кінчика штиря з дротом убік, дроти підсилювача, два дроти на 5Vin, дроти транзистора, мікрофонів парами, кнопки, динамік у клемник, перевірки мультиметром і всі дроти разом, кожен із підписом, звідки він іде, і довжиною.',
      'v2.assembly.intro': 'Усе вже надруковане, а всі деталі спаяні з дротами за розділом «Пайка», разом із дротами на DevKitC. Тож деталі ставлять у корпус уже з дротами, і плати весь час з\'єднані між собою. Малюнки — знімки 3D-моделі корпусу: деталь, яку ставлять на цьому кроці, виділено помаранчевим, решта сіра. Дротів на малюнках немає, а деякі деталі для наочності підняті над своїм місцем. Ліве й праве тут — якщо дивитися ззаду, з боку USB-C. Збирання йде трьома етапами: спершу лоток, потім тіло на лоток, а верх закриває все наостанок.',
      'v2.assembly.tray.title': 'Лоток',
      'v2.assembly.stage_1': 'Етап 1 з 3',
      'v2.assembly.body.title': 'Тіло на лоток',
      'v2.assembly.stage_2': 'Етап 2 з 3',
      'v2.assembly.photo.caption': 'Так виглядає колонка перед тим, як закрити верх: усе спаяно, плати в лотку, мікрофони приклеєні.',
      'v2.assembly.photo.alt': 'Фото згори: тіло стоїть на лотку, посередині плата DevKitC, поруч підсилювач і транзистор, дроти йдуть до мікрофонів на стінці, а кілька дротів виходять нагору, до динаміка й кнопки.',
      'v2.assembly.top.title': 'Верх',
      'v2.assembly.stage_3': 'Етап 3 з 3',
      'steps.v2_asm_tray.1': 'Якщо DevKitC ще не в лотку, втисніть його в напрямні лотка антеною вперед, доки защіпки не клацнуть.',
      'steps.v2_asm_tray.2': 'Так само підсилювач, якщо він ще не на місці: нахиліть його й заведіть край під виступ на рейці DevKitC, потім натисніть на протилежний край, доки він не клацне під зачепом. Щоб вийняти, відведіть зачеп до стінки тонкою викруткою.',
      'steps.v2_asm_tray.3': 'Якщо транзистор ще не приклеєно, приклейте його термоклеєм до дна: металевою пластиною донизу, ніжками вперед.',
      'steps.v2_asm_tray.4': 'Покладіть прокладку лотка в її паз: вона лягає вільно, із зазором з обох боків. Повторіть перевірки мультиметром з кінця розділу «Пайка»: без USB між 5Vin і GND і між 3V3 і GND — тиша.',
      'steps.v2_asm_tray.alt_1': 'Помаранчевий DevKitC лежить у напрямних лотка.',
      'steps.v2_asm_tray.alt_2': 'Помаранчевий підсилювач із конденсатором над своїм гніздом у лотку поруч із DevKitC: з боку рейки виступ, з протилежного боку зачеп.',
      'steps.v2_asm_tray.alt_3': 'Помаранчевий транзистор на краплі клею на дні лотка.',
      'steps.v2_asm_tray.alt_4': 'Помаранчеве кільце прокладки над пазом лотка.',
      'steps.v2_asm_body.1': 'Переверніть тіло відкритим низом догори й вплавте чотири вставки в бобишки біля нижнього краю: нагрійте латунну вставку M2.5 паяльником (насадкою для вставок або звичайним жалом), поставте рівно над отвором і повільно вдавіть до рівня краю.',
      'steps.v2_asm_body.2': 'Поверніть тіло низом донизу й вплавте три вставки у верхівки стійок під гвинти верху.',
      'steps.v2_asm_body.3': 'Поставте тіло низом донизу так, щоб два маленькі отвори мікрофонів на стінці були з дальнього від вас боку, а розрив кільця (ділянка ззаду без каналу для нитки) — з ближнього. Тепер ви дивитеся на тіло ззаду, і ліве гніздо — те, що ліворуч від вас. Вставте в нього мікрофон з позначкою «L»: отвором для звуку до стінки, боком з чипом досередини. Його дроти вільно звисають з відкритого низу тіла.',
      'steps.v2_asm_body.4': 'Так само вставте мікрофон з позначкою «R» у праве гніздо.',
      'steps.v2_asm_body.5': 'Закріпіть кожен мікрофон рідким термоклеєм лише по краю плати, подалі від отвору: під плату й до отвору клей потрапити не має, бо закриє шлях звуку.',
      'steps.v2_asm_body.6': 'Тіло стоїть так само, як для мікрофонів: ви дивитеся ззаду, з боку розриву кільця. Покладіть нитку в канал кінцем «+» (з резистором) ліворуч, з боку мікрофона L, а обидва кінці з дротами пропустіть усередину крізь прорізи ззаду. Дроти звисають з відкритого низу тіла.',
      'steps.v2_asm_body.7': 'Втисніть дугу кільця в канал поверх нитки.',
      'steps.v2_asm_body.8': 'Динамік і кнопку з їхніми дротами просуньте крізь тіло знизу, щоб вони вийшли з відкритого верху. Покладіть тіло на бік біля переднього лівого краю лотка (там, де мікрофон L), відкритим низом до лотка, і перекиньте його на лоток уздовж цього краю. Зайвий дріт укладайте вздовж стінки, подалі від прокладки: над штирями DevKitC до магніту динаміка буде лише 7 мм.',
      'steps.v2_asm_body.9': 'Переверніть тіло разом із лотком догори дном, притримуючи динамік і кнопку, щоб вони не висіли на дротах, і закрутіть чотири гвинти лотка хрестовою викруткою.',
      'steps.v2_asm_body.10': 'Втисніть чотири ніжки в їхні ніші.',
      'steps.v2_asm_body.11': 'Втисніть втулку в отвір USB-C ззовні: кабель під\'єднують крізь неї.',
      'steps.v2_asm_body.alt_1': 'Тіло корпусу, перевернуте відкритим низом догори: над чотирма бобишками біля краю зависли помаранчеві вставки.',
      'steps.v2_asm_body.alt_2': 'Тіло низом донизу: над трьома стійками зависли помаранчеві вставки.',
      'steps.v2_asm_body.alt_3': 'Тіло зсередини: помаранчева плата мікрофона біля лівого гнізда на стінці.',
      'steps.v2_asm_body.alt_4': 'Помаранчева плата мікрофона в правому гнізді, лівий мікрофон уже на місці.',
      'steps.v2_asm_body.alt_5': 'Помаранчеві кільця термоклею по краю обох плат мікрофонів.',
      'steps.v2_asm_body.alt_6': 'Помаранчева нитка над каналом кільця на обідку тіла, її кінці загнуті досередини ззаду.',
      'steps.v2_asm_body.alt_7': 'Помаранчева дуга кільця над каналом, поверх нитки.',
      'steps.v2_asm_body.alt_8': 'Помаранчеве тіло над лотком із платами.',
      'steps.v2_asm_body.alt_9': 'Тіло з лотком догори дном, над ним чотири помаранчеві гвинти лотка.',
      'steps.v2_asm_body.alt_10': 'Чотири помаранчеві ніжки над нішами на дні перевернутого лотка.',
      'steps.v2_asm_body.alt_11': 'Помаранчева втулка й штекер кабелю перед отвором USB-C ззаду.',
      'steps.v2_asm_top.1': 'Покладіть верх лицем донизу й вплавте дві вставки в стійки під вушка динаміка.',
      'steps.v2_asm_top.2': 'Вставте ковпачок кнопки в його отвір зсередини.',
      'steps.v2_asm_top.3': 'Втисніть перемикач із припаяними дротами в тримач, доки обидва гачки не клацнуть над ним.',
      'steps.v2_asm_top.4': 'Покладіть по краплі термоклею біля кожного гачка й перевірте сильним натиском на ковпачок: перемикач має лишатися на місці.',
      'steps.v2_asm_top.5': 'Покладіть прокладку динаміка на бортик навколо решітки.',
      'steps.v2_asm_top.6': 'Поставте динамік із припаяними дротами на прокладку так, щоб його вушка лягли на стійки.',
      'steps.v2_asm_top.7': 'Надягніть на кожен гвинт шайбу й закрутіть обидва гвинти хрестовою викруткою крізь вушка динаміка, доки вушка не ляжуть рівно.',
      'steps.v2_asm_top.8': 'Покладіть прокладку верху в паз по краю: вона лягає вільно, із зазором з обох боків, і притискається, коли верх прикручують.',
      'steps.v2_asm_top.9': 'Якщо дроти динаміка ще не в клемнику підсилювача, закрутіть їх: дріт від пелюстки «+» у клему «+», другий у «−». Якщо колонку вже прошито (розділ «Прошивка»), її можна ввімкнути й перевірити кільце та звук, поки все легко дістати. Потім укладіть дроти динаміка й кнопки вниз у тіло, уздовж стінки, і покладіть верх на тіло.',
      'steps.v2_asm_top.10': 'Закрутіть три гвинти верху згори хрестовою викруткою.',
      'steps.v2_asm_top.11': 'Втисніть три заглушки в гнізда над гвинтами чимось пласким, наприклад лінійкою, покладеною на лице верху: тоді вони зупиняться врівень з ним.',
      'steps.v2_asm_top.alt_1': 'Верх лежить лицем донизу, над двома стійками біля решітки зависли помаранчеві вставки.',
      'steps.v2_asm_top.alt_2': 'Верх лицем донизу, помаранчевий ковпачок кнопки в її отворі.',
      'steps.v2_asm_top.alt_3': 'Помаранчевий перемикач кнопки над тримачем, ніжками вгору.',
      'steps.v2_asm_top.alt_4': 'Дві помаранчеві краплі клею біля гачків тримача перемикача.',
      'steps.v2_asm_top.alt_5': 'Помаранчеве кільце прокладки динаміка над бортиком навколо решітки.',
      'steps.v2_asm_top.alt_6': 'Помаранчевий динамік на прокладці магнітом догори, вушками на стійках.',
      'steps.v2_asm_top.alt_7': 'Над вушками динаміка зависли два помаранчеві гвинти з шайбами.',
      'steps.v2_asm_top.alt_8': 'Помаранчеве кільце прокладки верху над пазом по краю.',
      'steps.v2_asm_top.alt_9': 'Помаранчевий верх з динаміком завис над тілом, що стоїть на лотку.',
      'steps.v2_asm_top.alt_10': 'Над зібраним корпусом зависли три помаранчеві гвинти верху.',
      'steps.v2_asm_top.alt_11': 'Над гніздами гвинтів зависли три помаранчеві заглушки.',
      'v2.firmware.intro': 'Кнопка нижче записує прошивку в колонку прямо з браузера через кабель USB-C, а в тому ж вікні ви передаєте колонці назву й пароль своєї мережі Wi-Fi.',
      'v2.firmware.need.title': 'Що потрібно',
      'v2.firmware.need.browser': 'Комп\'ютер (Windows, macOS чи Linux) із браузером Chrome або Edge.',
      'v2.firmware.need.cable': 'Кабель USB-C, що передає дані: кабель лише для заряджання не підійде.',
      'v2.firmware.need.wifi': 'Мережа Wi-Fi на 2,4 ГГц: мереж на 5 ГГц плата не бачить.',
      'v2.firmware.need.key': 'Ключ API OpenAI. Розмови оплачуються окремо, за тарифами OpenAI (GPT-Live — 0,05 $ за хвилину розмови плюс невелика плата за допоміжну модель), тож для колонки краще завести окремий проєкт з обмеженням витрат.',
      'v2.firmware.need.key_link': 'Ключі API на сайті OpenAI',
      'v2.firmware.steps.title': 'Як встановити',
      'v2.firmware.step1': 'Під\'єднайте колонку до комп\'ютера кабелем USB-C: роз\'єм ззаду корпусу. Це той із двох роз\'ємів плати, що підписаний UART (або COM): через нього записують прошивку й налаштовують Wi-Fi. Колонка живиться від цього ж кабелю.',
      'v2.firmware.step2': 'Натисніть «Встановити прошивку». Браузер покаже список портів: виберіть той, що з\'явився після під\'єднання колонки, і підтвердіть вибір.',
      'v2.firmware.step3': 'Відкриється англомовне вікно встановлення. Натисніть у ньому «Install Pytaichenko.Speaker». Під час першого встановлення поставте галочку «Erase device», щоб стерти з плати старі дані, і натисніть «Next», а потім «Install».',
      'v2.firmware.step4': 'Дочекайтеся кінця запису: це триває кілька хвилин. Тим часом не закривайте сторінку й не перемикайтеся на іншу вкладку. Коли з\'явиться «Installation complete!», натисніть «Next».',
      'v2.firmware.step5': 'У вікні «Configure Wi-Fi» виберіть свою мережу в списку «Network», впишіть пароль у поле «Password» і натисніть «Connect». Якщо мережі немає в списку, виберіть «Join other…» і впишіть її назву. Коли з\'явиться «Device connected to the network!», натисніть «Continue».',
      'v2.firmware.step6': 'Після «Continue» вікно покаже меню колонки. Натисніть у ньому «Visit Device»: відкриється сторінка налаштувань колонки за її власною адресою http://pytaichenko-xxxxxx.local, де замість xxxxxx стоять шість знаків, свої в кожної колонки. Одразу додайте цю сторінку в закладки. Якщо вікно вже закрили, під\'єднайте колонку кабелем знову, натисніть «Встановити прошивку» й виберіть порт: вікно впізнає колонку й знову покаже «Visit Device». Ще один спосіб — список пристроїв у роутері: ім\'я колонки починається з pytaichenko-, а поруч видно її IP-адресу, яку можна відкрити замість імені. На деяких телефонах з Android адреси .local не відкриваються, тож там теж відкривайте сторінку за IP-адресою.',
      'v2.firmware.setup.title': 'Як налаштувати',
      'v2.firmware.setup.open': 'На будь-якому пристрої у вашій мережі відкрийте в браузері сторінку колонки за адресою нижче. Якщо адреса з .local не відкривається, відкрийте сторінку за IP-адресою колонки з налаштувань роутера.',
      'v2.firmware.setup.password': 'Сторінка попросить створити пароль: придумайте його (щонайменше 8 символів), впишіть двічі й натисніть «Створити пароль». Далі налаштування відкриваються лише з цим паролем.',
      'v2.firmware.setup.key': 'У розділі «Розмова» вставте ключ у поле «Ключ OpenAI» і натисніть «Зберегти». Ключ зберігається лише в колонці, і сторінка його назад не показує.',
      'v2.firmware.setup.check': 'Натисніть «Перевірити з\'єднання з OpenAI». За кілька секунд сторінка напише «З\'єднання працює» з назвами моделі й голосу; якщо ні, повідомлення біля кнопки скаже, що не так.',
      'v2.firmware.setup.wake': 'У розділі «Звук» оберіть фразу в полі «Фраза, після якої колонка слухає»: Hey Jarvis, Okay Nabu або Hey Mycroft, і натисніть «Зберегти» в тому ж блоці. Спершу там стоїть Hey Jarvis.',
      'v2.firmware.setup.language': 'Асистент слухає й відповідає мовою, якою була сторінка, коли ви створили пароль. Щоб обрати іншу, у розділі «Розмова» змініть поле «Мова розмови» й натисніть «Зберегти» в тому ж блоці.',
      'v2.firmware.setup.ready': 'Коли ключ збережено й колонка в мережі, кільце перестає «дихати» й гасне: колонка чекає ключову фразу.',
      'v2.firmware.first.title': 'Перша розмова',
      'v2.firmware.first.say': 'Скажіть обрану ключову фразу або коротко натисніть кнопку зверху. Колонка подасть м\'який сигнал із двох нот угору, а кільце засвітиться повністю: вона вас слухає.',
      'v2.firmware.first.ask': 'Почніть говорити трохи після сигналу й задайте питання вголос. Коли ви замовкли, кільце «дихає», то яскравіше, то тьмяніше: колонка думає. Коли вона відповідає, кільце світиться трохи тьмяніше, ніж під час слухання.',
      'v2.firmware.first.more': 'Після відповіді кілька секунд можна питати далі без ключової фрази: кільце тоді світиться слабко.',
      'v2.firmware.first.stop': 'Щоб завершити, скажіть «Дякую, все»: прозвучить сигнал із двох нот униз, і кільце згасне. Кнопка зверху так само зупиняє розмову, коли колонка слухає чи відповідає, а коли колонка мовчить, кнопка її починає.',
      'v2.firmware.first.volume': 'Гучність міняють голосом («гучніше», «тихіше») або повзунком «Гучність відповіді» в розділі «Звук» сторінки налаштувань.',
      'v2.firmware.ring.caption': 'Що показує кільце',
      'v2.firmware.ring.col.ring': 'Кільце',
      'v2.firmware.ring.col.meaning': 'Що це означає',
      'v2.firmware.ring.r1.look': 'повільно «дихає», раз на 4 с',
      'v2.firmware.ring.r1.mean': 'колонка ще не готова: немає Wi-Fi або ключа OpenAI; так буває й кілька секунд після ввімкнення',
      'v2.firmware.ring.r2.look': 'не світиться',
      'v2.firmware.ring.r2.mean': 'колонка чекає ключову фразу',
      'v2.firmware.ring.r3.look': 'світиться повністю',
      'v2.firmware.ring.r3.mean': 'колонка вас слухає',
      'v2.firmware.ring.r4.look': '«дихає» швидше й яскравіше',
      'v2.firmware.ring.r4.mean': 'колонка думає над відповіддю',
      'v2.firmware.ring.r5.look': 'світиться трохи тьмяніше',
      'v2.firmware.ring.r5.mean': 'колонка відповідає',
      'v2.firmware.ring.r6.look': 'світиться слабко',
      'v2.firmware.ring.r6.mean': 'колонка чекає продовження без ключової фрази',
      'v2.firmware.ring.r7.look': 'три м\'які спалахи',
      'v2.firmware.ring.r7.mean': 'сталася помилка; за мить колонка знову чекає ключову фразу, а якщо зник Wi-Fi, повільно «дихає»',
      'v2.firmware.ring.r8.look': 'п\'ять швидких спалахів',
      'v2.firmware.ring.r8.mean': 'пароль сторінки скинуто кнопкою зверху',
      'v2.firmware.update.title': 'Оновлення прошивки',
      'v2.firmware.update.page': 'Найпростіше — зі сторінки налаштувань: розділ «Про колонку», блок «Оновлення». Натисніть «Перевірити оновлення»; якщо є нова версія, з\'явиться кнопка «Оновити до …». Колонка сама завантажить прошивку з GitHub, перезапуститься й за кілька хвилин працює знову. Налаштування й пароль лишаються, а якщо нова версія не запуститься, колонка сама повернеться до попередньої.',
      'v2.firmware.update.file': 'Якщо колонка не дістає до GitHub, завантажте на комп\'ютер файл pytaichenko-2.….ota.bin зі сторінки релізу на GitHub, виберіть його в полі «Прошивка з файлу» того ж блоку й натисніть «Завантажити файл».',
      'v2.firmware.update.usb': 'Можна й тією ж кнопкою «Встановити прошивку» через кабель: у вікні натисніть «Update Pytaichenko.Speaker», а потім «Install». Якщо замість нього є лише «Install Pytaichenko.Speaker» і далі вікно питає про «Erase device», галочку не ставте: тоді колонка збереже мережу Wi-Fi, пароль сторінки, ключ OpenAI й усі налаштування. Якщо немає жодного з цих пунктів, на колонці вже ця версія: просто закрийте вікно.',
      'v2.firmware.trouble.title': 'Якщо не вийшло',
      'v2.firmware.trouble.port.symptom': 'Колонки немає в списку портів',
      'v2.firmware.trouble.port.fix': 'Спробуйте інший кабель: чимало кабелів USB-C лише заряджають і не передають даних. Кабель має бути в роз\'ємі ззаду корпусу, тобто в порту плати з написом UART (COM). На Linux, якщо порт у списку є, але не відкривається, додайте свого користувача до групи dialout командою нижче, а потім вийдіть із системи й увійдіть знову.',
      'v2.firmware.trouble.wifi.symptom': 'Треба змінити мережу Wi-Fi або пароль',
      'v2.firmware.trouble.wifi.fix': 'Прошивку вдруге записувати не треба. Під\'єднайте колонку кабелем, натисніть «Встановити прошивку», виберіть порт, а у вікні виберіть «Change Wi-Fi» (або «Connect to Wi-Fi», якщо колонка зараз не в мережі). Колонка запам\'ятовує нову мережу, лише коли під\'єдналася до неї, а інакше лишається в попередній.',
      'v2.trouble.sound.symptom': 'Відповіді не чути',
      'v2.trouble.sound.fix': 'Спершу гляньте на сторінці налаштувань у розділі «Звук» на повзунок «Гучність відповіді»: він не має стояти на нулі. Якщо кільце під час відповіді світиться, а звуку немає, вимкніть живлення й перевірте дроти підсилювача за картою штирів у розділі «Пайка»: LRC на GPIO16, BCLK на GPIO15, DIN на GPIO17, Vin на 5Vin, GND на GND, а також що дроти динаміка щільно затиснуті в клемнику. GAIN і SD мають лишатися вільними. Якщо звук рветься й хрипить, а кільце не світиться, на 5Vin немає 5 В: перевірте перемичку IN-OUT (крок 2 пайки DevKitC). Мультиметр між 5Vin і GND при під\'єднаному USB має показати 4,7–5 В.',
      'v2.trouble.wake.symptom': 'Колонка погано чує ключову фразу',
      'v2.trouble.wake.fix': 'Скажіть фразу ще раз, ближче до колонки й чіткіше, або почніть розмову кнопкою зверху. Якщо так щоразу, відкрийте на сторінці налаштувань розділ «Журнал»: після кожної розмови там є рядок raw microphones з піком лівого й правого мікрофона. Якщо один із них пише peak 0 (silence) або набагато тихіший за інший, перевірте його дроти й перемичку L/R: на мікрофоні L вона з\'єднує L/R із GND, на мікрофоні R — із VDD. Перевірте й те, що клей не закрив отвір для звуку. Можна також обрати іншу фразу в розділі «Звук»: Hey Jarvis, Okay Nabu або Hey Mycroft.',
      'v2.trouble.wifi.symptom': 'Колонка не під\'єднується до Wi-Fi або адреса .local не відкривається',
      'v2.trouble.wifi.fix': 'Колонка працює лише з мережами на 2,4 ГГц. Адреса з .local відкривається не на кожному пристрої й не в кожній мережі: тоді відкрийте сторінку за IP-адресою колонки, її видно в списку пристроїв роутера (ім\'я починається з pytaichenko-). Сторінка відкривається лише за IP-адресою або за ім\'ям з .local, а за іншим ім\'ям, яке дає роутер, пише «Колонка не приймає цю адресу». Якщо колонка зовсім не в мережі, задайте Wi-Fi заново кнопкою «Встановити прошивку», як у розділі «Прошивка»: стирати нічого не треба.',
      'v2.trouble.password.symptom': 'Забули пароль сторінки налаштувань',
      'v2.trouble.password.fix': 'Утримуйте кнопку зверху близько 10 секунд, доки кільце не блимне п\'ять разів поспіль: пароль сторінки скинуто. Відкрийте сторінку й створіть новий пароль; Wi-Fi, ключ OpenAI й інші налаштування лишаються. Якщо так не вийшло, прошийте колонку заново зі стиранням: натисніть «Встановити прошивку», виберіть порт і у вікні натисніть червоний пункт «Erase User Data», а якщо його немає — «Install Pytaichenko.Speaker» з галочкою «Erase device». Тоді скидаються всі налаштування, ключ і мережа Wi-Fi, і їх доведеться задати знову.',
      'v2.trouble.ring.symptom': 'Кільце весь час повільно «дихає»',
      'v2.trouble.ring.fix': 'Так колонка показує, що вона не готова: немає Wi-Fi або ключа OpenAI. Якщо сторінка налаштувань відкривається, Wi-Fi є, і вгорі сторінки тоді написано «Ключ OpenAI ще не задано, тож колонка не зможе відповідати.»: впишіть ключ у розділі «Розмова». Причину видно й у розділі «Журнал»: рядок not ready: no Wi-Fi або not ready: the OpenAI key is not set. Якщо там є рядок the speaker could not start: …; the ring shows the error and the button can still reset the password, колонка запустилася не повністю (після двокрапки видно, яка частина не стартувала): від\'єднайте кабель і під\'єднайте знову, а кнопка зверху в цьому стані ще вміє скинути пароль сторінки. Якщо сторінка не відкривається, див. пункт про Wi-Fi вище.',
      'v2.trouble.update.symptom': 'Оновлення з файлу пише «Цей файл не підходить»',
      'v2.trouble.update.fix': 'Колонка приймає лише файл pytaichenko-2.….ota.bin з релізу версії 2 і перевіряє його, перш ніж щось записати, тож нічого не змінено й колонка працює далі. Файл pytaichenko-….factory.bin для оновлення зі сторінки не підходить: його записують лише кабелем. Можна й просто оновитися кнопкою «Встановити прошивку», без стирання.'
    },
    en: {
      'meta.title': 'Pytaichenko — a voice speaker for talking with GPT',
      'meta.description': 'Pytaichenko is a voice speaker made from ready-made boards in a 3D-printed case: how it was made and how to repeat it.',

      'header.name': 'Pytaichenko',
      'header.repo': 'GitHub',
      'header.donate': 'Donate',
      'header.repo_soon': 'link not added yet',
      'header.lang_label': 'Language',
      'header.theme_label': 'Light theme',
      'header.version_label': 'Speaker version',
      'header.version_2': 'Version 2',
      'header.version_1': 'Version 1',

      'hero.title': 'A voice speaker for talking with GPT',
      'hero.lead': 'The speaker is built from ready-made boards, and its case is printed on a 3D printer. This version works together with a home server that holds the conversation with OpenAI. This page describes how it was made and how to repeat it.',
      'hero.image': 'Pytaichenko on a desk: a round black case with the speaker grille on top and the white ring strip under the lid',

      'toc.title': 'Contents',
      'toc.about': 'About',
      'can.title': 'What it does',
      'can.item1': 'Starts with a wake phrase or a button press',
      'can.wake': 'The wake phrase can be one of three: Hey Jarvis, Okay Nabu or Hey Mycroft',
      'can.item2': 'Answers out loud',
      'can.item3': 'A light ring shows what the speaker is doing',
      'can.item4': 'After an answer you can keep asking without the phrase',
      'can.item5': '“Thank you, that’s all” ends the conversation',
      'can.item6': 'The volume changes by voice',

      'need.title': 'Before you start',
      'need.v1_server': 'This version needs a home server: a computer in your home network that is always on, with Docker. It runs the voice-hub service, which holds the conversation with OpenAI; the Server section shows how to start it.',
      'need.time_label': 'Approximate print time',
      'need.time_value': 'about 7–8 hours',
      'need.cost_label': 'Approximate cost of parts',
      'need.cost_pending': 'To be confirmed',
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
