feroxes/pytaichenko/(commit log)

2026-11-02 pytaichenko 1.0.0
    [PETG-black_body.stl, PETG-black_button_cap.stl, PETG-black_top.stl, PETG-black_tray.stl, PETG-white_ring_arc_x2.stl, TPU_foot_x4.stl, TPU_speaker_gasket.stl, TPU_top_plug_x2.stl]
2026-11-10 pytaichenko 2.0.0
    [PETG-black_body.stl, PETG-black_button_cap.stl, PETG-black_top.stl, PETG-black_top_plug_x3.stl, PETG-black_tray.stl, PETG-white_ring_arc.stl, PETG-white_ring_arc_x2.stl, TPU_com_bushing.stl]
2026-11-10 case v2: header slot ends take the usb push, end latches only hold the board down
    [PETG-black_tray.stl, params.scad, pytaichenko-case.scad, tray.scad]
2026-11-12 live: end with no answer after a turn cap, resume speaking, end stalled audio
2026-11-12 network stack on core 0, 192 ms microphone dma buffer
2026-11-12 live: keep history for the retry after a dead warm socket, log warm failures after each open
