feroxes/pytaichenko/(notices)

Notices in the files:
README.md:
Case and guides: CC BY-SA 4.0
